flavioalsoares/hsm-a7/doc/manual/08-apendices.md

# Apêndices

## A. Glossário

**APT** — *Adaptive Proportion Test*. Teste de saúde de fonte de entropia
(SP 800-90B) que dispara quando um valor domina uma janela de amostras.

**BBRAM** — memória volátil do FPGA onde pode ficar a chave de decifra do
bitstream. Perde conteúdo sem alimentação, e por isso é recuperável — ao
contrário do eFUSE.

**BDK** — *Base Derivation Key*. Chave de pagamentos da qual se derivam
chaves de terminal, tipicamente por DUKPT.

**CFS** — *Custom Functions Subsystem*. Slot do NEORV32 projetado para
receber coprocessadores do usuário. É onde AES e SHA entram na Fase 2.

**CMAC** — código de autenticação de mensagem baseado em cifra de bloco.
Usado no TR-31 para autenticar cabeçalho e corpo, e para derivar KBEK/KBAK.

**CMVP** — programa NIST/CCCS que valida módulos contra a FIPS 140-3.

**CSP** — *Critical Security Parameter*. Termo da FIPS para qualquer segredo
cuja divulgação compromete a segurança: chave em claro, dado de autenticação,
estado do gerador.

**Dual control** — nenhuma operação sensível pode ser realizada por uma
pessoa sozinha. Ver seção 7.

**DRBG** — *Deterministic Random Bit Generator*. Gerador determinístico
semeado por entropia física, especificado na SP 800-90A.

**CVV / CVC** — três dígitos derivados de PAN, validade e código de serviço
sob um par de chaves. Inerentemente 3DES, e por isso fora do alcance deste
projeto (seção 37).

**Decimalização** — mapear os dígitos hexadecimais que uma cifra produz
para dígitos decimais, para formar um PIN. A tabela que faz esse mapeamento
foi a origem do ataque de Bond e Zieliński (seções 15.2 e 35.3).

**DUKPT** — *Derived Unique Key Per Transaction*. Esquema em que cada
transação usa uma chave distinta derivada de uma BDK, identificada por um
KSN. Duas normas: X9.24-1 (TDES, legado) e X9.24-3 (AES). Seção 36.

**eFUSE** — memória de programação única do FPGA. **Proibida neste
projeto**: erro vira brick permanente.

**EAL** — *Evaluation Assurance Level*, do Common Criteria. Mede o rigor da
avaliação, **não** a força da segurança.

**Fronteira criptográfica** — o limite físico e lógico dentro do qual
material de chave em claro existe. Ver seção 5.

**KAT** — *Known Answer Test*. Vetor de teste com entrada e saída conhecidas,
usado nos autotestes.

**KBEK / KBAK** — chaves de cifra e de autenticação de key block, derivadas
da LMK por propósito.

**KCV** — *Key Check Value*. Três bytes do resultado de cifrar um bloco de
zeros com a chave. Permite verificar sem revelar.

**KSN** — *Key Serial Number*. Identificador do dispositivo mais o contador
de transação, enviado junto com cada transação DUKPT. Com ele e a BDK, o HSM
rederiva a chave usada. Seção 36.

**KEK** — *Key Encryption Key*. Chave cuja função é proteger outras chaves.

**LMK** — *Local Master Key*. A chave mestra do módulo, no topo da
hierarquia. Nunca sai, nem embrulhada.

**MMCM** — *Mixed-Mode Clock Manager*. Bloco do FPGA Xilinx que sintetiza
clocks. Aqui, 50 → 100 MHz.

**PAN** — *Primary Account Number*. O número do cartão. Entra na formação
do PIN block para amarrar o PIN à conta. **Nunca usar um PAN real neste
projeto** (seção 37.4).

**PIN block** — formato que combina PIN e número da conta para transporte.
Os formatos da ISO 9564 e suas fraquezas estão na seção 33; os ataques
clássicos, na 15.3.

**PVV** — *PIN Verification Value*. Quatro dígitos derivados de PAN e PIN
sob uma chave PVK, guardados pelo emissor no lugar do PIN. Seção 35.1.

**PMP** — *Physical Memory Protection*. Mecanismo RISC-V de restrição de
acesso à memória por região.

**POST** — *Power-On Self-Test*. Bateria de KAT executada no boot, antes de
aceitar comandos.

**PUF** — *Physically Unclonable Function*. Raiz de confiança derivada de
variações de fabricação, em vez de armazenada.

**RCT** — *Repetition Count Test*. Teste de saúde que dispara na repetição
excessiva de uma amostra.

**Split knowledge** — nenhuma pessoa conhece uma chave inteira; ela é
montada de componentes.

**Tamper-evident / resistant / responsive** — a escada de proteção física.
Ver seção 18.1.

**Tradução de PIN** — decifrar um PIN block sob uma chave e recifrá-lo sob
outra, sem que o PIN saia da fronteira. É o comando mais perigoso de um HSM
de pagamento, porque é um oráculo por construção. Seção 34.

**TR-31** — formato de key block da indústria de pagamentos, hoje ANSI
X9.143. É o formato adotado por este projeto (seção 8).

**TRNG** — gerador de números aleatórios verdadeiro, baseado em fenômeno
físico.

**Zeroização** — destruição de material de chave de forma verificável. Ver
seção 12.

## B. Especificação do protocolo

Implementado em `fw/src/cmd.c` (firmware) e `host/hsmtool.py` (host).

### Enquadramento

```
pedido    LEN(2) | CMD(1)    | PAYLOAD | CRC32(4)
resposta  LEN(2) | STATUS(1) | PAYLOAD | CRC32(4)
```

- Todos os campos multi-byte em **big-endian**.
- `LEN` cobre `CMD`/`STATUS` + `PAYLOAD`. Não se inclui nem inclui o CRC.
- `LEN` válido: 1 a 513 (payload máximo de 512 bytes).
- **CRC32** cobre `LEN` + `CMD`/`STATUS` + `PAYLOAD` — todos os bytes menos
  os quatro dele próprio. Polinômio IEEE 802.3 refletido (`0xEDB88320`),
  inicialização `0xFFFFFFFF`, xor final `0xFFFFFFFF`. Idêntico ao
  `zlib.crc32` do Python.
- Timeout entre bytes no dispositivo: 250 ms. Timeout de resposta no host:
  2 s.

### Comandos da Fase 1

| Opcode | Nome | Payload do pedido | Payload da resposta |
|---|---|---|---|
| `0x01` | `PING` | vazio | `"PONG"` |
| `0x02` | `GET_VERSION` | vazio | major, minor, patch, estado |
| `0x03` | `GET_DNA` | vazio | 8 bytes: identidade do die, 57 bits big-endian |

O `GET_DNA` ficou respondendo `NOT_IMPLEMENTED` durante toda a Fase 1 e só
fechou com o CFS da Fase 2 (seção 25) — o `DNA_PORT` é primitiva Xilinx e
precisava de um caminho até a CPU. O valor **não é segredo**: qualquer um com
um cabo JTAG lê o mesmo número, e ele nunca muda. Serve para identificar a
placa em log e inventário. Derivar chave dele é um erro clássico, porque
público e constante são exatamente as duas propriedades que uma chave não
pode ter.

### Comandos da Fase 2 — primitivas

| Opcode | Nome | Payload do pedido | Payload da resposta |
|---|---|---|---|
| `0x10` | `AES_ENC` | chave(32) ‖ bloco(16) | bloco(16) |
| `0x11` | `AES_DEC` | chave(32) ‖ bloco(16) | bloco(16) |
| `0x12` | `SHA256` | mensagem | digest(32) |
| `0x13` | `HMAC` | klen(1) ‖ chave ‖ mensagem | mac(32) |
| `0x14` | `RANDOM` | n(2), máximo 256 | n bytes do CTR_DRBG |
| `0x15` | `SELFTEST` | vazio | máscara de falhas(2) |

⚠ **`AES_ENC`, `AES_DEC` e `HMAC` recebem a chave em claro no payload**, e
por isso só respondem em `UNINITIALIZED`. Não é convenção: é a máscara de
estados na tabela de comandos. Um comando que aceita chave em claro não pode
coexistir com chave de verdade no mesmo dispositivo — e no instante em que a
LMK é carregada, os três param de responder sozinhos. A Fase 3 os
**substitui** por versões que falam por handle de slot.

O `SELFTEST` é o único comando que responde em `TAMPERED`, e a exceção é
deliberada: sem ele, um dispositivo que reprovou no boot ficaria mudo sobre
*o que* reprovou, e o operador teria apenas um LED vermelho.

### Comandos da Fase 3 — hierarquia de chaves

| Opcode | Nome | Payload do pedido | Payload da resposta |
|---|---|---|---|
| `0x20` | `LMK_LOAD_COMPONENT` | n(1) ‖ componente(32) | kcv(3) ‖ carregados(1) ‖ estado(1) |
| `0x21` | `LMK_STATUS` | vazio | carregados(1) ‖ completa(1) ‖ kcv(3) |
| `0x22` | `GEN_KEY` | uso(2) ‖ alg(1) ‖ modo(1) ‖ exp(1) | handle(1) ‖ kcv(3) |
| `0x23` | `EXPORT_KEY` | handle(1) | key block X9.143 em ASCII |
| `0x24` | `IMPORT_KEY` | key block X9.143 em ASCII | handle(1) ‖ kcv(3) |
| `0x25` | `KEY_INFO` | handle(1) | uso(2) ‖ alg(1) ‖ modo(1) ‖ exp(1) ‖ len(1) ‖ kcv(3) ‖ usos(4) |
| `0x26` | `SET_STATE` | estado alvo(1) | estado atual(1) |
| `0x27` | `ENCRYPT` | handle(1) ‖ iv(16) ‖ dados | dados cifrados |
| `0x28` | `DECRYPT` | handle(1) ‖ iv(16) ‖ dados | dados em claro |
| `0x29` | `MAC_GENERATE` | handle(1) ‖ mensagem | tag(16) |
| `0x2A` | `MAC_VERIFY` | handle(1) ‖ tag(16) ‖ mensagem | vazio — o veredito é o status |
| `0x2B` | `DELETE_KEY` | handle(1) | slots livres(1) |
| `0x2C` | `KEY_FROM_COMPONENTS` | n(1) ‖ total(1) ‖ uso(2) ‖ alg(1) ‖ modo(1) ‖ exp(1) ‖ componente(32) | kcv(3) ‖ carregados(1) ‖ total(1) ‖ handle(1) |
| `0x2F` | `ZEROIZE` | vazio | estado atual(1) |

**Estados em que cada um responde.** Não é convenção — é uma máscara na
tabela de comandos, e é ela que faz a cerimônia ser uma escada de uma via.

| Comando | Estados |
|---|---|
| `LMK_LOAD_COMPONENT` | só `UNINITIALIZED` |
| `SET_STATE` | só `AUTHORIZED` |
| `GEN_KEY`, `EXPORT_KEY`, `IMPORT_KEY`, `KEY_INFO`, `ENCRYPT`, `DECRYPT`, `MAC_GENERATE`, `MAC_VERIFY`, `DELETE_KEY`, `KEY_FROM_COMPONENTS` | só `OPERATIONAL` |
| `LMK_STATUS` | os três normais |
| `ZEROIZE` | **todos**, `TAMPERED` inclusive |

Carregar os três componentes leva a `AUTHORIZED` e o `0x20` desaparece
sozinho; ativar leva a `OPERATIONAL` e o `0x26` desaparece do mesmo jeito.
Nenhum degrau se repete, e não há como descer sem apagar.

**Quais exigem dual control**, e a divisão diz mais que a lista:

| | |
|---|---|
| exigem | `LMK_LOAD_COMPONENT`, `SET_STATE`, `ZEROIZE`, `KEY_FROM_COMPONENTS` |
| não exigem | `GEN_KEY`, `EXPORT_KEY`, `IMPORT_KEY`, `KEY_INFO`, `ENCRYPT`, `DECRYPT`, `MAC_GENERATE`, `MAC_VERIFY`, `DELETE_KEY` |

Dual control é para **cerimônia**, não para operação. Carregar a chave
mestra, ativar o dispositivo e apagar tudo são eventos raros, com gente na
frente da placa. Gerar, exportar e importar chave é o que um HSM faz o dia
inteiro — exigir dois dedos ali não aumentaria segurança nenhuma, só
garantiria que ninguém usa o equipamento. E um controle que impede o uso
legítimo é desligado no primeiro dia ruim.

O que protege os quatro de baixo é outra coisa, e é estrutural: a chave
nunca sai em claro, o key block é autenticado sobre cabeçalho **mais**
corpo, e `exportabilidade` decide quem pode sair.

⚠ **O `ZEROIZE` tem uma assimetria deliberada.** O comando exige dois
operadores; o gatilho **automático** — autoteste reprovado — não exige
ninguém. Se ele exigisse, bastaria não haver operador na sala para a chave
sobreviver ao comprometimento.

**Notas por comando:**

- **`GEN_KEY`** — a chave vem do CTR_DRBG do dispositivo e **nunca existe
  fora da fronteira**. O host escolhe os metadados e recebe handle e KCV. É
  o contraste que a fase inteira ensina: o `AES_ENC` da Fase 2 recebia a
  chave *no payload*.
- **`EXPORT_KEY`** — o único comando que faz material de chave atravessar a
  fronteira, e ele atravessa embrulhado. Respeita `exportabilidade`: um
  slot marcado `'N'` devolve `NOT_EXPORTABLE`. Exportar o mesmo slot duas
  vezes dá blocos **diferentes**, porque o enchimento é aleatório — dois
  blocos idênticos denunciariam que a mesma chave saiu duas vezes.
- **`IMPORT_KEY`** — os metadados vêm **do bloco**, autenticados pelo MAC.
  Toda recusa devolve o mesmo `BAD_PARAM`: bloco malformado, hexadecimal
  inválido, MAC errado e comprimento impossível são indistinguíveis de
  fora. Distinguir em qual etapa a validação parou é o oráculo de padding
  clássico.
- **`KEY_INFO`** — metadados, nunca chave. Handle inválido e slot vazio
  devolvem o mesmo código: separar permitiria mapear o key store sem
  instalar nada.
- **`ENCRYPT` / `DECRYPT`** — usar a chave guardada, referida por
  **handle**. É o contraste que fecha a fase: os comandos da Fase 2
  recebiam a chave no pedido; aqui vai um número de gaveta.

  **AES-CBC com IV explícito**, e não ECB — ECB para dados é o erro que a
  seção 16 usa como exemplo. O IV vem de quem chama, porque uma função que
  puxa entropia sozinha não é testável de forma determinística.

  O `uso` e o `modo` do slot decidem: só uma chave de dados (`D0`) cifra, e
  uma marcada `'E'` (só cifrar) recusa `DECRYPT` com `BAD_KEY_USE`. E `exportabilidade='N'` **não** impede usar
  — não poder sair é diferente de não poder trabalhar.

  ⚠ **É um oráculo de cifragem, e vale dizer.** Quem tem o handle cifra e
  decifra o que quiser sob aquela chave, em laço. Não há como não ser — é o
  serviço que um HSM presta. O que ele não entrega é a chave, e é para isso
  que o handle existe. O controle real está no `modo` e no log de auditoria.
- **`MAC_GENERATE` / `MAC_VERIFY`** — CMAC-AES sob a chave de um slot. Os
  modos de uso se dividem em **dois grupos que não se cruzam**: `E`/`D`/`B`
  cifram, `G`/`V`/`C` autenticam. Uma chave de cifra não assina, e uma de
  MAC não cifra — é assim que a confusão de tipo de chave se fecha.

  ⚠ **`MAC_VERIFY` devolve um bit**, no status. O dispositivo compara em
  tempo constante, do lado de dentro. Devolver a tag calculada para quem
  perguntou comparar entregaria 128 bits em vez de 1, e reabriria o canal
  lateral de tempo que a comparação interna existe para fechar.
- **`DELETE_KEY`** — apaga **um** slot, e **não pede dual control**. A
  assimetria com o `ZEROIZE` é deliberada: apagar um é reversível, porque o
  key block daquela chave continua existindo fora do equipamento. Apagar
  tudo não é.
- **`KEY_FROM_COMPONENTS`** — a cerimônia da chave mestra aplicada a uma
  chave de trabalho: cada custodiante entra com a sua parte, ninguém vê a
  chave inteira, e o equipamento monta por XOR do lado de dentro.

  **É o único comando de operação que exige dual control**, e por isso: é
  cerimônia, não operação. Aperto novo a cada componente.

  O KCV que volta é o **do componente**, nunca o do acumulado — é o que
  permite ao custodiante conferir que digitou o dele. E a resposta tem
  comprimento fixo, com handle zero enquanto a montagem não termina.

O `0x20` e o `0x26` exigem **dual control**: os dois botões pressionados no
instante em que o frame chega, e um aperto *novo* a cada autorização (seção
26). São os únicos comandos do projeto cuja autorização não está no link do
host — o que é o ponto inteiro deles.

O KCV que o `0x20` devolve é o do **componente**, não o da LMK acumulada. O
`0x21` devolve o da LMK, e só quando ela está completa; enquanto incompleta,
os três bytes vêm zerados, e a resposta mantém o comprimento fixo para que o
tamanho do frame não anuncie nada.

Uma LMK **zerada** é recusada no terceiro componente com `BAD_PARAM`, e a
cerimônia recomeça do componente 0 — não há como saber qual dos três estava
errado. Acontece se o último componente for o XOR dos dois primeiros: cada
um parece aleatório, e a soma é zero. LMK *fraca* (de pouca entropia) não é
checada; a qualidade do componente é responsabilidade do custodiante.

### Comando da Fase 4 — log de auditoria

| Opcode | Nome | Pedido | Resposta | Estados |
|---|---|---|---|---|
| `0x2D` | `AUDIT_READ` | seq inicial (4) | próximo (4) ‖ continuar (4) ‖ até 16 registros de 16 bytes | todos |

Cada registro: `seq(4) | comando(1) | estado(1) | argumento(1) | resultado(1)
| reservado(4) | crc32(4)`. Comando `0x00` é o boot; resultado `0xFF` é
"pendente", um comando que começou e não terminou. Comando `0x0F` é uma
violação de ambiente, com a causa no argumento.

### Comando da Fase 6 — sensores

| Opcode | Nome | Pedido | Resposta | Estados |
|---|---|---|---|---|
| `0x2E` | `ENV_READ` | vazio | retido (1) ‖ agora (1) ‖ válido (1) ‖ temperatura, VCCINT, VCCAUX, VCCBRAM (2 cada) | todos |

Os quatro valores são códigos de 12 bits do XADC, e `hsmtool env` os converte.

### Porta host — command set ASCII (Fase 5)

Tudo acima é o **console**. A porta **host** usa a mesma UART com mensagens
ASCII, enquadradas pelo mesmo `LEN` de 2 bytes e **sem CRC**:

```
pedido     LEN(2) | cabeçalho(4) | comando(2) | campos
resposta   LEN(2) | cabeçalho(4) | resposta(2) | erro(2) | campos
```

O primeiro byte do corpo separa os protocolos: de `'0'` a `'~'` é ASCII, e
qualquer outro é opcode binário. O cabeçalho é do host e volta igual; a
resposta é o comando com o segundo caractere mais um.

A chave de trabalho vai **no comando**, como key block X9.143 sob a LMK. O
comprimento do bloco sai do próprio cabeçalho dele. Dados vão como
comprimento em 4 dígitos decimais seguido de hex.

| Pedido | Resposta | Campos do pedido | Campos da resposta | Estados |
|---|---|---|---|---|
| `D0` | `D1` | — | estado(1) ‖ KCV da LMK(6) ‖ versão(6) | todos menos `TAMPERED` |
| `K0` | `K1` | uso(2) ‖ modo(1) ‖ exportabilidade(1) | key block ‖ KCV(6) | `OPERATIONAL` |
| `K2` | `K3` | key block | uso(2) ‖ alg(1) ‖ modo(1) ‖ exp(1) ‖ KCV(6) | `OPERATIONAL` |
| `K4` | `K5` | bloco da KEK ‖ bloco da chave (os dois sob a LMK) | bloco da chave sob a KEK ‖ KCV(6) | `OPERATIONAL` |
| `K6` | `K7` | bloco da KEK (sob a LMK) ‖ bloco da chave (sob a KEK) | bloco da chave sob a LMK ‖ KCV(6) | `OPERATIONAL` |
| `C0` | `C1` | key block ‖ IV(32) ‖ dados | dados | `OPERATIONAL` |
| `C2` | `C3` | key block ‖ IV(32) ‖ dados | dados | `OPERATIONAL` |
| `M0` | `M1` | key block ‖ dados | MAC(32) | `OPERATIONAL` |
| `M2` | `M3` | key block ‖ MAC(32) ‖ dados | — (o veredito é o erro) | `OPERATIONAL` |
| `R0` | `R1` | exportabilidade(1) | key block ‖ n(512) ‖ e(8) | `OPERATIONAL` |
| `R2` | `R3` | key block ‖ digest(64) | assinatura(512) | `OPERATIONAL` |
| `R4` | `R5` | n(512) ‖ e(8) ‖ digest(64) ‖ assinatura(512) | — (o veredito é o erro) | `OPERATIONAL` |
| `E0` | `E1` | exportabilidade(1) | key block ‖ Qx(64) ‖ Qy(64) | `OPERATIONAL` |
| `E2` | `E3` | key block ‖ digest(64) | r(64) ‖ s(64) | `OPERATIONAL` |
| `E4` | `E5` | Qx(64) ‖ Qy(64) ‖ digest(64) ‖ r(64) ‖ s(64) | — (o veredito é o erro) | `OPERATIONAL` |

Erros: `00` sem erro · `01` verificação falhou · `10` key block inválido ·
`11` o uso ou o modo do bloco não permite · `12` chave não exportável · `13` o
bloco de proteção não é KEK · `15` dados inválidos · `16` parâmetro
inválido · `20` estado não permite · `21` comando desconhecido · `22`
mensagem malformada · `27` falha no log · `90` erro interno · `91` erro grave. Os códigos de
comando e de erro são deste projeto.

Os comandos `R` são de RSA-2048 e os `E`, de ECDSA sobre a curva P-256. O
digest é SHA-256, calculado pelo host. A seção 30 explica os dois.

`K4` e `K6` trocam chave com outra instituição sob uma **KEK** — chave de
uso `K0` que as duas têm, formada por componentes no console
(`comp-load --uso K0`). `K4` é exportar e recusa `'N'`; `K6` guarda o que
chegou sob a LMK. O `modo` da KEK diz se ela embrulha (`E`), desembrulha
(`D`) ou os dois (`B`).

No log de auditoria, um comando da porta host aparece com os dois
caracteres dele nos campos `comando` e `argumento` (`K0` = `0x4B`, `0x30`) e
o código de erro em decimal no `resultado`.

### Códigos de status

| Código | Nome | Significado |
|---|---|---|
| `0x00` | `OK` | |
| `0x01` | `BAD_CRC` | CRC não confere |
| `0x02` | `BAD_LEN` | `LEN` fora da faixa |
| `0x03` | `TIMEOUT` | frame incompleto, resincronizado |
| `0x10` | `UNKNOWN_CMD` | opcode não está na tabela |
| `0x11` | `BAD_PARAM` | tamanho ou conteúdo do payload |
| `0x12` | `NOT_IMPLEMENTED` | na tabela, sem implementação ainda |
| `0x20` | `WRONG_STATE` | comando não permitido neste estado |
| `0x21` | `NOT_AUTHORIZED` | falta dual control |
| `0x22` | `NOT_EXPORTABLE` | exportabilidade do slot proíbe |
| `0x23` | `NO_SLOT` | key store cheio |
| `0x24` | `BAD_KEY_USE` | o `uso` ou o `modo` do slot proíbe a operação |
| `0x25` | `MAC_INVALID` | o MAC não confere |
| `0x26` | `STORE_FAIL` | fase 4: a flash não gravou; a operação foi desfeita |
| `0x27` | `LOG_FAIL` | fase 4: sem registro no log, o comando não executa |
| `0x30` | `SELFTEST_FAIL` | |
| `0x32` | `CRYPTO_FAIL` | A dupla execução discordou: nada sai, as chaves ficam e o dispositivo marca erro grave |
| `0x31` | `TAMPERED` | |
| `0xFF` | `INTERNAL_ERROR` | |

### Exemplo verificado em hardware

```
    pedido   : 00 01 01 91 5D D8 C5
    resposta : 00 05 00 50 4F 4E 47 FB 28 3D 2A
                     ^^  P  O  N  G
```

`91 5D D8 C5` é `zlib.crc32(b'\x00\x01\x01')`.

## C. Pinagem

Fonte: esquemáticos QMTECH e verificação em hardware. Detalhes e procedência
em `doc/pinout.md`.

| Função | Pino | Estado |
|---|---|---|
| Clock 50 MHz | N11 | verificado em hardware |
| Reset (SW1) | B7 | esquemático; ativo baixo |
| UART RX / TX | T15 / T14 | verificado em hardware |
| Dual control A (SW2) | M6 | verificado em hardware; ativo baixo |
| Dual control B (SW5) | P6 | verificado em hardware; ativo baixo |
| LEDs D1–D5 | R6, T5, R7, T7, R8 | verificados; **ativos baixos**; todos vermelhos |
| 7 segmentos | T10, K13, P11, R11, R10, N9, K12, P9 | `a`…`g`, `dp`; **acende com 0** |
| Dígitos (varredura) | T9, P10, T8 | 3 dígitos; **habilita com 1** |

**Armadilha registrada:** com o gravador ligado existem **duas** portas
seriais. O adaptador JTAG usado é um FT232H que também cria `/dev/ttyUSB*`, e
costuma enumerar **antes** da placa. Escolher a porta por ordem alfabética
acerta o cabo de gravação, e o sintoma é um timeout sem explicação. A
ferramenta de host escolhe por identificador USB por causa disso.

**Nenhuma pendência de pinagem.** As três que existiam — cores dos LEDs,
polaridade do display e ordem física dos botões — foram fechadas por medida
em hardware, e duas delas mudaram o projeto:

- **Os cinco LEDs são vermelhos.** O requisito "LED vermelho para
  `TAMPERED`" está atendido e ao mesmo tempo vazio: **cor não distingue nada
  nesta placa**. Um indicador de estado tem de se separar por *posição* e
  *padrão* — e é o display que carrega a informação de verdade.
- **A polaridade do display estava invertida no código**, por palpite. O
  segmento acende com `0` e o dígito habilita com `1`; o toplevel supunha o
  contrário. Não aparecia porque, com os segmentos desligados, habilitar ou
  não os dígitos dá no mesmo — apareceria no primeiro estado exibido.

O detalhe que fecha o assunto: **um testbench conferia o valor errado e
passou meses verde**, porque afirmava a suposição em vez de uma medida.

## D. Reproduzir o trabalho

### Dependências

```bash
git clone --recurse-submodules <url>

sudo apt install -y gcc-riscv64-unknown-elf picolibc-riscv64-unknown-elf
sudo apt install -y python3-serial openfpgaloader
```

Vivado 2026.1 (o `xsim` também é usado na simulação, por causa das primitivas
Xilinx e do VHDL do NEORV32).

O compilador sozinho não basta: ele fornece apenas os headers freestanding, e
o header do NEORV32 precisa de uma biblioteca C. Não há `libnewlib` para
RISC-V nos repositórios Debian; picolibc é o equivalente.

### Construir e testar

```bash
source /opt/AMD/2026.1/Vivado/settings64.sh

./scripts/sim.sh                 # todos os testbenches; recompila o
                                 # firmware sozinho se o C estiver mais novo
make -C fw image                 # o build da FPGA depende desta imagem
vivado -mode batch -source scripts/build.tcl

./scripts/program.sh flash       # grava na SPI flash

python3 host/hsmtool.py selftest # sem placa: o codec do protocolo
python3 host/test_hsmtool.py     # sem placa: o transporte
python3 host/test_tr31.py        # sem placa: o key block (precisa de
                                 # `cryptography`)
python3 host/hsmtool.py ping
python3 host/hsmtool.py bench -n 10000
```

⚠ **`flash`, e não a RAM de configuração.** O firmware mora na Block RAM de
instruções, cujo conteúdo inicial vem do bitstream. Configurar por JTAG
pode deixar a placa com `Done = 1`, o clock travado e a CPU **sem executar
uma instrução** — porque a inicialização das Block RAMs não foi aplicada.
O sintoma é cruel: tudo indica sucesso e o dispositivo está mudo. Detalhes
e discriminadores de falha em `doc/bancada.md`.

⚠ **`sim.sh` recompila o firmware quando o C está mais novo que a imagem.**
Até isso existir, editar C e simular validava o **binário anterior** — e o
modo como isso foi descoberto está em `doc/fase3-notas.md`: uma sabotagem
deliberada do código passou na simulação, porque o código sabotado nunca
chegou a ser compilado.

### Política de código de terceiros

Nunca editar `third_party/` diretamente: a mudança não fica guardada no
repositório, é descartada por `git submodule update`, e quebra a procedência
— o pin continua dizendo `v1.13.3` enquanto o bitstream contém outra coisa.

Ordem para mudar código externo:

1. **Configuração** (generic no wrapper) — resolve quase sempre
2. **Ponto de extensão projetado** — é o caso do CFS na Fase 2
3. **Patch** em `patches/`, aplicado pelo build
4. **Fork** e repontar o submódulo — só com patch que precise persistir

Detalhes em `doc/submodulos.md`. O espelho offline reproduzível dos cores
externos sai de `./scripts/mirror-deps.sh`.

## E. Operar o dispositivo

O apêndice D ensina a **construir**. Este ensina a **usar** — uma sessão
inteira, do power-on até o dispositivo operacional, com o que cada resposta
significa.

Tudo daqui é feito com `host/hsmtool.py`, que fala o protocolo do apêndice B
pela UART do CP2102 (115200 8N1, a mesma porta USB que alimenta o core
board).

### E.1 Ligar e conferir

O bitstream mora na **flash SPI**, então a placa sobe sozinha na
energização. Não há nada a carregar.

**Antes de digitar qualquer coisa, olhe o display.** Ele soletra o estado:

```
    U n i      UNINITIALIZED   sem chave mestra
    A u t      AUTHORIZED      LMK carregada, ainda não em serviço
    O P E      OPERATIONAL     em serviço
    t P r      TAMPERED        reprovou, e não sai daí por software
```

Isso é o dispositivo dizendo em que estado está **sem que ninguém pergunte**
— e é a única informação que ele oferece de graça. Confirme depois pela
serial, que é o canal com autoridade:

```bash
python3 host/hsmtool.py version
```

```
firmware : v0.1.0
estado   : UNINITIALIZED (0)
```

`UNINITIALIZED` é o estado de fábrica: o dispositivo funciona, mas não
guarda chave nenhuma.

**Antes de qualquer outra coisa, o autoteste.** Ele já rodou no boot — o
`SELFTEST` apenas o repete, e é assim que se confere que o módulo continua
calculando certo *agora*, não só quando ligou:

```bash
python3 host/hsmtool.py post
```

```
AES-256                ok
SHA-256                ok
HMAC-SHA-256           ok
CTR_DRBG               ok
TRNG / health tests    ok
CMAC-AES-256           ok
key store              ok
key block X9.143       ok
```

Oito linhas, oito verdades diferentes.

As cinco primeiras são respostas conhecidas contra vetores oficiais
(seção 11) — exceto a quinta, que são os **testes de partida** da fonte de
entropia sobre um retrato de 1024 amostras brutas (seção 10).

As três últimas são de natureza diferente e vale distinguir, porque a norma
distingue: **testes de função crítica**, não de algoritmo. Não existe
"resposta conhecida" para instalar uma chave — existem propriedades que, se
falharem, tornam o dispositivo perigoso *sem parecer quebrado*:

- **key store** — uma chave marcada como não exportável não sai; um slot
  apagado não responde; uma chave de cifrar não é aceita para decifrar; e a
  zeroização, depois de rodar, não deixou um byte diferente de zero na
  região de chaves;
- **key block X9.143** — um key block de procedência externa é
  desembrulhado e devolve a chave certa; um cabeçalho adulterado é recusado;
  e uma ida-e-volta fecha.

⚠ Sobre esse último vale uma ressalva de procedência que não aparece em
nenhum outro: **o vetor dele não é do CAVP, e não há como ser.** O programa
de validação do NIST valida *algoritmo*, e X9.143 é *formato*; a norma que
traz o exemplo é paga. O que se usa é um valor conhecido de terceiros,
fixado por commit e por hash. Está registrado em `vectors/MANIFEST.txt` em
vez de dissimulado entre os demais.

⚠ **O autoteste zera a memória de trabalho.** O teste do key store instala e
apaga chaves de verdade e termina com o store vazio, chave mestra inclusive.
Um autoteste que poupasse a chave exercitaria um caminho que não é o do boot.
Até a Fase 3, rodá-lo num dispositivo carregado apagava a LMK; desde a Fase 4
o dispositivo restaura tudo da flash em seguida e volta ao estado em que
estava.

**Se alguma reprovar**, o dispositivo vai para `TAMPERED` e passa a atender
**só** ao `SELFTEST`. Isso é o comportamento correto, e a exceção é
deliberada: sem ela o operador teria apenas um LED vermelho e nenhuma
informação sobre *o que* falhou.

### E.2 O que dá para fazer antes de haver chave

Em `UNINITIALIZED` o dispositivo é uma caixa de primitivas. Estes comandos
recebem a chave **no payload**, o que um HSM de verdade jamais aceitaria:

```bash
python3 host/hsmtool.py sha256 616263          # SHA-256 de "abc"
python3 host/hsmtool.py aes <chave-hex> <bloco-hex>
python3 host/hsmtool.py random -n 32           # bytes do CTR_DRBG
```

Eles existem para exercitar o hardware antes de existir key store, e **param
de responder no instante em que houver LMK** — não por uma linha de código
que os desligue, mas porque a máscara de estados deles diz `UNINITIALIZED` e
o dispositivo não estará mais lá. Guarde isso: é a demonstração mais limpa
de por que estado importa num HSM.

O `random` é o único dos quatro que continua funcionando depois. Ele não
recebe chave nenhuma.

### E.3 A cerimônia de LMK

A **Local Master Key** é a raiz da hierarquia (seção 7): é ela que embrulha
todas as demais. Ela não é digitada por uma pessoa. Ela nasce de **três
componentes**, cada um sob a guarda de um custodiante diferente, que se
combinam por XOR dentro do dispositivo.

Por que XOR e por que três: nenhum componente isolado revela **nada** sobre
a chave — nem um bit — e conhecer dois de três não ajuda. Três é prática
operacional, não criptografia: dois custodiantes não dão margem se um faltar
no dia, e mais de três transforma a cerimônia em logística.

**O gesto físico.** Cada componente exige dois botões da placa pressionados
no instante em que o comando chega. São o **2º e o 5º** de uma fileira de
cinco, cujo primeiro é o reset:

```
    [reset]  [ * ]   [   ]   [   ]   [ * ]
      SW1     SW2     SW3     SW4     SW5
```

O par mais afastado disponível, para dificultar apertar os dois com uma mão
só. O `hsmtool.py` desenha esse mapa a cada pedido, porque ler silkscreen
minúsculo no meio de uma cerimônia é como se aperta o botão errado.

**E o dispositivo confirma.** Aperte os dois: o **ponto decimal** do dígito
da direita acende. Solte: apaga.

```
    U n i.        os dois botões apertados, autorização disponível
    U n i         não
```

Esse ponto é a resposta de bancada para "que botões?" — em vez de confiar
num rótulo, aperte e veja o dispositivo concordar. Se acendeu, o comando
seguinte vai ser autorizado; se não acendeu, seria recusado, e você descobre
isso **antes** de gastar o comando em vez de depois.

Ele não vaza nada: quem está apertando os botões já está na frente da placa,
e não há observador remoto para quem a informação seja novidade.

E exige um aperto
**novo**: entre um componente e o seguinte, os dois têm de ser vistos
**soltos**. Segurar os dois durante a cerimônia inteira carrega **um**
componente, não três (seção 26).

```bash
python3 host/hsmtool.py lmk-status
```

```
componentes : 0 de 3
KCV da LMK  : -- (incompleta)
```

Agora cada componente, um de cada vez:

```bash
python3 host/hsmtool.py lmk-load 0 --random
```

O `--random` gera o componente **no host** e o imprime na tela. Isso é uma
concessão de brinquedo, e o próprio comando avisa: material de chave na tela
é exatamente o que um HSM existe para evitar. Num equipamento real cada
componente nasce com o seu custodiante, num cartão ou num dispositivo de
entrada dedicado. Para fornecer um componente existente, passe-o em hex no
lugar de `--random`.

A ferramenta então pede o gesto e espera:

```
Carregar o componente 0 da LMK.
  SOLTE os dois botoes, depois SEGURE SW2 e SW5 juntos
  e tecle Enter sem soltar.
```

Segure os dois, tecle Enter sem soltar, e a resposta volta:

```
KCV do componente : 539062
componentes       : 1 de 3
estado            : UNINITIALIZED (0)
```

**O KCV que volta é o do componente, não o da LMK.** É o que permite ao
custodiante conferir, ali, que digitou o dele e não o do vizinho. Sem esse
passo, um componente trocado só apareceria no KCV final — quando já não dá
para saber qual dos três estava errado. Confira contra o valor que o
custodiante trouxe anotado; se não bater, **pare a cerimônia**.

Repita para os componentes `1` e `2`. Ao terceiro:

```
componentes       : 3 de 3
estado            : AUTHORIZED (1)
```

O estado muda no mesmo comando que completa a chave, e não num comando
separado: *"tenho LMK"* e *"estou em AUTHORIZED"* precisam ser a mesma
afirmação, ou o estado vira opinião.

```bash
python3 host/hsmtool.py lmk-status
```

```
componentes : 3 de 3
KCV da LMK  : 46F2FB
```

Anote esse KCV. Ele é a única coisa derivada da LMK que atravessa a
fronteira, e é como se confere, em qualquer sessão futura, que o dispositivo
tem a chave certa — sem que ninguém veja a chave. Três bytes dão uma
colisão em 16 milhões: basta para pegar erro de digitação, e não basta para
atacar.

**Se `STATUS_NOT_AUTHORIZED` voltar**, os botões não estavam apertados — ou
estavam apertados desde a autorização anterior. Solte, aperte e repita. Essa
recusa é a única prova de que o dual control existe de verdade: é o único
comando do dispositivo cuja autorização não está no link do host.

### E.4 Ativar

`AUTHORIZED` significa "tenho a raiz". `OPERATIONAL` significa "estou em
serviço". A passagem é um ato de cerimônia, também com dual control:

```bash
python3 host/hsmtool.py activate
```

```
estado : OPERATIONAL (2)
```

**Repare no que desapareceu.** Tente agora:

```bash
python3 host/hsmtool.py aes <chave> <bloco>
```

```
dispositivo recusou: STATUS_WRONG_STATE (0x20)
```

O comando que aceitava chave em claro não existe mais neste estado. E a
própria cerimônia também não se repete — não há caminho para trocar a chave
mestra por cima da existente, o que seria substituir a raiz sem apagar o que
ela protege. A escada é de **uma via só**, e descer exige apagar.

### E.5 Os indicadores da placa

**O display de 7 segmentos é o indicador que importa**, e há um motivo
concreto: os cinco LEDs desta placa são **todos vermelhos**. A cor não
carrega informação nenhuma, só a posição — o requisito "LED vermelho para
`TAMPERED`" está atendido e vazio.

| O que mostra | Significado |
|---|---|
| `Uni` `Aut` `OPE` `tPr` | o estado da máquina (seção 8) |
| ponto decimal aceso | dual control satisfeito **neste instante** |

Um detalhe de projeto que vale registrar: se os dois bits de estado
chegarem corrompidos, o display mostra `tPr`. O `default` do decodificador é
`TAMPERED`, e não `Uni` nem apagado — falhar para o lado seguro vale também
para o painel. Um display que mostrasse "sem chave" quando não sabe seria
pior que um display apagado.

E o que ele **nunca** vai mostrar: KCV, handle, qualquer coisa derivada de
chave. Ótico é o único canal do dispositivo que não aparece numa captura de
UART, então é o canal em que um vazamento passaria despercebido por mais
tempo. O módulo recebe dois bits de estado e um de autorização, e não tem
caminho nenhum até material de chave.

Os LEDs, que sobraram como indicadores grosseiros:

| LED | Significado |
|---|---|
| **D1** | pisca a 1 Hz — o clock de 100 MHz está vivo. É **hardware**, independente da CPU |
| **D2** | aceso — o POST passou e o dispositivo está no laço de comandos |
| **D5** | aceso — `TAMPERED` |

D1 ser hardware é deliberado: se o firmware travar, D1 continua piscando, e
isso distingue "clock morto" de "firmware pendurado". Num dispositivo sem
console, essa distinção é a diferença entre depurar e adivinhar.

O display, ao contrário, é dirigido pelo firmware — ele mostra o que a CPU
diz. As duas coisas se complementam: **D1 prova que o hardware vive, o
display prova que o firmware sabe onde está.** Display congelado com D1
piscando é firmware pendurado; os dois parados é clock morto.

Fora isso, o dispositivo é **mudo até ser perguntado**. Um terminal aberto
na porta serial não mostra absolutamente nada, e esse é o comportamento
correto: um módulo criptográfico que conversa sozinho está contando alguma
coisa a alguém.

### E.6 Trabalhar com chaves

Depois de `OPERATIONAL`, **nenhum comando pede botão** — e isso é o ponto,
não uma economia. A cerimônia acabou; o que vem agora é operação.

```bash
hsmtool.py gen-key --uso D0 --modo B --exp E
#   handle : 1
#   KCV    : 7ED838
```

A chave veio do gerador do dispositivo e **nunca existiu fora da
fronteira**. O que voltou foi um handle e três bytes de KCV. Compare com o
`aes` da Fase 2, onde a chave ia no pedido: é a mesma diferença entre um
cofre e uma gaveta.

```bash
hsmtool.py export-key 1
#   D0144D0AB00E0000B82679114F470F54...
```

São 144 caracteres de texto: dezesseis de cabeçalho legível, o corpo
cifrado, e o MAC. Exporte de novo e o bloco será **diferente** — o
enchimento é aleatório, e dois blocos idênticos denunciariam que a mesma
chave saiu duas vezes.

```bash
hsmtool.py import-key D0144D0AB00E0000...
#   handle : 2
#   KCV    : 7ED838      <- o mesmo
```

Mesmo KCV, outro handle: a chave voltou inteira. E o experimento que vale a
pena fazer é o negativo — troque **um caractere** do bloco, em qualquer
posição, e tente importar. O dispositivo recusa. O caractere na posição 11
é a exportabilidade; reescrevê-lo à mão é literalmente o ataque que o MAC
sobre o cabeçalho existe para impedir.

```bash
hsmtool.py gen-key --exp N
hsmtool.py export-key 3
#   dispositivo recusou: STATUS_NOT_EXPORTABLE
```

Uma chave marcada `'N'` não sai. Não por convenção: existe **um único
caminho** para os bytes deixarem um slot, e é ele que consulta o campo.

```bash
hsmtool.py key-info 1
#   uso D0 · algoritmo A · modo B · exportabilidade E · 32 bytes
#   KCV 7ED838 · usos 0
```

Metadados, nunca chave. Não existe "me devolva o slot inteiro".

E finalmente **usar** a chave — que é o que separa um cofre de um depósito:

```bash
hsmtool.py encrypt 1 <iv 16 bytes> <dados múltiplos de 16>
hsmtool.py decrypt 1 <mesmo iv>    <o criptograma>
```

A chave é referida por **handle**. Compare com o que a Fase 2 fazia: lá a
chave ia dentro do pedido. Aqui vai um número de gaveta, e o material nunca
atravessa a linha.

O experimento que fecha o assunto: exporte uma chave, reimporte, e cifre o
**mesmo bloco com o mesmo IV** usando os dois handles. Os criptogramas têm de
ser idênticos — é a prova de que a chave voltou bit a bit, e é bem mais forte
que comparar os três bytes do KCV.

E o negativo, que ensina mais:

```bash
hsmtool.py gen-key --modo E        # 'E' = só cifrar
hsmtool.py decrypt <handle> ...    # -> BAD_KEY_USE
```

**Confusão de tipo de chave** é a origem de uma família inteira de ataques de
API (seção 15). A defesa é o campo `modo`, e a verificação vive num lugar só
— dentro do key store, não espalhada pelos comandos.

⚠ Uma distinção que confunde: `exportabilidade='N'` **não** impede usar.
Impede **sair**. Uma chave que nunca sai e trabalha o dia inteiro é o caso
mais comum de uma chave bem configurada.

E autenticar, que é o outro serviço:

```bash
hsmtool.py gen-key --uso M0 --modo C --exp E   # 'C' = gerar e verificar MAC
hsmtool.py mac 5 <mensagem hex>
hsmtool.py mac-verify 5 <tag> <mensagem>       # "MAC confere"
```

O veredito vem do **status**, não do payload: o equipamento compara e diz
sim ou não. Devolver a tag calculada para você comparar entregaria 128 bits
em vez de um, e é o tipo de conveniência que abre canal lateral.

E repare no `--modo C`. Os modos se dividem em **dois grupos que não se
cruzam**:

| grupo | valores | o que faz |
|---|---|---|
| cifra | `E` `D` `B` | `encrypt` / `decrypt` |
| MAC | `G` `V` `C` | `mac` / `mac-verify` |

Tente `mac` numa chave `--modo B` e veja `BAD_KEY_USE`. Tente `encrypt`
numa `--modo C` e veja o mesmo.

O `uso` manda junto: `encrypt` exige `D0`, e `mac` exige um uso da família
`M`. Por isso a chave acima é `--uso M0`, e não só `--modo C`. Gere uma
`--uso K0 --modo B` e tente `encrypt`: o modo deixaria, o uso não deixa.

Essa separação não é burocracia de campo — é a defesa contra **confusão de
tipo de chave**, que é a origem de uma família inteira de ataques de API
(seção 15). Uma KEK que decifrasse "dados" entregaria as chaves que ela
protege.

### E.7 Liberar um slot, e montar uma chave a várias mãos

O key store tem dezesseis slots. Para devolver um:

```bash
hsmtool.py delete-key 5
#   apagado. slots livres: 12
```

**Sem dual control**, ao contrário do `zeroize`. A razão é que apagar um
slot é **reversível**: se você guardou o key block daquela chave,
reimportar devolve tudo. Apagar o equipamento inteiro não é reversível, e
por isso pede duas pessoas.

E a operação que fecha o capítulo — montar uma chave que **ninguém conhece
inteira**:

```bash
hsmtool.py comp-load 0 2 --random --uso K0 --modo B --exp E
hsmtool.py comp-load 1 2 --random --uso K0 --modo B --exp E
#   handle : 6  <- chave montada e instalada
```

É a cerimônia da chave mestra aplicada a uma chave de trabalho. Cada
custodiante entra com a sua parte, sob dual control, e o equipamento
combina por XOR **do lado de dentro**. É assim que uma chave combinada
entre duas instituições entra num HSM sem que nenhuma das duas a conheça.

Três detalhes que valem reparar:

- **É o único comando de operação que pede os dois botões.** Os outros são
  trabalho; este é cerimônia.
- **O KCV que volta é o do componente**, não o da chave em construção.
  Serve para o custodiante conferir a parte dele. O do acumulado seria um
  oráculo sobre a chave que ainda está sendo montada.
- **Começar pelo componente 0 reinicia a montagem.** É como se abandona uma
  cerimônia que saiu errada, sem precisar de um comando para isso.

E o comando que desfaz tudo:

```bash
hsmtool.py zeroize      # com os dois botões
```

Apaga os 16 slots e a LMK, **e confere que apagou** antes de dizer que
apagou. Funciona em qualquer estado — inclusive em `TAMPERED`, e ali ele
apaga a chave sem tirar o dispositivo de `TAMPERED`: um HSM que se cura de
tamper não detectou tamper nenhum.

### E.8 Desligar, religar e ler o log *(fase 4)*

```bash
# depois da cerimônia e de gerar chaves: desligue e ligue a placa
python3 host/hsmtool.py version
#   estado   : OPERATIONAL (2)      <- sem cerimônia
python3 host/hsmtool.py lmk-status
#   KCV da LMK  : (o mesmo de antes)
python3 host/hsmtool.py key-info 1  # mesmo handle, mesmo KCV

python3 host/hsmtool.py audit
#      0  BOOT                 Uni  sem registro persistente   OK
#      1  LMK_LOAD_COMPONENT   Uni  arg=0x00                   OK
#    ...
#     14  BOOT                 OPE  restaurado                 OK
```

Cada linha do `audit` é um comando, gravado **antes** de executar. A coluna
de estado é o estado em que o dispositivo estava quando o comando chegou. Um
`GEN_KEY` tentado em `Uni` aparece com o resultado `WRONG_STATE`: tentativas
recusadas também entram.

O `post` continua zerando a memória de trabalho, mas agora restaura tudo da
flash em seguida, e o dispositivo volta ao estado em que estava. Só o
`zeroize` apaga de vez: ele limpa a LMK e as chaves da flash e mantém o log,
que é o registro de quem zeroizou.

### E.9 O que ainda não existe

Honestidade sobre o estado do projeto, para que ninguém procure um comando
que não foi escrito:

- **A LMK sobrevive ao desligamento, mas não está protegida.** Desde a
  Fase 4 ela fica na flash, que o projeto *trata* como memória segura. Quem
  tiver um gravador SPI a lê. É uma decisão didática diante do hardware
  disponível, explicada no §27.
- **Não há anti-rollback.** Regravar a flash com uma imagem antiga faz uma
  chave apagada voltar, e o dispositivo não percebe.
- **Não há exportação em formato legado.** Só em key block X9.143. Por
  isso `exportabilidade='S'` se comporta como `'E'` — e está certo: na
  norma, `'S'` é o valor *mais permissivo*, que libera também formatos
  legados (criptograma simétrico, embrulho RSA). Como eles não existem
  aqui, `'S'` e `'E'` liberam o mesmo caminho.
- **O log de auditoria detecta corrupção, não adulteração.** O CRC de cada
  registro pega um bit trocado por acidente; quem editar a flash de
  propósito recalcula o CRC.
- **`hsmtool keycycle` precisa da LMK em claro**, o que um HSM de verdade
  nunca permitiria. Serve para as duas implementações do formato de key
  block se conferirem; é bancada, não operação.

## F. Leitura

### Normas

- **FIPS 140-3** e ISO/IEC 19790 — requisitos de módulo criptográfico
- **NIST SP 800-90A/B/C** — DRBG, fontes de entropia, construções
- **ANSI X9.143** (sucessor do TR-31) — key blocks
- **RFC 8017** (PKCS #1 v2.2) — RSA, e o enchimento de assinatura v1.5
- **PCI PIN Security Requirements** e **PCI PTS HSM** — de onde vêm dual
  control e split knowledge como exigência

### Ataques

- Bond, M. — *Attacks on Cryptoprocessor Transaction Sets* (2001)
- Bond, M. e Zieliński, P. — *Decimalisation Table Attacks for PIN Cracking*
  (2003)
- Clulow, J. — *On the Security of Real-World PIN Processing* (2003)
- Boneh, DeMillo e Lipton — *On the Importance of Checking Cryptographic
  Protocols for Faults* (1997) — o ataque Bellcore
- Kocher, P. — *Timing Attacks* (1996) e, com Jaffe e Jun, *Differential
  Power Analysis* (1999)
- Piret e Quisquater — análise diferencial de falhas em AES (2003)
- Schindler, W. — *A Timing Attack against RSA with the Chinese Remainder
  Theorem* (2000), e Walter, C. e Thompson, S. — *Distinguishing Exponent
  Digits by Observing Modular Subtractions* (2001) — a subtração final do
  produto de Montgomery como canal lateral
- Bleichenbacher, D. — falsificação de assinaturas RSA com `e = 3` contra
  verificadores que interpretam o enchimento (2006)

### Aritmética

- Montgomery, P. — *Modular Multiplication Without Trial Division* (1985)
- Koç, Ç., Acar, T. e Kaliski, B. — *Analyzing and Comparing Montgomery
  Multiplication Algorithms* (1996) — de onde vem o FIOS

### Livros

- Anderson, R. — *Security Engineering*. Os capítulos sobre APIs de segurança
  e sobre segurança de hardware são a melhor introdução ao assunto da Parte
  III.
- Maes, R. — *Physically Unclonable Functions*. Para o experimento da Fase 6.

### Ferramentas e cores usados

- **NEORV32** — processador RISC-V em VHDL, `github.com/stnolting/neorv32`
- **secworks/aes** e **secworks/sha256** — cores criptográficos para a Fase 2
- **openFPGALoader** — gravação por JTAG

---

::: {.fecho}

*Este documento acompanha o repositório `hsm-a7`. A Parte V reflete o estado
ao fim da Fase 1, validada em hardware. As Partes I a IV são independentes do
projeto e valem por si.*

:::
