flavioalsoares/hsm-a7/fw/src/main.c

/* fw/src/main.c -- firmware do HSM educacional
 *
 * FRONTEIRA: este arquivo nao toca material de chave. Ele so inicializa o
 * hardware e roda o laco de comandos.
 *
 * Fase 1: infraestrutura. Sem cripto, sem key store, sem POST -- esses
 * chegam na fase 2 (PLANO.md secao 3), e a partir dali o dispositivo nao
 * pode aceitar comando algum antes dos KAT passarem.
 */
#include <neorv32.h>

#include "ambiente.h"
#include "audit_log.h"
#include "cmd.h"
#include "flash.h"
#include "persist.h"
#include "dualctl.h"
#include "hsm_cfs.h"
#include "kat.h"
#include "keystore.h"
#include "state.h"
#ifdef HSM_TESTE_MR
#include "kat_mr.h"
#include "rsa.h"
#endif

/* PLANO.md secao 2. Nao confundir com os 19200 do bootloader do NEORV32. */
#define BAUD_RATE  115200u

/* GPIO -- ver rtl/top/hsm_top.v
 *   saida 0..3 -> LEDs D2..D5 (o toplevel inverte para a placa)
 *   entrada 0  -> SW2, entrada 1 -> SW5 (dual control, fase 3) */
#define LED_ALIVE      0u
#define LED_CMD        1u
#define LED_STATE      2u
#define LED_TAMPER     3u

/* Painel de estado -- rtl/top/seg_display.v le estes bits.
 *
 *   4,5  estado da maquina (hsm_state_t, 2 bits)
 *   6    dual control satisfeito AGORA -> ponto decimal
 *
 * O display NAO le a maquina de estados; ele recebe dois bits e mais nada.
 * Um caminho de hardware ate a estrutura de estado seria caminho de
 * hardware ate o que esta ao lado dela na DMEM. */
#define GPIO_ESTADO_0  4u
#define GPIO_ESTADO_1  5u
#define GPIO_DUAL_OK   6u

/* Atualiza o painel, e SO se algo mudou.
 *
 * Escrever os tres bits a cada volta do laco custaria tres stores por
 * iteracao num laco que gira dezenas de milhoes de vezes por segundo. Nao
 * quebraria nada -- nao ha contencao de barramento aqui -- mas gastar ciclo
 * de CPU num display que muda tres vezes por cerimonia e desperdicio com
 * cara de zelo.
 *
 * FRONTEIRA: dentro, e de propósito muito estreita. Esta funcao ve o
 * ESTADO e a AUTORIZACAO, nunca chave. O que sai daqui vai para um display
 * -- e display e o unico canal do dispositivo que nao aparece numa captura
 * de UART. Se um dia ele mostrar KCV, vira canal lateral otico. */
static void painel_atualiza(void)
{
    static uint8_t ultimo = 0xFFu;    /* valor impossivel: forca a 1a escrita */

    uint8_t st  = (uint8_t)state_get();
    uint8_t val = (uint8_t)((st & 0x3u) | (dualctl_pronto() ? 0x4u : 0x0u));

    if (val == ultimo) {
        return;
    }
    ultimo = val;

    neorv32_gpio_pin_set(GPIO_ESTADO_0, (val >> 0) & 1u);
    neorv32_gpio_pin_set(GPIO_ESTADO_1, (val >> 1) & 1u);
    neorv32_gpio_pin_set(GPIO_DUAL_OK,  (val >> 2) & 1u);
}

/* Marco de boot -- so no build de diagnostico (make HSM_DIAG=1 image).
 *
 * Acende um LED E manda uma linha pela UART. Os dois, porque cada um
 * reprova uma coisa diferente: LED aceso com UART muda isola o caminho
 * serial; UART falando com LED apagado isola o GPIO. Um so nao separa.
 *
 * FRONTEIRA: nao toca material de chave. Nao pode passar a tocar -- se um
 * dia este marco imprimir estado interno, vira canal lateral ligado por
 * flag de compilacao, que e a pior forma de vazamento porque nao aparece
 * em nenhuma revisao de codigo de runtime. */
#ifdef HSM_DIAG
#  define MARCO(led, texto)                        \
      do {                                         \
          neorv32_gpio_pin_set((led), 1);          \
          neorv32_uart0_puts("[diag] " texto "\r\n"); \
      } while (0)
#else
#  define MARCO(led, texto) do { (void)(led); } while (0)
#endif

int main(void)
{
    neorv32_uart0_setup(BAUD_RATE, 0);

    /* Primeiro sinal de vida possivel: se este nao sair, o problema esta
     * antes de main() -- crt0, IMEM ou a propria CPU. */
    MARCO(LED_CMD, "main");

    state_init();
    cmd_init();

    /* Dual control comeca DESARMADO -- ver dualctl.h. Um dispositivo que
     * ligou com um botao colado nao autoriza nada ate alguem solta-lo. */
    dualctl_init();

    /* Key store zerado ANTES do POST. O POST o exercita e o deixa limpo de
     * novo; inicializar aqui garante estado definido mesmo se o POST
     * reprovar antes de chegar nele. */
    keystore_init();

    MARCO(LED_STATE, "state+cmd");

    /* O CLINT e a base do timeout de resincronizacao do parser. Sem ele o
     * dispositivo aceitaria um frame truncado e ficaria mudo -- negacao de
     * servico com um unico byte. Melhor nao subir do que subir quebrado. */
    if (neorv32_clint_available() == 0) {
#ifdef HSM_DIAG
        neorv32_uart0_puts("[diag] SEM CLINT -- travando\r\n");
#endif
        neorv32_gpio_pin_set(LED_TAMPER, 1);
        while (1) { /* trava de proposito */ }
    }

    MARCO(LED_CMD, "clint ok");

    /* O coprocessador criptografico tem de estar presente e se identificar.
     *
     * Nao e o POST -- esse chega com os KAT no boot, ainda nesta fase, e
     * verifica que o hardware calcula CERTO. Este teste e mais fraco de
     * proposito: verifica que o hardware EXISTE. Sem ele, um bitstream
     * gerado com IO_CFS_EN desligado subiria normalmente e so falharia na
     * hora de usar cripto, que e tarde demais para descobrir.
     *
     * Recusar subir e a resposta certa: um modulo criptografico que nao
     * consegue fazer criptografia nao deve aceitar comando nenhum. */
    if (hsm_cfs_present() == 0) {
#ifdef HSM_DIAG
        neorv32_uart0_puts("[diag] SEM CFS -- travando\r\n");
#endif
        neorv32_gpio_pin_set(LED_TAMPER, 1);
        while (1) { /* trava de proposito */ }
    }

    MARCO(LED_STATE, "cfs ok");

    /* ------------------------------------------------------------------
     * POST -- power-on self-test
     *
     * Roda ANTES de aceitar qualquer comando. Nao e capricho: e o
     * requisito de self-test do FIPS 140-3, e a logica dele e simples --
     * um modulo criptografico que nao consegue provar que calcula certo
     * AGORA nao deve aceitar comando nenhum. Cripto errada e pior que
     * cripto ausente, porque parece que funcionou.
     *
     * Cobre AES, SHA, HMAC e CTR_DRBG contra vetores oficiais, e os
     * testes de partida da fonte de entropia. Ver fw/src/kat.c.
     *
     * Falhou: o dispositivo vai para TAMPERED e FICA. Nao trava e nao
     * reinicia -- continua atendendo, porque o unico comando que responde
     * em TAMPERED e o SELFTEST, e sem ele o operador teria apenas um LED
     * vermelho e nenhuma informacao sobre o que reprovou.
     * ------------------------------------------------------------------ */
    /* Painel antes do POST: o dispositivo mostra Uni desde o inicio, e nao
     * fica com o display apagado durante os ~6 ms de autoteste. Display
     * apagado e ambiguo -- e o mesmo sintoma de CPU parada. */
    painel_atualiza();

    /* Fase 4: a flash e o log antes do POST, para que o registro de boot
     * diga tambem quando o POST reprovou. Sem flash o dispositivo sobe,
     * mas todo comando que entra no log e recusado (STATUS_LOG_FAIL) --
     * e isso inclui a cerimonia. */
    (void)flash_init();
    log_init();

    unsigned post   = kat_post();
    uint8_t  achou  = 0u;

    if (post != KAT_OK) {
#ifdef HSM_DIAG
        neorv32_uart0_puts("[diag] POST REPROVOU\r\n");
#endif
        neorv32_gpio_pin_set(LED_TAMPER, 1);
        state_set(HSM_TAMPERED);
    } else {
        MARCO(LED_CMD, "post ok");
        neorv32_gpio_pin_set(LED_ALIVE, 1);

        /* Fase 6: ambiente ANTES de restaurar. Fora da faixa, ou com o
         * alarme retido de antes de um reset, a chave nao volta para a
         * BRAM: a copia da flash e apagada. */
        if (ambiente_boot() != 0) {
            neorv32_gpio_pin_set(LED_TAMPER, 1);
        } else {
            /* Fase 4: LMK, estado e slots voltam da flash. E o papel da
             * memoria com bateria de um HSM comercial: desligar nao apaga.
             * Sem registro valido, sobe em UNINITIALIZED como sempre. */
            state_set(persist_restaura(&achou));
        }
    }

    /* Registro de boot: comando 0x00. O argumento resume o que aconteceu
     *   bits 0..1  registro persistente: 0 nenhum, 1 restaurado,
     *              2 havia e nenhum era valido
     *   bit 6      flash ausente
     *   bit 7      POST reprovou
     * Desligar e religar passa a aparecer na trilha -- que e onde se
     * esconderia quem quisesse apagar a memoria de trabalho. */
    {
        uint32_t seq;
        uint8_t  arg = (uint8_t)(achou & 0x3u);
        if (!flash_presente()) { arg |= 0x40u; }
        if (post != KAT_OK)    { arg |= 0x80u; }
        if (log_registra(LOG_CMD_BOOT, (uint8_t)state_get(), arg, &seq) == 0) {
            (void)log_resultado(seq, (post == KAT_OK) ? 0x00u : 0x30u);
        }
    }

#ifdef HSM_DIAG
    neorv32_uart0_puts("[diag] laco de comandos\r\n");
#endif

#ifdef HSM_TESTE_MR
    /* Firmware de TESTE (make HSM_TESTE_MR=1): o Miller-Rabin da geracao de
     * chave contra o KAT de primalidade do CAVP. Ver fw/Makefile. */
    {
        static const uint8_t *const casos[KAT_MR_N] = { kat_mr0, kat_mr1, kat_mr2 };
        static const int esperado[KAT_MR_N] = {
            KAT_MR0_PRIMO, KAT_MR1_PRIMO, KAT_MR2_PRIMO };
        int i, r, falhas = 0;
        for (i = 0; i < (int)KAT_MR_N; i++) {
            r = rsa_primo_provavel(casos[i]);
            neorv32_uart0_puts((r == esperado[i]) ? "[mr] ok\r\n" : "[mr] ERRADO\r\n");
            if (r != esperado[i]) {
                falhas++;
            }
        }
        neorv32_uart0_puts(falhas ? "[mr] FAIL\r\n" : "[mr] PASS\r\n");
    }
#endif

    /* Laco principal. Nao ha interrupcao: o caminho de comando e sincrono e
     * de passo unico, que e mais facil de auditar do que um handler de IRQ
     * mexendo nos mesmos buffers. */
    while (1) {
        cmd_poll();

        /* Fase 6. Entre comandos: nao ha interrupcao, entao um comando em
         * curso termina antes. O mais longo apaga um setor da flash. */
        if ((ambiente_poll() != 0) || erro_grave_ativo()) {
            neorv32_gpio_pin_set(LED_TAMPER, 1);
        }

        /* Rearme do dual control: e aqui que o firmware VE os botoes serem
         * soltos. Fica no laco, e nao dentro do handler, porque a condicao
         * que interessa e um evento que acontece ENTRE comandos -- um
         * handler so ve o instante em que foi chamado, e nesse instante os
         * botoes ja estao pressionados de novo.
         *
         * Consequencia pratica na cerimonia: nao adianta segurar os dois
         * botoes durante os tres componentes. Cada um exige soltar e
         * apertar, que e exatamente o gesto que se quer contar. */
        dualctl_poll();

        /* Depois do dualctl_poll(), para que o ponto decimal reflita o
         * mesmo instante que a proxima autorizacao veria. */
        painel_atualiza();
    }

    return 0;
}
