flavioalsoares/hsm-a7/doc/qmtech_official_xdc/LED.xdc

set_property PACKAGE_PIN T15 [get_ports uart_rx]
set_property IOSTANDARD LVCMOS33 [get_ports uart_rx]
set_property PACKAGE_PIN T14 [get_ports uart_tx]
set_property IOSTANDARD LVCMOS33 [get_ports uart_tx]

set_property PACKAGE_PIN N11 [get_ports sys_clk]
set_property IOSTANDARD LVCMOS33 [get_ports sys_clk]
set_property PACKAGE_PIN E6 [get_ports sys_rst_n]
set_property IOSTANDARD LVCMOS33 [get_ports sys_rst_n]

set_property BITSTREAM.CONFIG.SPI_BUSWIDTH 4 [current_design]
