flavioalsoares/hsm-a7/host/hsmhost.py

#!/usr/bin/env python3
"""hsmhost.py -- cliente da porta HOST: command set ASCII (fase 5).

O hsmtool.py fala o protocolo binario, que desde a fase 5 e o CONSOLE:
cerimonia, estado, diagnostico, log. Este aqui fala a porta HOST, que e a
que um sistema de pagamento usaria: mensagens ASCII sem sessao, em que a
chave de trabalho viaja DENTRO do comando como key block sob a LMK.
Formato, comandos e erros: doc/fase5-notas.md.

O host guarda os key blocks. Este script nao tem banco de dados: os blocos
entram e saem pela linha de comando, e quem quiser guardar redireciona.

Uso:
    hsmhost.py diag                         # D0: estado, KCV da LMK, versao
    hsmhost.py gen [--uso D0 --modo B --exp E]
    hsmhost.py check BLOCO                  # K2: cabecalho e KCV
    hsmhost.py export KEK BLOCO             # K4: sob a LMK -> sob a KEK
    hsmhost.py import KEK BLOCO             # K6: sob a KEK -> sob a LMK
    hsmhost.py encrypt BLOCO IV DADOS       # C0, hex
    hsmhost.py decrypt BLOCO IV DADOS       # C2, hex
    hsmhost.py mac BLOCO DADOS              # M0
    hsmhost.py mac-verify BLOCO MAC DADOS   # M2: o veredito e o codigo
    hsmhost.py rsa-verify N E DIGEST S      # R4: RSA-2048, PKCS#1 v1.5, SHA-256
    hsmhost.py rsa-cavp [--lmk HEX]         # R4 com os vetores do CAVP; com a
                                            # LMK, tambem R2 com a chave do CAVP
    hsmhost.py rsa-sign BLOCO DIGEST        # R2: assina com a chave do bloco
    hsmhost.py rsa-gen [--exp E]            # R0: gera par RSA-2048
    hsmhost.py rsa-confere [-n N]           # R0 + R2 + R4, conferidos aqui
    hsmhost.py ecdsa-verify QX QY DIGEST R S  # E4: ECDSA P-256
    hsmhost.py ecdsa-cavp [--lmk HEX]       # E4 com os vetores do CAVP; com a
                                            # LMK, tambem E2 com a chave do CAVP
    hsmhost.py ecdsa-sign BLOCO DIGEST      # E2: assina com a chave do bloco
    hsmhost.py ecdsa-gen [--exp E]          # E0: gera par P-256
    hsmhost.py ecdsa-confere [-n N]         # E0 + E2 + E4, conferidos aqui
    hsmhost.py confere --lmk HEX [-n N]     # o Python conferindo o C
    hsmhost.py selftest                     # codec, sem placa

Transporte: pela ponte (--tcp HOST:PORTA, padrao 127.0.0.1:1500, ver
hsm_ponte.py) ou direto na serial (--serial [--porta PORTA]).
"""

import argparse
import hashlib
import os
import re
import socket
import struct
import sys

CAB_PADRAO = b"0000"
ASCII_DADOS_MAX = 160

ERROS = {
    0: "sem erro",
    1: "verificacao falhou",
    10: "key block invalido",
    11: "o modo do bloco nao permite",
    12: "a chave nao e exportavel",
    13: "o bloco de protecao nao e uma KEK (K0)",
    15: "dados invalidos",
    16: "parametro invalido",
    20: "estado nao permite",
    21: "comando desconhecido",
    22: "mensagem malformada",
    27: "falha no log de auditoria",
    90: "erro interno",
    91: "erro grave: dupla execucao discordou",
}


class HostErro(Exception):
    def __init__(self, codigo, comando):
        self.codigo = codigo
        super().__init__("%s: erro %02d (%s)"
                         % (comando, codigo, ERROS.get(codigo, "?")))


# --------------------------------------------------------------------
# Codec -- sem transporte, testavel sozinho
# --------------------------------------------------------------------
def monta(cabecalho: bytes, comando: str, campos: bytes = b"") -> bytes:
    if len(cabecalho) != 4:
        raise ValueError("cabecalho tem 4 caracteres")
    if not (0x30 <= cabecalho[0] <= 0x7E):
        # O primeiro byte separa os protocolos na UART: fora desta faixa o
        # dispositivo leria um frame binario. Ver doc/fase5-notas.md.
        raise ValueError("cabecalho comeca com caractere de '0' a '~'")
    return cabecalho + comando.encode("ascii") + campos


def resposta_esperada(comando: str) -> str:
    return comando[0] + chr(ord(comando[1]) + 1)


def analisa(resp: bytes, cabecalho: bytes, comando: str):
    """Devolve (erro, campos). Confere cabecalho e codigo de resposta."""
    if len(resp) < 8:
        raise ValueError("resposta curta: %r" % resp)
    if resp[:4] != cabecalho:
        raise ValueError("cabecalho trocado: %r" % resp[:4])
    if resp[4:6].decode("ascii", "replace") != resposta_esperada(comando):
        raise ValueError("resposta %r para o comando %s"
                         % (resp[4:6], comando))
    return int(resp[6:8]), resp[8:]


def dados(b: bytes) -> bytes:
    return b"%04d" % len(b) + b.hex().upper().encode()


def le_dados(campos: bytes):
    n = int(campos[:4])
    return bytes.fromhex(campos[4:4 + 2 * n].decode()), campos[4 + 2 * n:]


# --------------------------------------------------------------------
# Transporte: LEN(2) + mensagem, igual por TCP e pela UART
# --------------------------------------------------------------------
class Tcp:
    def __init__(self, destino, timeout=5.0):
        host, porta = destino.rsplit(":", 1)
        self.s = socket.create_connection((host, int(porta)), timeout=timeout)

    def _le(self, n):
        buf = b""
        while len(buf) < n:
            c = self.s.recv(n - len(buf))
            if not c:
                raise ConnectionError("a ponte fechou a conexao")
            buf += c
        return buf

    def espera(self, segundos):
        self.s.settimeout(segundos)

    def troca(self, msg: bytes) -> bytes:
        self.s.sendall(struct.pack(">H", len(msg)) + msg)
        n = struct.unpack(">H", self._le(2))[0]
        return self._le(n)

    def close(self):
        self.s.close()


class Serial:
    def __init__(self, porta=None, timeout=2.0):
        import serial
        from hsmtool import default_port
        porta = porta or default_port()
        if porta is None:
            raise RuntimeError("nenhuma porta serial encontrada")
        self.ser = serial.Serial(porta, 115200, timeout=timeout)
        self.ser.reset_input_buffer()

    def espera(self, segundos):
        self.ser.timeout = segundos

    def _le(self, n):
        buf = self.ser.read(n)
        if len(buf) != n:
            raise TimeoutError("resposta incompleta (%d de %d bytes)"
                               % (len(buf), n))
        return buf

    def troca(self, msg: bytes) -> bytes:
        self.ser.write(struct.pack(">H", len(msg)) + msg)
        n = struct.unpack(">H", self._le(2))[0]
        return self._le(n)

    def close(self):
        self.ser.close()


class Host:
    def __init__(self, transporte, cabecalho=CAB_PADRAO):
        self.t = transporte
        self.cab = cabecalho

    def pede(self, comando, campos=b"", aceita=(0,)):
        resp = self.t.troca(monta(self.cab, comando, campos))
        erro, resto = analisa(resp, self.cab, comando)
        if erro not in aceita:
            raise HostErro(erro, comando)
        return erro, resto

    # -- os comandos --------------------------------------------------
    def diag(self):
        _, c = self.pede("D0")
        return {"estado": int(c[0:1]), "kcv_lmk": c[1:7].decode(),
                "versao": "%d.%d.%d" % (int(c[7:9]), int(c[9:11]),
                                        int(c[11:13]))}

    def gen(self, uso="D0", modo="B", exp="E"):
        _, c = self.pede("K0", (uso + modo + exp).encode())
        n = int(c[1:5])
        return c[:n].decode(), c[n:n + 6].decode()

    def check(self, bloco):
        _, c = self.pede("K2", bloco.encode())
        return {"uso": c[0:2].decode(), "algoritmo": c[2:3].decode(),
                "modo": c[3:4].decode(), "exportabilidade": c[4:5].decode(),
                "kcv": c[5:11].decode()}

    def _rebloco(self, comando, kek, bloco):
        _, c = self.pede(comando, kek.encode() + bloco.encode())
        n = int(c[1:5])
        return c[:n].decode(), c[n:n + 6].decode()

    def exporta(self, kek, bloco):
        """K4: bloco sob a LMK -> o mesmo sob a KEK, para outra instituicao."""
        return self._rebloco("K4", kek, bloco)

    def importa(self, kek, bloco):
        """K6: bloco recebido sob a KEK -> sob a LMK, para guardar aqui."""
        return self._rebloco("K6", kek, bloco)

    def cripto(self, bloco, iv, d, cifrar):
        _, c = self.pede("C0" if cifrar else "C2",
                         bloco.encode() + iv.hex().upper().encode() + dados(d))
        return le_dados(c)[0]

    def mac(self, bloco, d):
        _, c = self.pede("M0", bloco.encode() + dados(d))
        return bytes.fromhex(c[:32].decode())

    def mac_verifica(self, bloco, tag, d):
        erro, _ = self.pede("M2", bloco.encode() + tag.hex().upper().encode()
                            + dados(d), aceita=(0, 1))
        return erro == 0

    def rsa_verifica(self, n, e, digest, s):
        """R4: so dados publicos entram, e sai um bit (o codigo de erro)."""
        campos = (n.to_bytes(256, "big") + e.to_bytes(4, "big") + digest
                  + s.to_bytes(256, "big"))
        erro, _ = self.pede("R4", campos.hex().upper().encode(), aceita=(0, 1))
        return erro == 0

    def rsa_gera(self, exp="E"):
        """R0: (key block da chave privada, n, e). Leva segundos: o
        dispositivo procura dois primos de 1024 bits."""
        self.t.espera(120.0)
        try:
            _, c = self.pede("R0", exp.encode())
        finally:
            self.t.espera(5.0)
        bloco = c[:-520].decode()
        return bloco, int(c[-520:-8].decode(), 16), int(c[-8:].decode(), 16)

    def rsa_assina(self, bloco, digest):
        """R2: a chave privada vai no key block sob a LMK; sai S."""
        _, c = self.pede("R2", bloco.encode() + digest.hex().upper().encode())
        return int(c[:512].decode(), 16)


    def ecdsa_verifica(self, qx, qy, digest, r, s):
        """E4: so dados publicos entram, e sai um bit (o codigo de erro).
        Chave publica fora da curva e erro 16, e sobe como HostErro."""
        campos = b"".join(v.to_bytes(32, "big") for v in (qx, qy)) + digest \
            + r.to_bytes(32, "big") + s.to_bytes(32, "big")
        self.t.espera(10.0)
        try:
            erro, _ = self.pede("E4", campos.hex().upper().encode(), aceita=(0, 1))
        finally:
            self.t.espera(5.0)
        return erro == 0

    def ecdsa_gera(self, exp="E"):
        """E0: (key block da chave privada, Qx, Qy)."""
        self.t.espera(10.0)
        try:
            _, c = self.pede("E0", exp.encode())
        finally:
            self.t.espera(5.0)
        bloco = c[:-128].decode()
        return bloco, int(c[-128:-64].decode(), 16), int(c[-64:].decode(), 16)

    def ecdsa_assina(self, bloco, digest):
        """E2: a chave privada vai no key block sob a LMK; saem r e s."""
        self.t.espera(10.0)
        try:
            _, c = self.pede("E2", bloco.encode() + digest.hex().upper().encode())
        finally:
            self.t.espera(5.0)
        return int(c[:64].decode(), 16), int(c[64:128].decode(), 16)


# --------------------------------------------------------------------
# ECDSA P-256: a conferencia em Python, com inteiros. E a segunda
# implementacao -- nao usa nada do firmware.
EC_P = 2**256 - 2**224 + 2**192 + 2**96 - 1
EC_N = 0xFFFFFFFF00000000FFFFFFFFFFFFFFFFBCE6FAADA7179E84F3B9CAC2FC632551
EC_B = 0x5AC635D8AA3A93E7B3EBBD55769886BC651D06B0CC53B0F63BCE3C3E27D2604B
EC_G = (0x6B17D1F2E12C4247F8BCE6E563A440F277037D812DEB33A0F4A13945D898C296,
        0x4FE342E2FE1A7F9B8EE7EB4A7C0F9E162BCE33576B315ECECBB6406837BF51F5)


def ec_soma(p1, p2):
    """Soma de pontos afins; None e o ponto no infinito."""
    if p1 is None:
        return p2
    if p2 is None:
        return p1
    (x1, y1), (x2, y2) = p1, p2
    if x1 == x2:
        if (y1 + y2) % EC_P == 0:
            return None
        lam = (3 * x1 * x1 - 3) * pow(2 * y1, -1, EC_P) % EC_P
    else:
        lam = (y2 - y1) * pow(x2 - x1, -1, EC_P) % EC_P
    x3 = (lam * lam - x1 - x2) % EC_P
    return x3, (lam * (x1 - x3) - y1) % EC_P


def ec_mult(k, p):
    r = None
    while k:
        if k & 1:
            r = ec_soma(r, p)
        p = ec_soma(p, p)
        k >>= 1
    return r


def ecdsa_confere_py(q, digest, r, s):
    """Verificacao ECDSA em Python (FIPS 186-5, 6.4.2)."""
    x, y = q
    if not (0 <= x < EC_P and 0 <= y < EC_P) or \
            (y * y - (x**3 - 3 * x + EC_B)) % EC_P != 0:
        return False
    if not (0 < r < EC_N and 0 < s < EC_N):
        return False
    e = int.from_bytes(digest, "big")
    w = pow(s, -1, EC_N)
    ponto = ec_soma(ec_mult(e * w % EC_N, EC_G), ec_mult(r * w % EC_N, q))
    return ponto is not None and ponto[0] % EC_N == r


def ecdsa_vetores(nome):
    """Os casos da secao [P-256,SHA-256] de um arquivo do CAVP."""
    raiz = os.path.dirname(os.path.dirname(os.path.abspath(__file__)))
    casos, atual = [], {}
    with open(os.path.join(raiz, "vectors", "ecdsa", nome)) as f:
        for linha in f:
            m = re.match(r"^(\w+) = (.*)$", linha.strip())
            if m:
                atual[m[1]] = m[2].strip()
            elif atual:
                casos.append(atual)
                atual = {}
    if atual:
        casos.append(atual)
    return [c for c in casos if "Qx" in c]


def ecdsa_confere(h, voltas):
    """Gera pares no dispositivo e confere cada um daqui, so com Q: a
    assinatura do E2 tem de verificar em Python, e o E4 tem de aceita-la e
    recusar a adulterada."""
    import time
    for v in range(voltas):
        t0 = time.monotonic()
        bloco, qx, qy = h.ecdsa_gera()
        dt = time.monotonic() - t0
        anteriores = set()
        for i in range(3):
            digest = hashlib.sha256(b"ecdsa-confere %d %d" % (v, i)).digest()
            r, s = h.ecdsa_assina(bloco, digest)
            if not ecdsa_confere_py((qx, qy), digest, r, s):
                print("par %d: assinatura %d NAO verifica" % (v, i))
                return 1
            if r in anteriores:
                print("par %d: r repetido -- o k se repetiu" % v)
                return 1
            anteriores.add(r)
            if not h.ecdsa_verifica(qx, qy, digest, r, s):
                print("par %d: o E4 recusou a propria assinatura" % v)
                return 1
            if h.ecdsa_verifica(qx, qy, digest, r, s ^ 1):
                print("par %d: o E4 aceitou assinatura adulterada" % v)
                return 1
        print("par %d: gerado em %.2f s, 3 assinaturas conferidas" % (v, dt))
    return 0


def ecdsa_cavp(h, lmk=None):
    """SigVer: cada vetor tem de dar o veredito do CAVP. PKV: chave publica
    invalida tem de ser recusada com 16. Com a LMK, tambem assina com as
    chaves do SigGen do CAVP e confere aqui."""
    if lmk is not None:
        import tr31
        for i, c in enumerate(ecdsa_vetores("SigGen_P256.txt")[:3]):
            chave = b"".join(bytes.fromhex(c[k].zfill(64)) for k in ("d", "Qx", "Qy"))
            bloco = tr31.embrulha(lmk, chave, uso="S0", algoritmo="E", modo="S",
                                  exportabilidade="E")
            digest = hashlib.sha256(bytes.fromhex(c["Msg"])).digest()
            r, s = h.ecdsa_assina(bloco, digest)
            if not ecdsa_confere_py((int(c["Qx"], 16), int(c["Qy"], 16)), digest, r, s):
                print("E2 %d: assinatura ERRADA" % i)
                return 1
            print("E2 %d: assinatura com a chave do CAVP confere" % i)
    vs = ecdsa_vetores("SigVer_P256.rsp")
    for i, c in enumerate(vs):
        digest = hashlib.sha256(bytes.fromhex(c["Msg"])).digest()
        espera = c["Result"].startswith("P")
        try:
            ok = h.ecdsa_verifica(int(c["Qx"], 16), int(c["Qy"], 16), digest,
                                  int(c["R"], 16), int(c["S"], 16))
        except HostErro as e:
            ok = None if e.codigo == 16 else "erro %d" % e.codigo
        # "Q changed" pode tirar o ponto da curva: ai a recusa e o 16.
        if ok is not espera and not (ok is None and not espera):
            print("vetor %d: esperado %s, veio %r" % (i, c["Result"], ok))
            return 1
        print("vetor %d: %s" % (i, c["Result"]))
    pk = ecdsa_vetores("PKV_P256.rsp")
    for i, c in enumerate(pk):
        if len(c["Qx"]) > 64 or len(c["Qy"]) > 64:
            continue                    # nem cabe no campo do comando
        espera = c["Result"].startswith("P")
        try:
            h.ecdsa_verifica(int(c["Qx"], 16), int(c["Qy"], 16), b"\0" * 31 + b"\1", 1, 1)
            aceita = True
        except HostErro as e:
            if e.codigo != 16:
                raise
            aceita = False
        if aceita != espera:
            print("PKV %d: esperado %s" % (i, c["Result"]))
            return 1
    print("%d vetores de SigVer e %d de PKV do CAVP conferidos" % (len(vs), len(pk)))
    return 0


def chave_cavp():
    """A primeira chave de 2048 bits do KeyGen do CAVP, no layout do key block
    (tr31.RSA_CHAVE): e p q dp dq qinv. Devolve (chave, n, e, d)."""
    raiz = os.path.dirname(os.path.dirname(os.path.abspath(__file__)))
    caminho = os.path.join(raiz, "vectors", "rsa", "KeyGen_RandomProbablyPrime3_3.rsp")
    with open(caminho) as f:
        texto = f.read().split("[mod = 2048]")[1].split("[mod =")[0]
    m = re.search(r"e = (\w+)\s+p = (\w+)\s+q = (\w+)\s+n = (\w+)\s+d = (\w+)", texto)
    e, p, q, n, d = (int(x, 16) for x in m.groups())
    chave = (e.to_bytes(4, "big") + p.to_bytes(128, "big") + q.to_bytes(128, "big")
             + (d % (p - 1)).to_bytes(128, "big") + (d % (q - 1)).to_bytes(128, "big")
             + pow(q, -1, p).to_bytes(128, "big"))
    return chave, n, e, d


def em_pkcs1(digest):
    """O EM de PKCS#1 v1.5 com SHA-256, como inteiro."""
    t = bytes.fromhex("3031300d060960864801650304020105000420") + digest
    return int.from_bytes(b"\0\1" + b"\xff" * (253 - len(t)) + b"\0" + t, "big")


def vetores_cavp():
    """Os vetores SHA-256 de 2048 bits do SigGen15 do CAVP: (n, e, digest, S)."""
    raiz = os.path.dirname(os.path.dirname(os.path.abspath(__file__)))
    with open(os.path.join(raiz, "vectors", "rsa", "SigGen15_186-3.rsp")) as f:
        texto = f.read().split("[mod = 3072]")[0]
    n = int(re.search(r"^n = (\w+)", texto, re.M)[1], 16)
    e = int(re.search(r"^e = (\w+)", texto, re.M)[1], 16)
    bloco = texto.split("SHAAlg = SHA256")[1:]
    vs = []
    for b in bloco:
        msg = bytes.fromhex(re.search(r"^Msg = (\w+)", b, re.M)[1])
        sig = int(re.search(r"^S = (\w+)", b, re.M)[1], 16)
        vs.append((n, e, hashlib.sha256(msg).digest(), sig))
    return vs


def rsa_confere(h, voltas):
    """Gera pares no dispositivo e confere cada um daqui, so com n e e: a
    assinatura do R2 tem de verificar em Python, e o R4 tem de aceita-la.
    Se p ou q nao fossem primos, a assinatura por CRT nao verificaria."""
    import time
    for v in range(voltas):
        t0 = time.monotonic()
        bloco, n, e = h.rsa_gera()
        dt = time.monotonic() - t0
        if e != 65537 or n.bit_length() != 2048 or n % 2 == 0:
            print("par %d: n ou e fora do esperado" % v)
            return 1
        for i in range(3):
            digest = hashlib.sha256(b"rsa-confere %d %d" % (v, i)).digest()
            s = h.rsa_assina(bloco, digest)
            if pow(s, e, n) != em_pkcs1(digest):
                print("par %d: assinatura %d NAO verifica" % (v, i))
                return 1
            if not h.rsa_verifica(n, e, digest, s):
                print("par %d: o R4 recusou a propria assinatura" % v)
                return 1
        print("par %d: gerado em %.1f s, 3 assinaturas conferidas" % (v, dt))
    return 0


def rsa_cavp(h, lmk=None):
    """Cada vetor tem de conferir, e com um bit trocado em S, nao. Com a LMK,
    tambem assina com a chave do CAVP e confere a assinatura aqui."""
    if lmk is not None:
        import tr31
        chave, n, e, d = chave_cavp()
        bloco = tr31.embrulha(lmk, chave, uso="S0", algoritmo="R", modo="S",
                              exportabilidade="E")
        for i in range(3):
            digest = hashlib.sha256(b"hsm-a7 R2 %d" % i).digest()
            s = h.rsa_assina(bloco, digest)
            if s != pow(em_pkcs1(digest), d, n) or pow(s, e, n) != em_pkcs1(digest):
                print("R2 %d: assinatura ERRADA" % i)
                return 1
            print("R2 %d: assinatura com a chave do CAVP confere" % i)
    vs = vetores_cavp()
    for i, (n, e, d, sig) in enumerate(vs):
        if not h.rsa_verifica(n, e, d, sig):
            print("vetor %d: assinatura valida RECUSADA" % i)
            return 1
        if h.rsa_verifica(n, e, d, sig ^ (1 << (i * 97 % 2040))):
            print("vetor %d: assinatura adulterada ACEITA" % i)
            return 1
        print("vetor %d: valida aceita, adulterada recusada" % i)
    print("%d vetores do CAVP conferidos" % len(vs))
    return 0


# --------------------------------------------------------------------
# Selftest do codec (sem placa)
# --------------------------------------------------------------------
def selftest():
    m = monta(b"AB12", "C0", b"xyz")
    assert m == b"AB12C0xyz"
    assert resposta_esperada("K0") == "K1"
    assert resposta_esperada("M2") == "M3"
    assert resposta_esperada("R4") == "R5"
    assert resposta_esperada("R2") == "R3"
    _, n, e, d = chave_cavp()
    assert pow(pow(em_pkcs1(bytes(32)), d, n), e, n) == em_pkcs1(bytes(32))
    assert len(vetores_cavp()) == 10
    assert analisa(b"AB12K100resto", b"AB12", "K0") == (0, b"resto")
    assert analisa(b"AB12M301", b"AB12", "M2") == (1, b"")
    for ruim, motivo in ((b"AB12K1", "curta"), (b"XX12K100", "cabecalho"),
                         (b"AB12K300", "codigo")):
        try:
            analisa(ruim, b"AB12", "K0")
        except ValueError:
            pass
        else:
            raise AssertionError("resposta %s aceita" % motivo)
    try:
        monta(b"\x01AAA", "D0")
    except ValueError:
        pass
    else:
        raise AssertionError("cabecalho que seria lido como binario aceito")
    assert dados(b"\x01\xab") == b"0002" + b"01AB"
    assert le_dados(b"000201ABresto") == (b"\x01\xab", b"resto")
    print("selftest: OK")
    return 0


# --------------------------------------------------------------------
# confere: o Python conferindo o C pela porta host
# --------------------------------------------------------------------
def confere(h, lmk, n):
    """Gera chaves pela porta host e confere tudo com implementacao
    independente: o tr31.py abre o bloco com a LMK, e o AES e o CMAC da
    biblioteca `cryptography` refazem o que o dispositivo fez.

    ⚠ PRECISA DA LMK -- o brinquedo aparecendo, como no keycycle do
    console. Um host de verdade nunca tem a chave mestra."""
    import tr31
    from hsmtool import _kcv_local

    d = h.diag()
    if d["kcv_lmk"] != _kcv_local(lmk).hex().upper():
        print("KCV da LMK nao confere: dispositivo %s, informada %s"
              % (d["kcv_lmk"], _kcv_local(lmk).hex().upper()))
        return 1

    for volta in range(n):
        bloco, kcv = h.gen("D0", "B", "E")
        chave, cab = tr31.desembrulha(lmk, bloco)
        assert _kcv_local(chave).hex().upper() == kcv, "KCV do K0"
        iv, texto = os.urandom(16), os.urandom(16 * (1 + volta % 10))
        cif = h.cripto(bloco, iv, texto, True)
        assert cif == tr31._cbc(chave, iv, texto, True), "C0"
        assert h.cripto(bloco, iv, cif, False) == texto, "C2"

        bloco_m, _ = h.gen("M0", "C", "N")
        chave_m, _ = tr31.desembrulha(lmk, bloco_m)
        msg = os.urandom(volta % (ASCII_DADOS_MAX + 1))
        tag = h.mac(bloco_m, msg)
        assert tag == tr31.cmac_aes(chave_m, msg), "M0"
        assert h.mac_verifica(bloco_m, tag, msg), "M2"
        ruim = bytes([tag[0] ^ 1]) + tag[1:]
        assert not h.mac_verifica(bloco_m, ruim, msg), "M2 com bit trocado"

        # O sentido inverso: um bloco que o PYTHON fez, sob a mesma LMK.
        minha = os.urandom(32)
        meu = tr31.embrulha(lmk, minha, modo="B")
        assert h.check(meu)["kcv"] == _kcv_local(minha).hex().upper(), "K2"
        assert h.cripto(meu, iv, texto, True) == \
            tr31._cbc(minha, iv, texto, True), "C0 com bloco do Python"

        # KEK: o Python faz o papel da OUTRA instituicao, que tem a KEK
        # em claro (la ela veio de componentes; aqui, do bloco aberto).
        kek_lmk, kcv_kek = h.gen("K0", "B", "E")
        kek, _ = tr31.desembrulha(lmk, kek_lmk)
        assert _kcv_local(kek).hex().upper() == kcv_kek, "KCV da KEK"
        sai, kcv_sai = h.exporta(kek_lmk, bloco)
        aberta, cab_sai = tr31.desembrulha(kek, sai)
        assert aberta == chave and kcv_sai == kcv, "K4"
        assert cab_sai == cab, "K4: cabecalho mudou na exportacao"

        dela = os.urandom(32)
        recebido = tr31.embrulha(kek, dela, modo="E", exportabilidade="N")
        aqui, kcv_aqui = h.importa(kek_lmk, recebido)
        guardada, cab_aqui = tr31.desembrulha(lmk, aqui)
        assert guardada == dela, "K6"
        assert kcv_aqui == _kcv_local(dela).hex().upper(), "K6: KCV"
        assert cab_aqui["modo"] == "E" and \
            cab_aqui["exportabilidade"] == "N", "K6: cabecalho"
        assert h.cripto(aqui, iv, texto, True) == \
            tr31._cbc(dela, iv, texto, True), "C0 com a chave importada"

        def recusa(codigo, comando, *args):
            try:
                getattr(h, comando)(*args)
            except HostErro as e:
                assert e.codigo == codigo, "%s: %d, esperado %d" % (
                    comando, e.codigo, codigo)
            else:
                raise AssertionError("%s aceito, esperado %d"
                                     % (comando, codigo))
        recusa(12, "exporta", kek_lmk, aqui)        # 'N' nao segue adiante
        recusa(12, "exporta", kek_lmk, bloco_m)
        recusa(13, "exporta", bloco, bloco)         # chave de dados nao e KEK
        recusa(13, "importa", bloco, recebido)
        so_e, _ = h.gen("K0", "E", "E")             # KEK que so embrulha
        recusa(11, "importa", so_e, recebido)
        outra = tr31.embrulha(os.urandom(32), dela)  # sob outra KEK
        recusa(10, "importa", kek_lmk, outra)
        adulterado = recebido[:-1] + ("0" if recebido[-1] != "0" else "1")
        recusa(10, "importa", kek_lmk, adulterado)

        # O uso manda junto com o modo.
        recusa(11, "cripto", kek_lmk, iv, texto, True)   # KEK nao cifra
        recusa(11, "cripto", kek_lmk, iv, texto, False)  # nem decifra
        recusa(11, "mac", kek_lmk, msg)                  # nem autentica
        d_c, _ = h.gen("D0", "C", "E")                   # modo de MAC, uso D0
        recusa(11, "mac", d_c, msg)
        m_b, _ = h.gen("M0", "B", "E")                   # modo de cifra, uso M0
        recusa(11, "cripto", m_b, iv, texto, True)
        print("volta %d: K0/K2/C0/C2/M0/M2/K4/K6 conferidos" % (volta + 1))
    print("%d de %d voltas conferidas" % (n, n))
    return 0


# --------------------------------------------------------------------
def main(argv=None):
    ap = argparse.ArgumentParser(description="porta HOST do HSM (ASCII)")
    tr = ap.add_mutually_exclusive_group()
    tr.add_argument("--tcp", default="127.0.0.1:1500",
                    help="ponte TCP (padrao 127.0.0.1:1500)")
    tr.add_argument("--serial", action="store_true",
                    help="direto na serial, sem a ponte")
    ap.add_argument("--porta", default=None,
                    help="porta serial (com --serial; padrao: CP2102)")
    ap.add_argument("--cab", default="0000", help="cabecalho, 4 caracteres")
    sub = ap.add_subparsers(dest="cmd", required=True)

    sub.add_parser("selftest")
    sub.add_parser("diag")
    p = sub.add_parser("gen")
    p.add_argument("--uso", default="D0")
    p.add_argument("--modo", default="B", choices=list("EDBGVCN"))
    p.add_argument("--exp", default="E", choices=list("ENS"))
    p = sub.add_parser("check"); p.add_argument("bloco")
    for nome in ("export", "import"):
        p = sub.add_parser(nome); p.add_argument("kek"); p.add_argument("bloco")
    for nome in ("encrypt", "decrypt"):
        p = sub.add_parser(nome)
        p.add_argument("bloco"); p.add_argument("iv"); p.add_argument("dados")
    p = sub.add_parser("mac"); p.add_argument("bloco"); p.add_argument("dados")
    p = sub.add_parser("mac-verify")
    p.add_argument("bloco"); p.add_argument("mac"); p.add_argument("dados")
    p = sub.add_parser("rsa-verify")
    for c in ("n", "e", "digest", "s"):
        p.add_argument(c)
    p = sub.add_parser("rsa-cavp")
    p.add_argument("--lmk", default=None, help="LMK em hex (brinquedo)")
    p = sub.add_parser("rsa-sign"); p.add_argument("bloco"); p.add_argument("digest")
    p = sub.add_parser("rsa-gen"); p.add_argument("--exp", default="E", choices=list("ENS"))
    p = sub.add_parser("rsa-confere"); p.add_argument("-n", type=int, default=3)
    p = sub.add_parser("ecdsa-verify")
    for c in ("qx", "qy", "digest", "r", "s"):
        p.add_argument(c)
    p = sub.add_parser("ecdsa-cavp")
    p.add_argument("--lmk", default=None, help="LMK em hex (brinquedo)")
    p = sub.add_parser("ecdsa-sign"); p.add_argument("bloco"); p.add_argument("digest")
    p = sub.add_parser("ecdsa-gen"); p.add_argument("--exp", default="E", choices=list("ENS"))
    p = sub.add_parser("ecdsa-confere"); p.add_argument("-n", type=int, default=3)
    p = sub.add_parser("confere")
    p.add_argument("--lmk", required=True, help="LMK em hex (brinquedo)")
    p.add_argument("-n", type=int, default=10)

    a = ap.parse_args(argv)
    if a.cmd == "selftest":
        return selftest()

    t = Serial(a.porta) if a.serial else Tcp(a.tcp)
    h = Host(t, a.cab.encode())
    try:
        if a.cmd == "diag":
            d = h.diag()
            nomes = {0: "UNINITIALIZED", 1: "AUTHORIZED", 2: "OPERATIONAL"}
            print("estado     : %s (%d)" % (nomes.get(d["estado"], "?"),
                                            d["estado"]))
            print("KCV da LMK : %s" % d["kcv_lmk"])
            print("firmware   : v%s" % d["versao"])
        elif a.cmd == "gen":
            bloco, kcv = h.gen(a.uso, a.modo, a.exp)
            print(bloco)
            print("KCV %s" % kcv, file=sys.stderr)
        elif a.cmd == "check":
            for k, v in h.check(a.bloco).items():
                print("%-16s: %s" % (k, v))
        elif a.cmd in ("export", "import"):
            f = h.exporta if a.cmd == "export" else h.importa
            bloco, kcv = f(a.kek, a.bloco)
            print(bloco)
            print("KCV %s" % kcv, file=sys.stderr)
        elif a.cmd in ("encrypt", "decrypt"):
            print(h.cripto(a.bloco, bytes.fromhex(a.iv),
                           bytes.fromhex(a.dados),
                           a.cmd == "encrypt").hex().upper())
        elif a.cmd == "mac":
            print(h.mac(a.bloco, bytes.fromhex(a.dados)).hex().upper())
        elif a.cmd == "mac-verify":
            ok = h.mac_verifica(a.bloco, bytes.fromhex(a.mac),
                                bytes.fromhex(a.dados))
            print("MAC confere" if ok else "MAC NAO confere")
            return 0 if ok else 1
        elif a.cmd == "rsa-verify":
            ok = h.rsa_verifica(int(a.n, 16), int(a.e, 16),
                                bytes.fromhex(a.digest), int(a.s, 16))
            print("assinatura confere" if ok else "assinatura NAO confere")
            return 0 if ok else 1
        elif a.cmd == "rsa-cavp":
            return rsa_cavp(h, bytes.fromhex(a.lmk) if a.lmk else None)
        elif a.cmd == "rsa-gen":
            bloco, n, e = h.rsa_gera(a.exp)
            print(bloco)
            print("n %0512X" % n, file=sys.stderr)
            print("e %08X" % e, file=sys.stderr)
        elif a.cmd == "rsa-confere":
            return rsa_confere(h, a.n)
        elif a.cmd == "rsa-sign":
            print("%0512X" % h.rsa_assina(a.bloco, bytes.fromhex(a.digest)))
        elif a.cmd == "ecdsa-verify":
            ok = h.ecdsa_verifica(int(a.qx, 16), int(a.qy, 16),
                                  bytes.fromhex(a.digest), int(a.r, 16), int(a.s, 16))
            print("assinatura confere" if ok else "assinatura NAO confere")
            return 0 if ok else 1
        elif a.cmd == "ecdsa-cavp":
            return ecdsa_cavp(h, bytes.fromhex(a.lmk) if a.lmk else None)
        elif a.cmd == "ecdsa-gen":
            bloco, qx, qy = h.ecdsa_gera(a.exp)
            print(bloco)
            print("Qx %064X" % qx, file=sys.stderr)
            print("Qy %064X" % qy, file=sys.stderr)
        elif a.cmd == "ecdsa-confere":
            return ecdsa_confere(h, a.n)
        elif a.cmd == "ecdsa-sign":
            print("%064X %064X" % h.ecdsa_assina(a.bloco, bytes.fromhex(a.digest)))
        elif a.cmd == "confere":
            return confere(h, bytes.fromhex(a.lmk), a.n)
    except HostErro as e:
        print("dispositivo recusou: %s" % e, file=sys.stderr)
        return 1
    finally:
        t.close()
    return 0


if __name__ == "__main__":
    sys.path.insert(0, os.path.dirname(os.path.abspath(__file__)))
    sys.exit(main())
