flavioalsoares/hsm-a7/host/hsmtool.py

#!/usr/bin/env python3
"""CLI do host para o HSM educacional (Artix-7 / NEORV32).

FRONTEIRA: tudo aqui esta FORA. Este programa nunca ve chave em claro --
so key blocks wrapped, KCVs, criptogramas, handles e log. Se algum comando
futuro fizer material de chave aparecer neste arquivo, o comando esta errado,
nao o script.

Protocolo (PLANO.md secao 2, espelhando fw/include/cmd.h):

    pedido    LEN(2) | CMD(1)    | PAYLOAD | CRC32(4)
    resposta  LEN(2) | STATUS(1) | PAYLOAD | CRC32(4)

Tudo big-endian. LEN cobre CMD/STATUS + PAYLOAD, e nao se inclui nem inclui
o CRC. O CRC32 cobre LEN + CMD/STATUS + PAYLOAD -- todos os bytes menos os
quatro dele proprio -- com o polinomio IEEE 802.3 refletido, que e
exatamente o zlib.crc32.

Uso:
    hsmtool.py selftest              # sem placa: confere o codec
    hsmtool.py ping
    hsmtool.py version
    hsmtool.py bench -n 10000        # criterio de aceitacao da fase 1
    hsmtool.py raw --op 0x01

Cerimonia de LMK (fase 3) -- exige os dois botoes da placa:
    hsmtool.py lmk-status
    hsmtool.py lmk-load 0 --random
    hsmtool.py activate
    hsmtool.py gen-key --uso D0 --modo B --exp E
    hsmtool.py export-key 1
    hsmtool.py import-key D0144...
    hsmtool.py key-info 1
    hsmtool.py delete-key 1          # apaga UM slot, sem botao
    hsmtool.py audit                 # log de auditoria (fase 4)
    hsmtool.py comp-load 0 2 --random   # chave por componentes (dual control)
    hsmtool.py encrypt 1 <iv hex> <dados hex>
    hsmtool.py decrypt 1 <iv hex> <dados hex>
    hsmtool.py mac 2 <mensagem hex>          # chave de modo G ou C
    hsmtool.py mac-verify 2 <tag> <mensagem>
    hsmtool.py keycycle --lmk <hex>  # o Python confere o firmware
    hsmtool.py zeroize               # APAGA tudo, irreversivel

Desde a fase 4 a LMK, o estado e as chaves PERSISTEM na flash: desligar e
religar devolve o dispositivo como estava, sem cerimonia. O `post` zera a
BRAM (o autoteste exercita o key store de verdade) e restaura da flash em
seguida. So o `zeroize` apaga de vez.
"""

import argparse
import glob
import os
import struct
import sys
import time
import zlib

try:
    import serial
except ImportError:
    serial = None


# --------------------------------------------------------------------
# Constantes -- espelham fw/include/cmd.h e fw/include/hsm_status.h.
# Divergir daqui e a forma mais rapida de gastar uma tarde.
# --------------------------------------------------------------------

BAUD_RATE = 115200
TIMEOUT_S = 2.0                 # PLANO.md secao 2

MAX_PAYLOAD = 2048
MIN_LEN = 1
MAX_LEN = MAX_PAYLOAD + 1

CMD_PING = 0x01
CMD_GET_VERSION = 0x02
CMD_GET_DNA = 0x03

# Fase 2 -- primitivas.
#
# AES e HMAC mandam a CHAVE no payload e por isso so respondem em
# UNINITIALIZED. Nao e limitacao de implementacao: e a mascara de estados
# do firmware. Um HSM de verdade nao aceita chave em claro do host -- estes
# comandos existem para exercitar as primitivas antes de existir key store,
# e a fase 3 os substitui por versoes que falam por handle de slot.
# 0x10 (AES_ENC) e 0x11 (AES_DEC) foram REMOVIDOS do firmware em
# 2026-09-01: recebiam a chave no payload, e material de chave nao pode
# atravessar a fronteira em direcao nenhuma. Substitutos: `encrypt` e
# `decrypt`, por handle.
# 0x13 (HMAC) saiu em 2026-09-25, quando o substituto ficou pronto:
# `mac` e `mac-verify`, com a chave por handle. NENHUM COMANDO DESTE
# DISPOSITIVO ACEITA MAIS CHAVE EM CLARO.
CMD_SHA256 = 0x12
CMD_RANDOM = 0x14
CMD_SELFTEST = 0x15

# Fase 3 -- hierarquia de chaves.
#
# LMK_LOAD_COMPONENT e SET_STATE exigem DUAL CONTROL: os dois botoes da
# placa (SW2 e SW5) pressionados no instante em que o frame chega. Nao ha
# como o host suprir isso, e e esse o ponto -- o unico comando do projeto
# cuja autorizacao nao esta neste link.
CMD_LMK_LOAD_COMPONENT = 0x20
CMD_LMK_STATUS = 0x21
CMD_SET_STATE = 0x26
CMD_GEN_KEY = 0x22
CMD_EXPORT_KEY = 0x23
CMD_IMPORT_KEY = 0x24
CMD_KEY_INFO = 0x25
CMD_ENCRYPT = 0x27
CMD_DECRYPT = 0x28
CMD_MAC_GENERATE = 0x29
CMD_MAC_VERIFY = 0x2A
CMD_DELETE_KEY = 0x2B
CMD_KEY_FROM_COMPONENTS = 0x2C
CMD_ZEROIZE = 0x2F
CMD_AUDIT_READ = 0x2D
CMD_ENV_READ = 0x2E

LMK_N_COMPONENTES = 3
LMK_KEY_LEN = 32
KCV_LEN = 3

# Bits devolvidos pelo SELFTEST -- espelham fw/include/kat.h
KAT_BITS = [
    (0x01, "AES-256"),
    (0x02, "SHA-256"),
    (0x04, "HMAC-SHA-256"),
    (0x08, "CTR_DRBG"),
    (0x10, "TRNG / health tests"),
    (0x20, "CMAC-AES-256"),
    (0x40, "key store"),
    (0x80, "key block X9.143"),
    (0x100, "RSA-2048"),
]

# Autotestes de PRIMEIRO USO (fase 7): o SELFTEST nao os roda. O bit so
# aparece se o teste ja reprovou neste boot.
KAT_BITS_USO = [
    (0x200, "assinatura RSA"),
    (0x400, "ECDSA P-256"),
]

STATUS_NAMES = {
    0x00: "OK",
    0x01: "BAD_CRC",
    0x02: "BAD_LEN",
    0x03: "TIMEOUT",
    0x10: "UNKNOWN_CMD",
    0x11: "BAD_PARAM",
    0x12: "NOT_IMPLEMENTED",
    0x20: "WRONG_STATE",
    0x21: "NOT_AUTHORIZED",
    0x22: "NOT_EXPORTABLE",
    0x23: "NO_SLOT",
    0x24: "BAD_KEY_USE",
    0x25: "MAC_INVALID",
    0x26: "STORE_FAIL",
    0x27: "LOG_FAIL",
    0x30: "SELFTEST_FAIL",
    0x31: "TAMPERED",
    0x32: "CRYPTO_FAIL",
    0xFF: "INTERNAL_ERROR",
}

STATE_NAMES = {0: "UNINITIALIZED", 1: "AUTHORIZED", 2: "OPERATIONAL", 3: "TAMPERED"}

# O firmware resincroniza depois de CMD_INTERBYTE_TIMEOUT_MS sem bytes.
# Esperar um pouco mais que isso e a forma de voltar ao inicio de frame
# depois de um erro, sem adivinhar onde o frame anterior terminou.
FW_INTERBYTE_TIMEOUT_S = 0.250


class ProtocolError(Exception):
    pass


class CrcError(ProtocolError):
    pass


class FrameTimeout(ProtocolError):
    pass


class HsmError(Exception):
    """O dispositivo respondeu um frame valido com STATUS != OK."""

    def __init__(self, status, payload=b""):
        self.status = status
        self.payload = payload
        name = STATUS_NAMES.get(status, "?")
        super().__init__("STATUS_%s (0x%02X)" % (name, status))


# --------------------------------------------------------------------
# Codec -- sem dependencia de porta serial, para poder ser testado sozinho
# --------------------------------------------------------------------


def crc32(data: bytes) -> int:
    return zlib.crc32(data) & 0xFFFFFFFF


def build_request(opcode: int, payload: bytes = b"") -> bytes:
    """Monta um frame de pedido completo."""
    if not 0 <= opcode <= 0xFF:
        raise ValueError("opcode fora de faixa: %r" % opcode)
    if len(payload) > MAX_PAYLOAD:
        raise ValueError("payload de %d bytes excede o maximo de %d"
                         % (len(payload), MAX_PAYLOAD))

    body = bytes([opcode]) + payload
    head = len(body).to_bytes(2, "big") + body
    return head + crc32(head).to_bytes(4, "big")


def parse_response(frame: bytes):
    """Valida um frame de resposta completo. Devolve (status, payload)."""
    if len(frame) < 2 + MIN_LEN + 4:
        raise ProtocolError("frame curto demais: %d bytes" % len(frame))

    length = int.from_bytes(frame[0:2], "big")
    if not MIN_LEN <= length <= MAX_LEN:
        raise ProtocolError("LEN invalido: %d" % length)
    if len(frame) != 2 + length + 4:
        raise ProtocolError("frame tem %d bytes, LEN=%d pedia %d"
                            % (len(frame), length, 2 + length + 4))

    calc = crc32(frame[:2 + length])
    got = int.from_bytes(frame[2 + length:], "big")
    if calc != got:
        raise CrcError("CRC32 calculado %08X, recebido %08X" % (calc, got))

    return frame[2], frame[3:2 + length]


# --------------------------------------------------------------------
# Transporte
# --------------------------------------------------------------------


# O canal do HSM sai pelo CP2102 do core board (pinos T15/T14).
CP210X_VID = 0x10C4
CP210X_PID = 0xEA60

# O adaptador JTAG "DLC9LP" e um FT232H que tambem cria uma /dev/ttyUSB*.
# Ela NAO e a UART do HSM -- e o cabo de gravacao.
FTDI_JTAG_VID = 0x0403
FTDI_JTAG_PID = 0x6014


def default_port():
    """Escolhe a porta do HSM por VID:PID, nao por ordem alfabetica.

    Com o cabo de gravacao ligado existem duas /dev/ttyUSB*, e a primeira
    costuma ser o adaptador JTAG -- escolher pelo nome acerta o cabo errado
    e o sintoma e um timeout sem explicacao. Descoberto na bancada.
    """
    try:
        from serial.tools import list_ports
    except ImportError:
        candidates = sorted(glob.glob("/dev/ttyUSB*")) + sorted(glob.glob("/dev/ttyACM*"))
        return candidates[0] if candidates else None

    ports = list(list_ports.comports())

    for p in ports:
        if (p.vid, p.pid) == (CP210X_VID, CP210X_PID):
            return p.device

    # Sobrou alguma que nao seja o gravador?
    others = [p for p in ports
              if (p.vid, p.pid) != (FTDI_JTAG_VID, FTDI_JTAG_PID)]
    if others:
        return sorted(others, key=lambda p: p.device)[0].device

    return None


class HsmClient:
    def __init__(self, port, baud=BAUD_RATE, timeout=TIMEOUT_S):
        if serial is None:
            raise RuntimeError(
                "pyserial nao instalado: sudo apt install python3-serial")
        self.ser = serial.Serial(port, baud, timeout=timeout)
        self.timeout = timeout

        # O dispositivo e mudo ate ser perguntado -- nao ha banner para
        # descartar. Ainda assim, limpar uma vez na abertura remove lixo de
        # uma sessao anterior interrompida no meio de um frame.
        time.sleep(FW_INTERBYTE_TIMEOUT_S)
        self.ser.reset_input_buffer()

    def close(self):
        self.ser.close()

    def __enter__(self):
        return self

    def __exit__(self, *exc):
        self.close()

    def _read_exact(self, n):
        buf = b""
        while len(buf) < n:
            chunk = self.ser.read(n - len(buf))
            if not chunk:
                raise FrameTimeout(
                    "sem resposta apos %.1f s (%d de %d bytes)"
                    % (self.timeout, len(buf), n))
            buf += chunk
        return buf

    def resync(self):
        """Volta ao inicio de frame depois de um erro.

        Espera mais que o timeout de inter-byte do firmware, para que ele
        tambem abandone qualquer frame parcial, e so entao descarta o que
        estiver na entrada.
        """
        time.sleep(FW_INTERBYTE_TIMEOUT_S * 1.5)
        self.ser.reset_input_buffer()

    def transact(self, opcode, payload=b""):
        """Envia um comando e devolve (status, payload) do frame de resposta.

        Nao limpa a entrada antes de enviar, de proposito: byte inesperado
        na linha e sintoma de dessincronizacao, e engolir isso em silencio
        transformaria o teste de 10.000 pings numa medida sem valor.
        """
        self.ser.write(build_request(opcode, payload))

        head = self._read_exact(2)
        length = int.from_bytes(head, "big")
        if not MIN_LEN <= length <= MAX_LEN:
            self.resync()
            raise ProtocolError("LEN invalido na resposta: %d" % length)

        rest = self._read_exact(length + 4)
        return parse_response(head + rest)

    def command(self, opcode, payload=b""):
        """Como transact, mas levanta HsmError se o status nao for OK."""
        status, data = self.transact(opcode, payload)
        if status != 0x00:
            raise HsmError(status, data)
        return data


# --------------------------------------------------------------------
# Selftest do codec -- roda sem placa
# --------------------------------------------------------------------

# Bytes conferidos contra TRES implementacoes independentes: o firmware em C,
# o testbench em Verilog (tb_uart_frame) e o zlib. Sao vetores fixos de
# proposito -- se fossem gerados por este mesmo modulo, o teste so provaria
# que o codigo concorda consigo mesmo.
VECTORS = [
    ("pedido PING",        build_request, (CMD_PING,),        "000101915dd8c5"),
    ("pedido GET_VERSION", build_request, (CMD_GET_VERSION,), "0001020854897f"),
]

RESP_PONG = bytes.fromhex("00050050" + "4f4e47" + "fb283d2a")


def selftest():
    fails = 0

    for name, fn, args, expect in VECTORS:
        got = fn(*args).hex()
        if got != expect:
            print("FAIL  %-20s esperado %s, obtido %s" % (name, expect, got))
            fails += 1
        else:
            print("ok    %-20s %s" % (name, got))

    # resposta valida
    try:
        status, payload = parse_response(RESP_PONG)
        if status != 0x00 or payload != b"PONG":
            print("FAIL  resposta PONG      status=0x%02X payload=%r" % (status, payload))
            fails += 1
        else:
            print("ok    resposta PONG      status=OK payload=b'PONG'")
    except ProtocolError as e:
        print("FAIL  resposta PONG      %s" % e)
        fails += 1

    # CRC corrompido tem de ser recusado
    bad = bytearray(RESP_PONG)
    bad[-1] ^= 0x01
    try:
        parse_response(bytes(bad))
        print("FAIL  CRC corrompido     aceito, deveria ser recusado")
        fails += 1
    except CrcError:
        print("ok    CRC corrompido     recusado")

    # um bit trocado no payload tambem
    bad = bytearray(RESP_PONG)
    bad[3] ^= 0x01
    try:
        parse_response(bytes(bad))
        print("FAIL  payload alterado   aceito, deveria ser recusado")
        fails += 1
    except CrcError:
        print("ok    payload alterado   recusado")

    # limites de LEN
    for length in (0, MAX_LEN + 1):
        head = length.to_bytes(2, "big") + b"\x00"
        frame = head + crc32(head).to_bytes(4, "big")
        try:
            parse_response(frame)
            print("FAIL  LEN=%d            aceito, deveria ser recusado" % length)
            fails += 1
        except ProtocolError:
            print("ok    LEN=%-14d recusado" % length)

    # payload grande demais no pedido
    try:
        build_request(CMD_PING, b"\x00" * (MAX_PAYLOAD + 1))
        print("FAIL  payload > maximo   aceito, deveria ser recusado")
        fails += 1
    except ValueError:
        print("ok    payload > maximo   recusado")

    print()
    if fails:
        print("selftest: %d falha(s)" % fails)
    else:
        print("selftest: OK")
    return 1 if fails else 0


# --------------------------------------------------------------------
# Comandos da CLI
# --------------------------------------------------------------------


def cmd_ping(client, args):
    t0 = time.perf_counter()
    payload = client.command(CMD_PING)
    dt = (time.perf_counter() - t0) * 1000.0

    if payload != b"PONG":
        print("resposta inesperada: %r" % payload)
        return 1
    print("PONG  (%.2f ms)" % dt)
    return 0


def cmd_version(client, args):
    p = client.command(CMD_GET_VERSION)
    if len(p) != 4:
        print("payload inesperado: %r" % p)
        return 1
    major, minor, patch, state = p
    print("firmware : v%d.%d.%d" % (major, minor, patch))
    print("estado   : %s (%d)" % (STATE_NAMES.get(state, "?"), state))
    return 0


def cmd_dna(client, args):
    """Identidade de fabrica do die: 57 bits, big-endian em 8 bytes.

    NAO E SEGREDO. Qualquer um com um cabo JTAG le o mesmo valor, e ele nao
    muda nunca. Serve para identificar a placa em log de auditoria e em
    inventario. Derivar chave dele e um erro classico -- o valor e publico e
    constante, que sao exatamente as duas propriedades que uma chave nao
    pode ter.
    """
    p = client.command(CMD_GET_DNA)
    if len(p) != 8:
        print("payload inesperado: %r" % p)
        return 1

    v = int.from_bytes(p, "big")
    if v >> 57:
        print("DNA fora de 57 bits: %s" % p.hex())
        return 1

    print("DNA: %015X  (57 bits)" % v)
    return 0


def cmd_sha256(client, args):
    msg = bytes.fromhex(args.data) if args.data else b""
    p = client.command(CMD_SHA256, msg)
    print(p.hex())
    return 0


def cmd_random(client, args):
    """Bytes do CTR_DRBG.

    NAO e a fonte bruta: a saida da fonte de ruido nunca atravessa a
    fronteira. O que sai aqui e saida de DRBG semeado por ela.
    """
    total = args.n
    if total < 1:
        print("n precisa ser >= 1")
        return 1

    saida = bytearray()
    while len(saida) < total:
        pedaco = min(256, total - len(saida))
        saida += client.command(CMD_RANDOM, pedaco.to_bytes(2, "big"))

    if args.out:
        with open(args.out, "wb") as f:
            f.write(bytes(saida))
        print("%d bytes -> %s" % (len(saida), args.out))
    else:
        print(bytes(saida).hex())
    return 0


def cmd_selftest_dev(client, args):
    """Reroda o POST no dispositivo e mostra o que passou.

    Reprovar aqui leva o dispositivo a TAMPERED, igual ao boot. Por isso o
    comando responde ate em TAMPERED: sem ele, um dispositivo que reprovou
    fica mudo sobre O QUE reprovou.

    O teste de funcao critica do key store instala e apaga chaves de
    verdade e termina com a BRAM vazia, LMK inclusive -- um autoteste que
    poupasse a LMK testaria outro caminho. Desde a fase 4 o dispositivo
    restaura LMK, estado e chaves da flash logo em seguida, pelo mesmo
    caminho do boot.
    """
    status, data = client.transact(CMD_SELFTEST)

    if not data:
        print("status 0x%02X %s, sem payload"
              % (status, STATUS_NAMES.get(status, "?")))
        return 1

    r = int.from_bytes(data[:2], "little")
    for bit, nome in KAT_BITS:
        print("  %-22s %s" % (nome, "FALHOU" if (r & bit) else "ok"))
    for bit, nome in KAT_BITS_USO:
        print("  %-22s %s" % (nome, "FALHOU" if (r & bit)
                              else "roda no primeiro uso"))

    if r == 0:
        print("\nPOST: OK")
        print("  (zerou a BRAM; fora de TAMPERED, restaurou LMK e chaves da flash)")
        return 0

    print("\nPOST REPROVOU (mascara 0x%03X). O dispositivo esta em TAMPERED"
          " e nao aceita mais comando de operacao." % r)
    return 1


# --------------------------------------------------------------------
# Cerimonia de LMK -- fase 3
#
# FRONTEIRA: o componente atravessa este arquivo em claro, e e a maior
# distancia entre este projeto e um HSM de verdade. Num equipamento real o
# componente entra por teclado local ou smart card do custodiante, nunca
# pela mesma porta por onde o host fala. Aqui a porta e uma so.
#
# Esta escrito, e nao escondido: o valor didatico esta em ver exatamente
# onde o brinquedo deixa de imitar o original.
# --------------------------------------------------------------------


def _pede_dual_control(o_que):
    """Pede o gesto fisico e espera.

    O host NAO consegue verificar nem simular isso -- e o ponto. Se os
    botoes nao estiverem apertados quando o frame chegar, o dispositivo
    devolve STATUS_NOT_AUTHORIZED, e essa recusa e a unica prova de que o
    dual control existe de verdade.

    Cada autorizacao exige um aperto NOVO: entre um componente e o
    seguinte, os dois botoes precisam ser vistos SOLTOS. Segurar os dois
    durante a cerimonia inteira nao carrega tres componentes -- carrega um.
    """
    print()
    print(o_que)
    print()
    print("  Os botoes sao os DOIS MAIS AFASTADOS da fileira de cinco, sem")
    print("  contar o reset. Contando a partir do reset:")
    print()
    print("      [reset]  [ * ]   [   ]   [   ]   [ * ]")
    print("        SW1     SW2     SW3     SW4     SW5")
    print("                 ^                       ^")
    print("                 2o                     5o (ultimo)")
    print()
    print("  SOLTE os dois, depois SEGURE os dois juntos e tecle Enter")
    print("  SEM SOLTAR.")
    try:
        input()
    except EOFError:
        print("  (sem terminal interativo -- enviando assim mesmo)",
              file=sys.stderr)


def cmd_lmk_status(client, args):
    p = client.command(CMD_LMK_STATUS)
    if len(p) != 2 + KCV_LEN:
        print("payload inesperado: %r" % p)
        return 1

    carregados, completa = p[0], p[1]
    kcv = p[2:]

    print("componentes : %d de %d" % (carregados, LMK_N_COMPONENTES))
    if completa:
        print("KCV da LMK  : %s" % kcv.hex().upper())
    else:
        # O firmware devolve o KCV zerado quando incompleta, de proposito:
        # resposta de comprimento fixo nao anuncia nada pelo tamanho.
        print("KCV da LMK  : -- (incompleta)")
    return 0


def cmd_lmk_load(client, args):
    """Carrega um componente da LMK. Exige dual control."""
    n = args.n
    if not 0 <= n < LMK_N_COMPONENTES:
        print("componente %d fora de 0..%d" % (n, LMK_N_COMPONENTES - 1),
              file=sys.stderr)
        return 2

    if args.random:
        # os.urandom, e nao o RANDOM do dispositivo: um componente gerado
        # pelo proprio modulo que vai guarda-lo nao e split knowledge
        # nenhuma -- o modulo saberia os tres. Num HSM de verdade cada
        # componente nasce com o seu custodiante.
        comp = os.urandom(LMK_KEY_LEN)
        print("componente %d gerado aqui no host:" % n)
        print("  %s" % comp.hex().upper())
        print("  Anote. Isto e um brinquedo: material de chave na tela e")
        print("  exatamente o que um HSM existe para evitar.")
    else:
        if not args.key:
            print("informe o componente em hex, ou use --random",
                  file=sys.stderr)
            return 2
        try:
            comp = bytes.fromhex(args.key)
        except ValueError:
            print("componente nao e hex valido", file=sys.stderr)
            return 2
        if len(comp) != LMK_KEY_LEN:
            print("componente tem %d bytes, esperado %d"
                  % (len(comp), LMK_KEY_LEN), file=sys.stderr)
            return 2

    _pede_dual_control("Carregar o componente %d da LMK." % n)

    try:
        p = client.command(CMD_LMK_LOAD_COMPONENT, bytes([n]) + comp)
    except HsmError as e:
        # No ultimo componente, BAD_PARAM e a LMK que daria 32 bytes de
        # zeros. O firmware recomeca a cerimonia: nao ha como saber qual
        # componente estava errado.
        if e.status == 0x11 and n == LMK_N_COMPONENTES - 1:
            print("  Se o indice estava certo, a LMK resultante seria ZERADA e")
            print("  foi recusada. A cerimonia recomeca do componente 0")
            print("  (confira com lmk-status).")
        raise
    if len(p) != KCV_LEN + 2:
        print("payload inesperado: %r" % p)
        return 1

    kcv, carregados, estado = p[:KCV_LEN], p[KCV_LEN], p[KCV_LEN + 1]

    # O KCV que volta e do COMPONENTE, nao da LMK acumulada. E o que permite
    # ao custodiante conferir que digitou o dele: sem isso, um componente
    # trocado so apareceria no KCV final, quando ja nao da para saber qual
    # dos tres estava errado.
    print("KCV do componente : %s" % kcv.hex().upper())
    print("componentes       : %d de %d" % (carregados, LMK_N_COMPONENTES))
    print("estado            : %s (%d)"
          % (STATE_NAMES.get(estado, "?"), estado))
    return 0


# --------------------------------------------------------------------
# Comandos de chave -- fase 3
#
# FRONTEIRA: nenhum deles faz chave em claro chegar aqui. GEN_KEY devolve
# handle e KCV; EXPORT_KEY devolve um key block EMBRULHADO; IMPORT_KEY
# recebe um. Se algum dia um destes imprimir material de chave, o comando
# esta errado, nao o script.
#
# A excecao consciente e `keycycle --lmk`, que precisa da chave mestra
# para conferir o trabalho do dispositivo com uma implementacao
# independente. Esta marcado la, e so existe porque isto e um brinquedo
# de bancada.
# --------------------------------------------------------------------

USOS = ("B0", "K0", "D0", "M0", "P0")


def _cab_args(p):
    p.add_argument("--uso", default="D0", choices=USOS,
                   help="uso X9.143 (padrao D0; cifrar exige D0, MAC "
                        "exige M0)")
    # Dois grupos que nao se cruzam: cifra (E/D/B) e MAC (G/V/C).
    p.add_argument("--modo", default="B",
                   choices=("E", "D", "B", "G", "V", "C", "N"),
                   help="modo de uso: E/D/B cifram, G/V/C fazem MAC "
                        "(padrao B)")
    p.add_argument("--exp", default="E", choices=("E", "N", "S"),
                   help="exportabilidade (padrao E)")


def cmd_gen_key(client, args):
    """Gera uma chave DENTRO do dispositivo. O host nunca ve o material."""
    pl = args.uso.encode("ascii") + b"A" + args.modo.encode("ascii") \
         + args.exp.encode("ascii")
    p = client.command(CMD_GEN_KEY, pl)
    if len(p) != 4:
        print("payload inesperado: %r" % p)
        return 1
    print("handle : %d" % p[0])
    print("KCV    : %s" % p[1:].hex().upper())
    return 0


def cmd_export_key(client, args):
    """Exporta um slot como key block X9.143. Sai embrulhado, sempre."""
    p = client.command(CMD_EXPORT_KEY, bytes([args.handle]))
    bloco = p.decode("ascii", errors="replace")
    print(bloco)
    if args.out:
        with open(args.out, "w") as f:
            f.write(bloco + "\n")
        print("(gravado em %s)" % args.out, file=sys.stderr)
    return 0


def cmd_import_key(client, args):
    """Importa um key block. Os metadados vem DO BLOCO, autenticados."""
    if args.file:
        bloco = open(args.file).read().strip()
    else:
        bloco = args.block.strip()
    p = client.command(CMD_IMPORT_KEY, bloco.encode("ascii"))
    if len(p) != 4:
        print("payload inesperado: %r" % p)
        return 1
    print("handle : %d" % p[0])
    print("KCV    : %s" % p[1:].hex().upper())
    return 0


def cmd_key_info(client, args):
    """Metadados de um slot. Nunca chave."""
    p = client.command(CMD_KEY_INFO, bytes([args.handle]))
    if len(p) != 13:
        print("payload inesperado: %r" % p)
        return 1
    print("uso             : %s" % p[0:2].decode("ascii", "replace"))
    print("algoritmo       : %s" % chr(p[2]))
    print("modo de uso     : %s" % chr(p[3]))
    print("exportabilidade : %s" % chr(p[4]))
    print("comprimento     : %d bytes" % p[5])
    print("KCV             : %s" % p[6:9].hex().upper())
    print("usos            : %d" % int.from_bytes(p[9:13], "big"))
    return 0


def _cripto(client, args, op):
    """ENCRYPT/DECRYPT por handle. A chave nunca aparece aqui."""
    try:
        iv = bytes.fromhex(args.iv)
        dados = bytes.fromhex(args.data)
    except ValueError:
        print("iv ou dados nao sao hex validos", file=sys.stderr)
        return 2
    if len(iv) != 16:
        print("iv tem %d bytes, esperado 16" % len(iv), file=sys.stderr)
        return 2
    if len(dados) == 0 or len(dados) % 16 != 0:
        print("dados: %d bytes -- tem de ser multiplo de 16 e nao vazio"
              % len(dados), file=sys.stderr)
        return 2

    p = client.command(op, bytes([args.handle]) + iv + dados)
    print(p.hex().upper())
    return 0


def cmd_encrypt(client, args):
    return _cripto(client, args, CMD_ENCRYPT)


def cmd_decrypt(client, args):
    return _cripto(client, args, CMD_DECRYPT)


def cmd_mac(client, args):
    """CMAC-AES-256 sob a chave de um slot. A chave nunca aparece aqui."""
    try:
        msg = bytes.fromhex(args.data)
    except ValueError:
        print("mensagem nao e hex valido", file=sys.stderr)
        return 2
    p = client.command(CMD_MAC_GENERATE, bytes([args.handle]) + msg)
    print(p.hex().upper())
    return 0


def cmd_mac_verify(client, args):
    """Verifica um MAC DENTRO do dispositivo.

    O veredito vem no status, nao no payload -- o dispositivo compara em
    tempo constante e devolve um bit. Devolver o MAC calculado para o host
    comparar entregaria 128 bits e reintroduziria o canal lateral.
    """
    try:
        tag = bytes.fromhex(args.tag)
        msg = bytes.fromhex(args.data)
    except ValueError:
        print("tag ou mensagem nao sao hex validos", file=sys.stderr)
        return 2
    if len(tag) != 16:
        print("tag tem %d bytes, esperado 16" % len(tag), file=sys.stderr)
        return 2
    try:
        client.command(CMD_MAC_VERIFY, bytes([args.handle]) + tag + msg)
    except HsmError as e:
        if e.status == 0x25:
            print("MAC INVALIDO")
            return 1
        raise
    print("MAC confere")
    return 0


def cmd_comp_load(client, args):
    """Monta uma chave de TRABALHO a partir de componentes.

    E a cerimonia de LMK um nivel abaixo: cada custodiante entra com a sua
    parte, ninguem ve a chave inteira, e o dispositivo monta por XOR
    dentro da fronteira. Exige dual control a cada componente.

    ⚠ O componente atravessa o link em claro, como na cerimonia de LMK.
    Mesma ressalva, mesma razao: ha uma interface so.
    """
    if not 0 <= args.n < args.total:
        print("componente %d fora de 0..%d" % (args.n, args.total - 1),
              file=sys.stderr)
        return 2

    if args.random:
        comp = os.urandom(LMK_KEY_LEN)
        print("componente %d gerado aqui no host:" % args.n)
        print("  %s" % comp.hex().upper())
        print("  Anote. Isto e um brinquedo: material de chave na tela e")
        print("  exatamente o que um HSM existe para evitar.")
    else:
        if not args.key:
            print("informe o componente em hex, ou use --random",
                  file=sys.stderr)
            return 2
        try:
            comp = bytes.fromhex(args.key)
        except ValueError:
            print("componente nao e hex valido", file=sys.stderr)
            return 2
        if len(comp) != LMK_KEY_LEN:
            print("componente tem %d bytes, esperado %d"
                  % (len(comp), LMK_KEY_LEN), file=sys.stderr)
            return 2

    _pede_dual_control("Componente %d de %d de uma chave de trabalho."
                       % (args.n, args.total))

    pl = (bytes([args.n, args.total])
          + args.uso.encode("ascii") + b"A"
          + args.modo.encode("ascii") + args.exp.encode("ascii")
          + comp)
    p = client.command(CMD_KEY_FROM_COMPONENTS, pl)
    if len(p) != KCV_LEN + 3:
        print("payload inesperado: %r" % p)
        return 1

    kcv, carregados, total, handle = p[:KCV_LEN], p[KCV_LEN], p[KCV_LEN+1], p[KCV_LEN+2]
    # O KCV e do COMPONENTE, nao do acumulado: e o que permite ao
    # custodiante conferir que digitou o dele.
    print("KCV do componente : %s" % kcv.hex().upper())
    print("componentes       : %d de %d" % (carregados, total))
    if handle:
        print("handle            : %d  <- chave montada e instalada" % handle)
    else:
        print("handle            : -- (montagem incompleta)")
    return 0


def cmd_delete_key(client, args):
    """Apaga um slot. Destrutivo, mas reversivel se voce tiver o key block."""
    p = client.command(CMD_DELETE_KEY, bytes([args.handle]))
    if len(p) != 1:
        print("payload inesperado: %r" % p)
        return 1
    print("apagado. slots livres: %d" % p[0])
    return 0


# Nomes dos opcodes, para o log. 0x00 nao e opcode: e o registro de boot.
OPCODE_NAMES = {
    0x00: "BOOT", 0x15: "SELFTEST", 0x20: "LMK_LOAD_COMPONENT",
    0x22: "GEN_KEY", 0x23: "EXPORT_KEY", 0x24: "IMPORT_KEY",
    0x26: "SET_STATE", 0x27: "ENCRYPT", 0x28: "DECRYPT",
    0x29: "MAC_GENERATE", 0x2A: "MAC_VERIFY", 0x2B: "DELETE_KEY",
    0x2C: "KEY_FROM_COMPONENTS", 0x2F: "ZEROIZE", 0x2E: "ENV_READ",
    0x0F: "TAMPER",
}
ESTADO_NOMES = {0: "Uni", 1: "Aut", 2: "OPE", 3: "tPr"}


# Bits do alarme de ambiente -- espelham fw/include/hsm_cfs.h
ENV_BITS = ["temperatura alta", "VCCINT", "VCCAUX", "VCCBRAM",
            "temperatura baixa", "sensor parado", "perda de lock",
            "ERRO GRAVE: dupla execucao discordou"]


def env_causas(bits):
    return [n for i, n in enumerate(ENV_BITS) if bits & (1 << i)]


def env_decodifica(p):
    """Resposta do ENV_READ em unidades. Funcoes de transferencia da UG480,
    Figuras 2-9 e 2-10."""
    retido, agora, valido, temp, vint, vaux, vbram = struct.unpack(">BBBHHHH", p)
    return {
        "retido": retido, "agora": agora, "valido": valido,
        "temp": temp * 503.975 / 4096 - 273.15,
        "vccint": vint * 3 / 4096, "vccaux": vaux * 3 / 4096,
        "vccbram": vbram * 3 / 4096,
    }


def cmd_env(client, args):
    """Temperatura e tensoes do die, e os alarmes de ambiente."""
    e = env_decodifica(client.command(CMD_ENV_READ))
    if not e["valido"]:
        print("sensores ainda sem leitura")
    print("temperatura : %.1f C" % e["temp"])
    print("VCCINT      : %.3f V" % e["vccint"])
    print("VCCAUX      : %.3f V" % e["vccaux"])
    print("VCCBRAM     : %.3f V" % e["vccbram"])
    print("agora       : %s" % (", ".join(env_causas(e["agora"])) or "nada"))
    print("retido      : %s" % (", ".join(env_causas(e["retido"])) or "nada"))


def cmd_audit(client, args):
    """Le o log de auditoria inteiro (ou a partir de --desde).

    Cada linha e um comando, gravado ANTES de executar. Resultado
    'PENDENTE' e um comando que comecou e nao terminou -- a energia caiu
    no meio, por exemplo. Ver fw/include/audit_log.h."""
    seq = args.desde
    proximo = None
    linhas = 0
    while proximo is None or seq < proximo:
        p = client.command(CMD_AUDIT_READ, struct.pack(">I", seq))
        proximo, continuar = struct.unpack(">II", p[:8])
        for i in range(8, len(p), 16):
            r = p[i:i + 16]
            s_, op, est, arg, res = struct.unpack(">IBBBB", r[:8])
            if op == 0x00:
                extra = []
                if arg & 0x80: extra.append("POST REPROVOU")
                if arg & 0x40: extra.append("SEM FLASH")
                extra.append({0: "sem registro persistente", 1: "restaurado",
                              2: "registro INVALIDO"}.get(arg & 3, "?"))
                detalhe = ", ".join(extra)
            elif op == 0x0F:
                detalhe = ", ".join(env_causas(arg))
            elif 0x30 <= op <= 0x7E:
                # Porta host (fase 5): os dois caracteres do comando ASCII
                # e o codigo de erro dele, em decimal.
                nome = "HOST %c%c" % (op, arg)
                detalhe = ""
                resultado = ("PENDENTE" if res == 0xFF
                             else ("OK" if res == 0 else "erro %02d" % res))
            else:
                detalhe = "arg=0x%02X" % arg
            if not (0x30 <= op <= 0x7E):
                nome = OPCODE_NAMES.get(op, "0x%02X" % op)
                resultado = ("PENDENTE" if res == 0xFF
                             else STATUS_NAMES.get(res, "0x%02X" % res))
            print("%6d  %-20s %-3s  %-28s %s"
                  % (s_, nome, ESTADO_NOMES.get(est, "?"), detalhe,
                     resultado))
            linhas += 1
        if continuar <= seq:
            break
        seq = continuar
    print("(%d registros mostrados; proximo seq = %d)" % (linhas, proximo))
    return 0


def cmd_keycycle(client, args):
    """Gerar -> exportar -> reimportar, com o Python conferindo o C.

    ⚠ PRECISA DA LMK, e isso e o brinquedo aparecendo. Um HSM de verdade
    nunca entrega a chave mestra a ferramenta de host; aqui os
    componentes foram digitados aqui mesmo, entao o host pode
    reconstrui-la por XOR. E a mesma distancia ja registrada na cerimonia.

    O que o teste prova:

      1. o dispositivo gera uma chave que nunca sai em claro
      2. exporta um key block que o PYTHON desembrulha -- duas
         implementacoes independentes concordando sobre blocos DE
         VERDADE, nao sobre um vetor. Cada exportacao do MESMO slot da um
         bloco diferente (enchimento aleatorio), entao esta direcao roda
         quantas vezes se quiser sem gastar slot.
      3. o Python embrulha uma chave que ele escolheu, o dispositivo
         importa, e o KCV que volta e o que o Python calculou. Sem esta
         etapa o acordo seria de mao unica -- o C poderia estar errado do
         mesmo jeito nas duas direcoes.
      4. um bit trocado no bloco tem de ser recusado

    A etapa 3 gastava um slot por iteracao e parava em ~12 quando o key
    store enchia. Desde o DELETE_KEY ela devolve o slot a cada volta e
    chega aos 100.
    """
    try:
        import tr31
    except ImportError:
        print("host/tr31.py nao encontrado", file=sys.stderr)
        return 2

    try:
        lmk = bytes.fromhex(args.lmk)
    except ValueError:
        print("LMK nao e hex valido", file=sys.stderr)
        return 2
    if len(lmk) != LMK_KEY_LEN:
        print("LMK tem %d bytes, esperado %d" % (len(lmk), LMK_KEY_LEN),
              file=sys.stderr)
        return 2

    falhas = 0

    # ---- direcao C -> Python: N blocos de um slot so -------------------
    p = client.command(CMD_GEN_KEY, b"D0ABE")
    h_dev, kcv_dev = p[0], p[1:4]
    print("chave gerada no dispositivo: handle %d, KCV %s"
          % (h_dev, kcv_dev.hex().upper()))

    vistos = set()
    for i in range(args.count):
        bloco = client.command(CMD_EXPORT_KEY, bytes([h_dev])).decode("ascii")
        vistos.add(bloco)
        try:
            chave, cab = tr31.desembrulha(lmk, bloco)
        except tr31.Tr31Erro as e:
            print("%3d  FALHA: o Python nao abriu o bloco do dispositivo: %s"
                  % (i, e))
            falhas += 1
            continue
        if _kcv_local(chave) != kcv_dev:
            print("%3d  FALHA: a chave dentro do bloco nao e a do slot" % i)
            falhas += 1
        if cab["exportabilidade"] != "E" or cab["modo"] != "B":
            print("%3d  FALHA: cabecalho do bloco: %r" % (i, cab))
            falhas += 1

    print("C -> Python : %d blocos abertos, %d distintos"
          % (args.count, len(vistos)))
    if len(vistos) != args.count:
        # Enchimento repetido nao seria erro de correcao -- e seria um
        # vazamento: dois blocos identicos denunciam que a mesma chave foi
        # exportada duas vezes.
        print("  FALHA: houve bloco repetido -- o enchimento nao e aleatorio")
        falhas += 1

    # ---- direcao Python -> C: limitada pelos slots ---------------------
    n_import = 0
    while n_import < args.count:
        nova = os.urandom(LMK_KEY_LEN)
        bloco_py = tr31.embrulha(lmk, nova, uso="D0", modo="B",
                                 exportabilidade="E")
        try:
            q = client.command(CMD_IMPORT_KEY, bloco_py.encode("ascii"))
        except HsmError as e:
            if e.status == 0x23:            # NO_SLOT
                break
            raise
        if q[1:4] != _kcv_local(nova):
            print("%3d  FALHA: importou com KCV %s, esperado %s"
                  % (n_import, q[1:4].hex().upper(),
                     _kcv_local(nova).hex().upper()))
            falhas += 1

        # Um bit trocado tem de ser recusado.
        pos = 5 + (n_import % (len(bloco_py) - 5))
        ruim = (bloco_py[:pos] + chr(ord(bloco_py[pos]) ^ 0x01)
                + bloco_py[pos + 1:])
        try:
            client.command(CMD_IMPORT_KEY, ruim.encode("ascii"))
            print("%3d  FALHA: aceitou bloco com 1 bit trocado (pos %d)"
                  % (n_import, pos))
            falhas += 1
        except HsmError:
            pass

        # Devolve o slot. E o que permite esta direcao chegar aos 100:
        # sem DELETE_KEY ela parava em ~12, porque cada importacao gastava
        # um slot e nao havia como devolve-lo.
        client.command(CMD_DELETE_KEY, bytes([q[0]]))

        n_import += 1

    print("Python -> C : %d blocos importados" % n_import)

    # Devolve tambem o slot da chave que o dispositivo gerou.
    try:
        client.command(CMD_DELETE_KEY, bytes([h_dev]))
    except HsmError:
        pass

    print()
    if falhas:
        print("keycycle: %d falha(s)" % falhas)
        return 1
    print("keycycle: Python e firmware concordam nas duas direcoes")
    if n_import < args.count:
        print("  (a direcao Python -> C parou em %d de %d -- nao deveria,"
              % (n_import, args.count))
        print("   com DELETE_KEY. Investigar.)")
        return 1
    return 0


def _kcv_local(chave):
    """KCV calculado AQUI: AES-ECB da chave sobre um bloco de zeros.

    Independente do dispositivo de proposito -- comparar o KCV do
    dispositivo com o do dispositivo nao prova nada.
    """
    from cryptography.hazmat.primitives.ciphers import Cipher, algorithms, modes
    c = Cipher(algorithms.AES(chave), modes.ECB()).encryptor()
    return (c.update(b"\x00" * 16) + c.finalize())[:3]


def cmd_zeroize(client, args):
    """Apaga TODA chave do dispositivo. Exige dual control.

    Destrutivo e irreversivel: apaga a LMK e os slots da BRAM E da flash
    (fase 4). O log de auditoria fica -- e o registro de quem zeroizou.
    Depois disto, a cerimonia inteira tem de ser refeita.
    """
    print("ZEROIZE apaga a LMK e os 16 slots, na BRAM e na flash. Nao ha volta.")
    if not args.sim:
        resp = input('Digite "apagar" para confirmar: ').strip()
        if resp != "apagar":
            print("cancelado.")
            return 1

    _pede_dual_control("Apagar TODA chave do dispositivo.")

    p = client.command(CMD_ZEROIZE)
    if len(p) != 1:
        print("payload inesperado: %r" % p)
        return 1

    estado = p[0]
    print("apagado. estado: %s (%d)"
          % (STATE_NAMES.get(estado, "?"), estado))
    if estado == 3:
        # TAMPERED e absorvente: apagar a chave nao recupera o dispositivo,
        # e nao deveria. Um HSM que se cura de tamper nao detectou tamper.
        print("  o dispositivo continua em TAMPERED -- de la nao se sai por")
        print("  software. A chave foi embora, que era o pedido.")
    return 0


def cmd_activate(client, args):
    """AUTHORIZED -> OPERATIONAL. Exige dual control.

    Nao ha comando para o caminho inverso. Voltar a UNINITIALIZED e
    trabalho do ZEROIZE, que apaga: um "desativar" que preservasse a LMK
    deixaria o estado mentindo sobre o dispositivo.
    """
    _pede_dual_control("Ativar o dispositivo (AUTHORIZED -> OPERATIONAL).")

    p = client.command(CMD_SET_STATE, bytes([2]))   # HSM_OPERATIONAL
    if len(p) != 1:
        print("payload inesperado: %r" % p)
        return 1
    print("estado : %s (%d)" % (STATE_NAMES.get(p[0], "?"), p[0]))
    return 0


def cmd_raw(client, args):
    payload = bytes.fromhex(args.payload) if args.payload else b""
    status, data = client.transact(args.op, payload)
    print("status : 0x%02X %s" % (status, STATUS_NAMES.get(status, "?")))
    print("payload: %s" % (data.hex() if data else "(vazio)"))
    return 0


def cmd_bench(client, args):
    """Criterio de aceitacao da fase 1 (PLANO.md secao 2):
    10.000 iteracoes sem erro de CRC, cada uma em menos de 50 ms."""
    n = args.count
    limit_ms = args.limit
    times = []
    errors = {}

    print("%d pings, limite de %.0f ms cada..." % (n, limit_ms))
    t_start = time.perf_counter()

    for i in range(n):
        t0 = time.perf_counter()
        try:
            payload = client.command(CMD_PING)
            dt = (time.perf_counter() - t0) * 1000.0
            if payload != b"PONG":
                errors["payload errado"] = errors.get("payload errado", 0) + 1
                continue
            times.append(dt)
        except (ProtocolError, HsmError) as e:
            kind = type(e).__name__
            errors[kind] = errors.get(kind, 0) + 1
            try:
                client.resync()
            except Exception:
                pass

        if (i + 1) % 1000 == 0:
            print("  %d/%d" % (i + 1, n), flush=True)

    total = time.perf_counter() - t_start

    print()
    print("iteracoes  : %d em %.1f s (%.0f/s)" % (n, total, n / total if total else 0))
    print("erros      : %d %s" % (sum(errors.values()), errors if errors else ""))

    if times:
        times.sort()
        print("latencia   : min %.2f  mediana %.2f  p99 %.2f  max %.2f ms"
              % (times[0], times[len(times) // 2],
                 times[int(len(times) * 0.99)], times[-1]))

    over = [t for t in times if t > limit_ms]
    ok = (not errors) and (not over) and len(times) == n

    if over:
        print("ACIMA DO LIMITE: %d iteracoes passaram de %.0f ms" % (len(over), limit_ms))
    if errors:
        print("FALHOU: houve erro de protocolo")
    print()
    print("criterio de aceitacao: %s" % ("OK" if ok else "FALHOU"))
    return 0 if ok else 1


# --------------------------------------------------------------------


def cmd_kcv(args):
    """KCV de componentes e do XOR deles, calculado AQUI, sem placa.

    E a conta que o custodiante faz para conferir o que o dispositivo
    mostra: o KCV de cada componente (o que o lmk-load/comp-load devolve)
    e o da chave montada (o que o lmk-status devolve). Imprime a chave
    montada so com --mostra: e material de chave na tela, e aqui ele so
    existe porque o projeto e um brinquedo.
    """
    comps = []
    for i, h in enumerate(args.componentes):
        try:
            c = bytes.fromhex(h)
        except ValueError:
            print(f"componente {i}: hex invalido", file=sys.stderr)
            return 2
        if len(c) not in (16, 24, 32):
            print(f"componente {i}: {len(c)} bytes; AES pede 16, 24 ou 32",
                  file=sys.stderr)
            return 2
        comps.append(c)
    if len({len(c) for c in comps}) != 1:
        print("componentes de tamanhos diferentes", file=sys.stderr)
        return 2

    chave = bytes(len(comps[0]))
    for i, c in enumerate(comps):
        print(f"KCV do componente {i} : {_kcv_local(c).hex().upper()}")
        chave = bytes(a ^ b for a, b in zip(chave, c))
    if len(comps) > 1:
        print(f"KCV da chave (XOR)  : {_kcv_local(chave).hex().upper()}")
        if args.mostra:
            print(f"chave (XOR)         : {chave.hex().upper()}")
    return 0


def main(argv=None):
    ap = argparse.ArgumentParser(description="CLI do HSM educacional")
    ap.add_argument("-p", "--port", default=None,
                    help="porta serial (padrao: primeira /dev/ttyUSB*)")
    ap.add_argument("-b", "--baud", type=int, default=BAUD_RATE)
    ap.add_argument("-t", "--timeout", type=float, default=TIMEOUT_S)

    sub = ap.add_subparsers(dest="cmd", required=True)
    sub.add_parser("selftest", help="confere o codec sem precisar da placa")
    sub.add_parser("ping")
    p_kcv = sub.add_parser("kcv", help="KCV de componentes e do XOR deles "
                           "(sem placa)")
    p_kcv.add_argument("componentes", nargs="+", help="componentes em hex")
    p_kcv.add_argument("--mostra", action="store_true",
                       help="imprime tambem a chave montada (brinquedo)")
    sub.add_parser("version")
    sub.add_parser("dna")

    p_sha = sub.add_parser("sha256", help="SHA-256 de uma mensagem")
    p_sha.add_argument("data", nargs="?", default="", help="mensagem em hex")

    p_rand = sub.add_parser("random", help="bytes do CTR_DRBG")
    p_rand.add_argument("-n", type=int, default=32, help="quantos bytes")
    p_rand.add_argument("-o", "--out", help="grava num arquivo em vez de imprimir")

    sub.add_parser("post", help="reroda o POST no dispositivo")

    # Cerimonia de LMK -- fase 3. Os dois primeiros exigem dual control.
    sub.add_parser("lmk-status", help="quantos componentes e o KCV da LMK")

    p_lmk = sub.add_parser("lmk-load",
                           help="carrega um componente da LMK (dual control)")
    p_lmk.add_argument("n", type=int, help="indice do componente (0..2)")
    p_lmk.add_argument("key", nargs="?", default=None,
                       help="componente: 32 bytes em hex")
    p_lmk.add_argument("--random", action="store_true",
                       help="gera o componente aqui e imprime (brinquedo)")

    sub.add_parser("activate",
                   help="AUTHORIZED -> OPERATIONAL (dual control)")

    p_gen = sub.add_parser("gen-key", help="gera chave DENTRO do dispositivo")
    _cab_args(p_gen)

    p_exp = sub.add_parser("export-key", help="exporta um slot como key block")
    p_exp.add_argument("handle", type=int)
    p_exp.add_argument("-o", "--out", help="grava o bloco num arquivo")

    p_imp = sub.add_parser("import-key", help="importa um key block")
    p_imp.add_argument("block", nargs="?", default=None, help="o bloco em ASCII")
    p_imp.add_argument("-f", "--file", help="le o bloco de um arquivo")

    p_kinfo = sub.add_parser("key-info", help="metadados de um slot (nunca chave)")
    p_kinfo.add_argument("handle", type=int)

    p_del = sub.add_parser("delete-key", help="apaga UM slot (sem dual control)")
    p_del.add_argument("handle", type=int)

    p_cl = sub.add_parser("comp-load",
                          help="monta chave de trabalho por componentes "
                               "(dual control a cada um)")
    p_cl.add_argument("n", type=int, help="indice do componente (0..total-1)")
    p_cl.add_argument("total", type=int, help="quantos componentes ao todo")
    p_cl.add_argument("key", nargs="?", default=None,
                      help="componente: 32 bytes em hex")
    p_cl.add_argument("--random", action="store_true",
                      help="gera o componente aqui e imprime (brinquedo)")
    _cab_args(p_cl)

    p_mac = sub.add_parser("mac", help="CMAC-AES-256 com a chave de um slot")
    p_mac.add_argument("handle", type=int)
    p_mac.add_argument("data", nargs="?", default="", help="mensagem em hex")

    p_macv = sub.add_parser("mac-verify",
                            help="verifica um MAC DENTRO do dispositivo")
    p_macv.add_argument("handle", type=int)
    p_macv.add_argument("tag", help="16 bytes em hex")
    p_macv.add_argument("data", nargs="?", default="", help="mensagem em hex")

    for nome, ajuda in (("encrypt", "cifra dados com a chave de um slot"),
                        ("decrypt", "decifra dados com a chave de um slot")):
        q = sub.add_parser(nome, help=ajuda + " (AES-CBC, IV explicito)")
        q.add_argument("handle", type=int)
        q.add_argument("iv", help="16 bytes em hex")
        q.add_argument("data", help="multiplo de 16 bytes, em hex")

    p_kc = sub.add_parser("keycycle",
                          help="gerar/exportar/importar, com o Python conferindo")
    p_kc.add_argument("--lmk", required=True,
                      help="a LMK em hex -- so num brinquedo de bancada")
    p_kc.add_argument("-n", "--count", type=int, default=100)
    p_kc.add_argument("-v", "--verbose", action="store_true")

    sub.add_parser("env", help="temperatura, tensoes e alarmes de ambiente")

    p_aud = sub.add_parser("audit", help="le o log de auditoria (fase 4)")
    p_aud.add_argument("--desde", type=int, default=0,
                       help="seq inicial (padrao: o mais antigo guardado)")

    p_zer = sub.add_parser("zeroize",
                           help="APAGA toda chave (dual control, irreversivel)")
    p_zer.add_argument("--sim", action="store_true",
                       help="nao pergunta a confirmacao em texto")

    p_raw = sub.add_parser("raw", help="envia um opcode arbitrario")
    p_raw.add_argument("--op", type=lambda s: int(s, 0), required=True)
    p_raw.add_argument("--payload", default="", help="payload em hex")

    p_bench = sub.add_parser("bench", help="teste de aceitacao: N pings")
    p_bench.add_argument("-n", "--count", type=int, default=10000)
    p_bench.add_argument("--limit", type=float, default=50.0,
                         help="limite por iteracao em ms (padrao 50)")

    args = ap.parse_args(argv)

    if args.cmd == "selftest":
        return selftest()
    if args.cmd == "kcv":
        return cmd_kcv(args)

    port = args.port or default_port()
    if port is None:
        print("nenhuma porta serial encontrada; use --port", file=sys.stderr)
        return 2

    handlers = {
        "ping": cmd_ping,
        "version": cmd_version,
        "dna": cmd_dna,
        "raw": cmd_raw,
        "bench": cmd_bench,
        "sha256": cmd_sha256,
        "random": cmd_random,
        "post": cmd_selftest_dev,
        "lmk-status": cmd_lmk_status,
        "lmk-load": cmd_lmk_load,
        "activate": cmd_activate,
        "gen-key": cmd_gen_key,
        "export-key": cmd_export_key,
        "import-key": cmd_import_key,
        "key-info": cmd_key_info,
        "delete-key": cmd_delete_key,
        "comp-load": cmd_comp_load,
        "mac": cmd_mac,
        "mac-verify": cmd_mac_verify,
        "encrypt": cmd_encrypt,
        "decrypt": cmd_decrypt,
        "keycycle": cmd_keycycle,
        "zeroize": cmd_zeroize,
        "audit": cmd_audit,
        "env": cmd_env,
    }

    try:
        with HsmClient(port, args.baud, args.timeout) as client:
            return handlers[args.cmd](client, args)
    except HsmError as e:
        print("dispositivo recusou: %s" % e, file=sys.stderr)
        if e.status == 0x21:
            print("  Dual control: o 2o e o 5o botao da fileira (o 1o e o",
                  file=sys.stderr)
            print("  reset) precisam estar pressionados no instante em que o",
                  file=sys.stderr)
            print("  comando chega, e cada autorizacao exige um aperto NOVO",
                  file=sys.stderr)
            print("  -- solte os dois antes de apertar de novo.",
                  file=sys.stderr)
        return 1
    except ProtocolError as e:
        print("erro de protocolo: %s" % e, file=sys.stderr)
        return 1
    except OSError as e:
        print("erro de porta serial: %s" % e, file=sys.stderr)
        return 2


if __name__ == "__main__":
    sys.exit(main())
