flavioalsoares/hsm-a7/fw/include/kat_vectors.h

/* fw/include/kat_vectors.h -- GERADO, nao editar
 *
 * Produzido por scripts/mkkat.py a partir de vectors/.
 * Procedencia dos arquivos: vectors/MANIFEST.txt.
 *
 * Editar este arquivo a mao quebra a unica garantia que ele tem:
 * a de que os numeros vieram do NIST e do IETF, e nao da memoria
 * de quem escreveu o codigo.
 */
#ifndef KAT_VECTORS_H
#define KAT_VECTORS_H

#include <stdint.h>

/* ---- AES-256 ECB (NIST CAVP / AESAVS) ---- */
/* ECBGFSbox256.rsp [ENCRYPT] COUNT=0 */
static const uint8_t kat_aes0_key[32] = {
    0x00, 0x00, 0x00, 0x00, 0x00, 0x00, 0x00, 0x00, 0x00, 0x00, 0x00, 0x00,
    0x00, 0x00, 0x00, 0x00, 0x00, 0x00, 0x00, 0x00, 0x00, 0x00, 0x00, 0x00,
    0x00, 0x00, 0x00, 0x00, 0x00, 0x00, 0x00, 0x00,
};
static const uint8_t kat_aes0_in[16] = {
    0x01, 0x47, 0x30, 0xF8, 0x0A, 0xC6, 0x25, 0xFE, 0x84, 0xF0, 0x26, 0xC6,
    0x0B, 0xFD, 0x54, 0x7D,
};
static const uint8_t kat_aes0_out[16] = {
    0x5C, 0x9D, 0x84, 0x4E, 0xD4, 0x6F, 0x98, 0x85, 0x08, 0x5E, 0x5D, 0x6A,
    0x4F, 0x94, 0xC7, 0xD7,
};
#define KAT_AES0_CIFRA 1

/* ECBKeySbox256.rsp [DECRYPT] COUNT=0 */
static const uint8_t kat_aes1_key[32] = {
    0xC4, 0x7B, 0x02, 0x94, 0xDB, 0xBB, 0xEE, 0x0F, 0xEC, 0x47, 0x57, 0xF2,
    0x2F, 0xFE, 0xEE, 0x35, 0x87, 0xCA, 0x47, 0x30, 0xC3, 0xD3, 0x3B, 0x69,
    0x1D, 0xF3, 0x8B, 0xAB, 0x07, 0x6B, 0xC5, 0x58,
};
static const uint8_t kat_aes1_in[16] = {
    0x46, 0xF2, 0xFB, 0x34, 0x2D, 0x6F, 0x0A, 0xB4, 0x77, 0x47, 0x6F, 0xC5,
    0x01, 0x24, 0x2C, 0x5F,
};
static const uint8_t kat_aes1_out[16] = {
    0x00, 0x00, 0x00, 0x00, 0x00, 0x00, 0x00, 0x00, 0x00, 0x00, 0x00, 0x00,
    0x00, 0x00, 0x00, 0x00,
};
#define KAT_AES1_CIFRA 0

#define KAT_AES_N 2

/* ---- SHA-256 (NIST CAVP / SHAVS ShortMsg) ---- */
/* Len = 0 bits */
static const uint8_t kat_sha0_msg[1] = { 0x00 };  /* vazio */
#define KAT_SHA0_LEN 0u
static const uint8_t kat_sha0_md[32] = {
    0xE3, 0xB0, 0xC4, 0x42, 0x98, 0xFC, 0x1C, 0x14, 0x9A, 0xFB, 0xF4, 0xC8,
    0x99, 0x6F, 0xB9, 0x24, 0x27, 0xAE, 0x41, 0xE4, 0x64, 0x9B, 0x93, 0x4C,
    0xA4, 0x95, 0x99, 0x1B, 0x78, 0x52, 0xB8, 0x55,
};

/* Len = 8 bits */
static const uint8_t kat_sha1_msg[1] = {
    0xD3,
};
#define KAT_SHA1_LEN 1u
static const uint8_t kat_sha1_md[32] = {
    0x28, 0x96, 0x9C, 0xDF, 0xA7, 0x4A, 0x12, 0xC8, 0x2F, 0x3B, 0xAD, 0x96,
    0x0B, 0x0B, 0x00, 0x0A, 0xCA, 0x2A, 0xC3, 0x29, 0xDE, 0xEA, 0x5C, 0x23,
    0x28, 0xEB, 0xC6, 0xF2, 0xBA, 0x98, 0x02, 0xC1,
};

#define KAT_SHA_N 2

/* ---- HMAC-SHA-256 (IETF RFC 4231) ---- */
/* Test Case 1: chave 20 bytes, dado 8 bytes */
static const uint8_t kat_hmac0_key[20] = {
    0x0B, 0x0B, 0x0B, 0x0B, 0x0B, 0x0B, 0x0B, 0x0B, 0x0B, 0x0B, 0x0B, 0x0B,
    0x0B, 0x0B, 0x0B, 0x0B, 0x0B, 0x0B, 0x0B, 0x0B,
};
#define KAT_HMAC0_KEYLEN 20u
static const uint8_t kat_hmac0_data[8] = {
    0x48, 0x69, 0x20, 0x54, 0x68, 0x65, 0x72, 0x65,
};
#define KAT_HMAC0_DATALEN 8u
static const uint8_t kat_hmac0_mac[32] = {
    0xB0, 0x34, 0x4C, 0x61, 0xD8, 0xDB, 0x38, 0x53, 0x5C, 0xA8, 0xAF, 0xCE,
    0xAF, 0x0B, 0xF1, 0x2B, 0x88, 0x1D, 0xC2, 0x00, 0xC9, 0x83, 0x3D, 0xA7,
    0x26, 0xE9, 0x37, 0x6C, 0x2E, 0x32, 0xCF, 0xF7,
};

/* Test Case 2: chave 4 bytes, dado 28 bytes */
static const uint8_t kat_hmac1_key[4] = {
    0x4A, 0x65, 0x66, 0x65,
};
#define KAT_HMAC1_KEYLEN 4u
static const uint8_t kat_hmac1_data[28] = {
    0x77, 0x68, 0x61, 0x74, 0x20, 0x64, 0x6F, 0x20, 0x79, 0x61, 0x20, 0x77,
    0x61, 0x6E, 0x74, 0x20, 0x66, 0x6F, 0x72, 0x20, 0x6E, 0x6F, 0x74, 0x68,
    0x69, 0x6E, 0x67, 0x3F,
};
#define KAT_HMAC1_DATALEN 28u
static const uint8_t kat_hmac1_mac[32] = {
    0x5B, 0xDC, 0xC1, 0x46, 0xBF, 0x60, 0x75, 0x4E, 0x6A, 0x04, 0x24, 0x26,
    0x08, 0x95, 0x75, 0xC7, 0x5A, 0x00, 0x3F, 0x08, 0x9D, 0x27, 0x39, 0x83,
    0x9D, 0xEC, 0x58, 0xB9, 0x64, 0xEC, 0x38, 0x43,
};

/* Test Case 6: chave 131 bytes, dado 54 bytes */
static const uint8_t kat_hmac2_key[131] = {
    0xAA, 0xAA, 0xAA, 0xAA, 0xAA, 0xAA, 0xAA, 0xAA, 0xAA, 0xAA, 0xAA, 0xAA,
    0xAA, 0xAA, 0xAA, 0xAA, 0xAA, 0xAA, 0xAA, 0xAA, 0xAA, 0xAA, 0xAA, 0xAA,
    0xAA, 0xAA, 0xAA, 0xAA, 0xAA, 0xAA, 0xAA, 0xAA, 0xAA, 0xAA, 0xAA, 0xAA,
    0xAA, 0xAA, 0xAA, 0xAA, 0xAA, 0xAA, 0xAA, 0xAA, 0xAA, 0xAA, 0xAA, 0xAA,
    0xAA, 0xAA, 0xAA, 0xAA, 0xAA, 0xAA, 0xAA, 0xAA, 0xAA, 0xAA, 0xAA, 0xAA,
    0xAA, 0xAA, 0xAA, 0xAA, 0xAA, 0xAA, 0xAA, 0xAA, 0xAA, 0xAA, 0xAA, 0xAA,
    0xAA, 0xAA, 0xAA, 0xAA, 0xAA, 0xAA, 0xAA, 0xAA, 0xAA, 0xAA, 0xAA, 0xAA,
    0xAA, 0xAA, 0xAA, 0xAA, 0xAA, 0xAA, 0xAA, 0xAA, 0xAA, 0xAA, 0xAA, 0xAA,
    0xAA, 0xAA, 0xAA, 0xAA, 0xAA, 0xAA, 0xAA, 0xAA, 0xAA, 0xAA, 0xAA, 0xAA,
    0xAA, 0xAA, 0xAA, 0xAA, 0xAA, 0xAA, 0xAA, 0xAA, 0xAA, 0xAA, 0xAA, 0xAA,
    0xAA, 0xAA, 0xAA, 0xAA, 0xAA, 0xAA, 0xAA, 0xAA, 0xAA, 0xAA, 0xAA,
};
#define KAT_HMAC2_KEYLEN 131u
static const uint8_t kat_hmac2_data[54] = {
    0x54, 0x65, 0x73, 0x74, 0x20, 0x55, 0x73, 0x69, 0x6E, 0x67, 0x20, 0x4C,
    0x61, 0x72, 0x67, 0x65, 0x72, 0x20, 0x54, 0x68, 0x61, 0x6E, 0x20, 0x42,
    0x6C, 0x6F, 0x63, 0x6B, 0x2D, 0x53, 0x69, 0x7A, 0x65, 0x20, 0x4B, 0x65,
    0x79, 0x20, 0x2D, 0x20, 0x48, 0x61, 0x73, 0x68, 0x20, 0x4B, 0x65, 0x79,
    0x20, 0x46, 0x69, 0x72, 0x73, 0x74,
};
#define KAT_HMAC2_DATALEN 54u
static const uint8_t kat_hmac2_mac[32] = {
    0x60, 0xE4, 0x31, 0x59, 0x1E, 0xE0, 0xB6, 0x7F, 0x0D, 0x8A, 0x26, 0xAA,
    0xCB, 0xF5, 0xB7, 0x7F, 0x8E, 0x0B, 0xC6, 0x21, 0x37, 0x28, 0xC5, 0x14,
    0x05, 0x46, 0x04, 0x0F, 0x0E, 0xE3, 0x7F, 0x54,
};

#define KAT_HMAC_N 3

/* ---- CMAC-AES-256 (NIST CAVP / CMACVS) ----
 *
 * Tres classes, porque o algoritmo tem tres caminhos e um
 * vetor so nao distingue K1 de K2.
 *
 * TAGS TRUNCADAS: o arquivo do CAVS 11.0 nao tem tag de 16
 * bytes. Comparar os primeiros TAGLEN bytes e o que a norma
 * define (SP 800-38B 6.2), mas nao confere o resto da tag. */
/* vazia: Mlen = 0, Tlen = 10 */
static const uint8_t kat_cmac0_key[32] = {
    0xF0, 0xA3, 0xE4, 0xC2, 0x37, 0xD8, 0x67, 0x18, 0xD8, 0x4C, 0x43, 0x18,
    0x5E, 0x70, 0xF9, 0xCE, 0xF0, 0xDC, 0x92, 0xB3, 0x78, 0xE3, 0xE0, 0xDB,
    0x04, 0x6B, 0x06, 0x71, 0x6C, 0xFB, 0x3B, 0x61,
};
static const uint8_t kat_cmac0_msg[1] = { 0x00 };  /* vazio */
#define KAT_CMAC0_MSGLEN 0u
static const uint8_t kat_cmac0_mac[10] = {
    0x38, 0xBA, 0x46, 0x60, 0x2F, 0x34, 0x11, 0xA5, 0x8B, 0x2E,
};
#define KAT_CMAC0_TAGLEN 10u

/* alinhada: Mlen = 16, Tlen = 10 */
static const uint8_t kat_cmac1_key[32] = {
    0x3A, 0x75, 0xA9, 0xD2, 0xBD, 0xB8, 0xC8, 0x04, 0xBA, 0x4A, 0xB4, 0x98,
    0x35, 0x73, 0xA6, 0xB2, 0x53, 0x16, 0x0D, 0xD9, 0x0F, 0x8E, 0xDD, 0xFB,
    0x2F, 0xDC, 0x2A, 0xB1, 0x76, 0x04, 0xF5, 0xC5,
};
static const uint8_t kat_cmac1_msg[16] = {
    0x42, 0xF3, 0x5D, 0x5A, 0xA5, 0x33, 0xA7, 0xA0, 0xA5, 0xF7, 0x4E, 0x14,
    0x4F, 0x2A, 0x5F, 0x20,
};
#define KAT_CMAC1_MSGLEN 16u
static const uint8_t kat_cmac1_mac[10] = {
    0xF1, 0x53, 0x2F, 0x87, 0x32, 0xD9, 0xF5, 0x90, 0x30, 0x07,
};
#define KAT_CMAC1_TAGLEN 10u

/* padding: Mlen = 10, Tlen = 10 */
static const uint8_t kat_cmac2_key[32] = {
    0x71, 0x2E, 0x6C, 0xC3, 0x3D, 0x3D, 0x1F, 0x44, 0x27, 0x76, 0xD5, 0x46,
    0xF4, 0xD5, 0xA2, 0x5B, 0x7D, 0x23, 0x40, 0x2A, 0x5F, 0xD6, 0x5E, 0x6E,
    0xF3, 0x33, 0x3A, 0x42, 0x81, 0xB5, 0x72, 0x9B,
};
static const uint8_t kat_cmac2_msg[10] = {
    0x56, 0xC0, 0x26, 0xB8, 0xA7, 0x19, 0x74, 0xFF, 0x7E, 0xCD,
};
#define KAT_CMAC2_MSGLEN 10u
static const uint8_t kat_cmac2_mac[10] = {
    0xDF, 0x8D, 0xC0, 0x96, 0xF5, 0xB3, 0x85, 0xFA, 0xAF, 0xFA,
};
#define KAT_CMAC2_TAGLEN 10u

#define KAT_CMAC_N 3

/* ---- CTR_DRBG AES-256 use df (NIST CAVP / SP 800-90A) ----
 *
 * Fluxo do teste, e ele NAO e obvio a partir do .rsp:
 *   instantiate(entropia, nonce, personalizacao)
 *   generate(addl1)  -> DESCARTA
 *   generate(addl2)  -> compara com esperado
 *
 * Gerar uma vez so produz outro resultado. */
/* personalizacao=nao, dado adicional=nao */
static const uint8_t kat_drbg0_entropia[32] = {
    0x36, 0x40, 0x19, 0x40, 0xFA, 0x8B, 0x1F, 0xBA, 0x91, 0xA1, 0x66, 0x1F,
    0x21, 0x1D, 0x78, 0xA0, 0xB9, 0x38, 0x9A, 0x74, 0xE5, 0xBC, 0xCF, 0xEC,
    0xE8, 0xD7, 0x66, 0xAF, 0x1A, 0x6D, 0x3B, 0x14,
};
#define KAT_DRBG0_ENTROPIA_N 32u
static const uint8_t kat_drbg0_nonce[16] = {
    0x49, 0x6F, 0x25, 0xB0, 0xF1, 0x30, 0x1B, 0x4F, 0x50, 0x1B, 0xE3, 0x03,
    0x80, 0xA1, 0x37, 0xEB,
};
#define KAT_DRBG0_NONCE_N 16u
static const uint8_t kat_drbg0_pers[1] = { 0x00 };  /* vazio */
#define KAT_DRBG0_PERS_N 0u
static const uint8_t kat_drbg0_addl1[1] = { 0x00 };  /* vazio */
#define KAT_DRBG0_ADDL1_N 0u
static const uint8_t kat_drbg0_addl2[1] = { 0x00 };  /* vazio */
#define KAT_DRBG0_ADDL2_N 0u
static const uint8_t kat_drbg0_esperado[64] = {
    0x58, 0x62, 0xEB, 0x38, 0xBD, 0x55, 0x8D, 0xD9, 0x78, 0xA6, 0x96, 0xE6,
    0xDF, 0x16, 0x47, 0x82, 0xDD, 0xD8, 0x87, 0xE7, 0xE9, 0xA6, 0xC9, 0xF3,
    0xF1, 0xFB, 0xAF, 0xB7, 0x89, 0x41, 0xB5, 0x35, 0xA6, 0x49, 0x12, 0xDF,
    0xD2, 0x24, 0xC6, 0xDC, 0x74, 0x54, 0xE5, 0x25, 0x0B, 0x3D, 0x97, 0x16,
    0x5E, 0x16, 0x26, 0x0C, 0x2F, 0xAF, 0x1C, 0xC7, 0x73, 0x5C, 0xB7, 0x5F,
    0xB4, 0xF0, 0x7E, 0x1D,
};
#define KAT_DRBG0_ESPERADO_N 64u

/* personalizacao=nao, dado adicional=sim */
static const uint8_t kat_drbg1_entropia[32] = {
    0x81, 0x48, 0xD6, 0x5D, 0x86, 0x51, 0x3C, 0xE7, 0xD3, 0x89, 0x23, 0xEC,
    0x2F, 0x26, 0xB9, 0xE7, 0xC6, 0x77, 0xDC, 0xC8, 0x99, 0x7E, 0x32, 0x5B,
    0x73, 0x72, 0x61, 0x9E, 0x75, 0x3E, 0xD9, 0x44,
};
#define KAT_DRBG1_ENTROPIA_N 32u
static const uint8_t kat_drbg1_nonce[16] = {
    0x41, 0xC7, 0x1A, 0x24, 0xD1, 0x7D, 0x97, 0x41, 0x90, 0x98, 0x2B, 0xB7,
    0x51, 0x5C, 0xE7, 0xF5,
};
#define KAT_DRBG1_NONCE_N 16u
static const uint8_t kat_drbg1_pers[1] = { 0x00 };  /* vazio */
#define KAT_DRBG1_PERS_N 0u
static const uint8_t kat_drbg1_addl1[32] = {
    0x55, 0xB4, 0x46, 0x04, 0x6C, 0x2D, 0x14, 0xBD, 0xD0, 0xCD, 0xBA, 0x4B,
    0x71, 0x87, 0x3F, 0xD4, 0x76, 0x26, 0x50, 0x69, 0x5A, 0x11, 0x50, 0x79,
    0x49, 0x46, 0x2D, 0xA8, 0xD9, 0x64, 0xAB, 0x6A,
};
#define KAT_DRBG1_ADDL1_N 32u
static const uint8_t kat_drbg1_addl2[32] = {
    0x91, 0x46, 0x8F, 0x1A, 0x09, 0x7D, 0x99, 0xEE, 0x33, 0x94, 0x62, 0xCA,
    0x91, 0x6C, 0xB4, 0xA1, 0x0F, 0x63, 0xD5, 0x38, 0x50, 0xA4, 0xF1, 0x7F,
    0x59, 0x8E, 0xAC, 0x49, 0x02, 0x99, 0xB0, 0x2E,
};
#define KAT_DRBG1_ADDL2_N 32u
static const uint8_t kat_drbg1_esperado[64] = {
    0x54, 0x60, 0x3D, 0x1A, 0x50, 0x61, 0x32, 0xBB, 0xFA, 0x05, 0xB1, 0x53,
    0xA0, 0x4F, 0x22, 0xA1, 0xD5, 0x16, 0xCC, 0x46, 0x32, 0x3C, 0xEF, 0x15,
    0x11, 0x1A, 0xF2, 0x21, 0xF0, 0x30, 0xF3, 0x8D, 0x68, 0x41, 0xD4, 0x67,
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
    0x33, 0x31, 0x44, 0x41, 0x30, 0x35, 0x46, 0x37, 0x34, 0x32, 0x35, 0x35,
    0x30, 0x39, 0x35, 0x39, 0x33, 0x44, 0x30, 0x33, 0x41, 0x34, 0x35, 0x37,
    0x44, 0x43, 0x33, 0x34,
};
#define KAT_TR31_KB_LEN 112u

#endif /* KAT_VECTORS_H */
