flavioalsoares/hsm-a7/fw/include/keystore.h

/* fw/include/keystore.h -- key store em BRAM
 *
 * FRONTEIRA: dentro, e é o bloco mais sensível do firmware. Aqui moram as
 * chaves em claro.
 *
 * ---------------------------------------------------------------------
 * ONDE AS CHAVES FICAM, E POR QUE ISSO SATISFAZ A REGRA 2
 *
 * Os slots são variáveis estáticas, então vivem na DMEM do NEORV32 — que é
 * inferida em **Block RAM** do FPGA (8 KB, `rtl/soc/neorv32_wrapper.vhd`).
 * A regra 2 do CLAUDE.md diz "chaves só em BRAM": está satisfeita por
 * construção, não por promessa.
 *
 * O que a regra proíbe também está ausente por construção: não há DDR3 no
 * design (XBUS desligado), e não há caminho do firmware para a SPI flash.
 *
 * ---------------------------------------------------------------------
 * O CAMPO QUE MAIS IMPORTA É O QUE NÃO É CHAVE
 *
 * Modelar os campos do header X9.143 **desde o início** não é preparação
 * para depois: é o que faz `exportability` significar alguma coisa. Uma
 * chave marcada `'N'` não pode sair, **por nenhum caminho** — e a única
 * forma de garantir isso é existir um único ponto de saída que consulte o
 * campo.
 *
 * Por isso a API abaixo é assimétrica de propósito:
 *
 *   keystore_usa_aes()      carrega a chave no coprocessador e NÃO a
 *                           devolve. É por onde toda operação passa.
 *
 *   keystore_exporta()      devolve os bytes. É a ÚNICA função que faz
 *                           isso, checa `exportability`, e existe só para
 *                           a camada de key block.
 *
 *   keystore_embrulha_kek() (fase 5) é a segunda saída, e só entrega a
 *                           chave JÁ embrulhada sob uma KEK. Passa pela
 *                           mesma checagem -- a regra mora numa função
 *                           estática, `exportavel()`, e as duas a chamam.
 *
 * Duas portas, uma trancada. Se houvesse um `keystore_get_key()` genérico,
 * a checagem viraria convenção — e convenção é o que se esquece no
 * caminho raro.
 *
 * ---------------------------------------------------------------------
 * ESTADO DO DISPOSITIVO
 *
 * Este módulo **não** consulta a máquina de estados. Quem decide se um
 * comando pode rodar é a tabela de comandos (`fw/src/cmd.c`), com a
 * máscara de estados. Misturar as duas coisas daria dois lugares para
 * verificar a mesma condição, e dois lugares divergem.
 */
#ifndef KEYSTORE_H
#define KEYSTORE_H

#include <stdint.h>

#define KS_N_SLOTS      16u
#define KS_KEY_MAX      32u   /* AES-256, e só */
#define KS_KCV_LEN       3u

/* Handle de slot. ZERO É INVÁLIDO, de propósito: um handle não
 * inicializado, ou um campo de payload esquecido em zero, não pode cair
 * por acidente no slot 0. Os válidos vão de 1 a KS_N_SLOTS. */
typedef uint8_t ks_handle_t;
#define KS_HANDLE_INVALIDO  0u

/* Fase 5: o slot efêmero da porta host. Ver keystore_efemera(). */
#define KS_HANDLE_EFEMERA   ((ks_handle_t)(KS_N_SLOTS + 1u))

/* Campos do header X9.143, em ASCII como na norma.
 *
 * Guardados como os bytes do padrão e não como enum: é o header que vai
 * para o key block, contado no MAC. Converter de enum para ASCII na hora
 * de exportar seria uma tradução a mais para errar. */
#define KS_USO_BDK      "B0"   /* Base Derivation Key   */
#define KS_USO_KEK      "K0"   /* Key Encryption Key    */
#define KS_USO_DADOS    "D0"   /* chave de dados        */
#define KS_USO_MAC      "M0"   /* chave de MAC          */
#define KS_USO_ASSINA   "S0"   /* par assimetrico de assinatura -- fase 7 */

#define KS_ALG_AES      'A'
#define KS_ALG_3DES     'T'    /* aceito no header, NÃO implementado aqui */
#define KS_ALG_RSA      'R'    /* fase 7: só no key block do host, nunca num slot */
#define KS_ALG_EC       'E'    /* fase 7: curva elíptica (P-256), idem */

/* Modo de uso -- X9.143. `uso` diz que tipo de chave é, `modo` diz o que
 * ela pode fazer, e os DOIS restringem: cifrar exige uso D0, MAC exige a
 * família M, e o modo tem de permitir a operação.
 *
 * A separação entre os dois grupos é o que fecha a confusão de tipo: uma
 * chave marcada `'B'` (cifra e decifra) NÃO autentica, e uma marcada
 * `'C'` (MAC) NÃO cifra. Não é convenção — `keystore_usa_aes()` e
 * `keystore_cmac()` consultam os dois campos, cada uma exigindo o seu
 * grupo. */
#define KS_MODO_CIFRA    'E'   /* cifrar                    */
#define KS_MODO_DECIFRA  'D'   /* decifrar                  */
#define KS_MODO_AMBOS    'B'   /* cifrar e decifrar         */
#define KS_MODO_GERA     'G'   /* gerar MAC                 */
#define KS_MODO_VERIFICA 'V'   /* verificar MAC             */
#define KS_MODO_MAC      'C'   /* gerar e verificar MAC     */
#define KS_MODO_NENHUM   'N'   /* nenhuma operação          */
#define KS_MODO_ASSINA   'S'   /* só assinar -- chave RSA   */

#define KS_EXP_SIM      'E'    /* exportável, só em key block (TR-31/TR-34) */
#define KS_EXP_NAO      'N'    /* nunca sai, em hipótese nenhuma */
/* `'S'` ("sensível") é o MAIS PERMISSIVO dos três, e não o mais estrito:
 * além de key block, autoriza formatos legados de exportação (criptograma
 * simétrico, embrulho RSA). Este dispositivo só exporta em key block
 * X9.143, então para ele `'S'` e `'E'` liberam o mesmo caminho, e
 * `keystore_exporta()` recusa apenas `'N'` -- correto. Se um dia existir
 * exportação em formato legado, ela tem de aceitar SÓ `'S'`. Ver
 * `doc/fase3-notas.md` §6a. */
#define KS_EXP_SENSIVEL 'S'    /* exportável também fora de key block */

/* Metadados de um slot -- tudo menos a chave.
 *
 * Existe separado para que consultar um slot NÃO devolva material de
 * chave. `keystore_info()` preenche isto; não há como pedir "o slot
 * inteiro". */
typedef struct {
    uint8_t  em_uso;
    uint8_t  uso[2];
    uint8_t  algoritmo;
    uint8_t  modo;
    uint8_t  exportabilidade;
    uint8_t  key_len;
    uint8_t  kcv[KS_KCV_LEN];
    uint32_t contador_uso;
} ks_info_t;

/* Zeroiza tudo -- slots e LMK. Chamado no boot e pelo comando ZEROIZE.
 *
 * Apaga também a chave expandida do coprocessador: ela é material de
 * chave e vive FORA da DMEM, no fabric. Zeroizar só a memória do
 * firmware deixaria a última chave usada viva no `aes_key_mem`. */
void keystore_init(void);

/* PROVA da zeroização: 1 se não sobrou um byte diferente de zero em
 * nenhuma região de chave -- slots, padding das structs, LMK e KCV.
 *
 * Existe porque "chamei a função de apagar" não é a mesma coisa que
 * "apagou". Um `wipe()` que o compilador tivesse eliminado, um campo novo
 * que ninguém acrescentou ao laço, um slot fora do intervalo: os três
 * falham em silêncio, e os três aparecem aqui.
 *
 * Consulta pura -- não apaga nada. Quem apaga é `keystore_zeroiza_tudo()`. */
int keystore_prova_zeroizacao(void);

/* Apaga e CONFERE. Devolve 0 se, depois de apagar, a prova passou.
 *
 * É por aqui que o comando ZEROIZE passa: um zeroize que reporta sucesso
 * sem ter apagado é pior que um que falha, porque o operador acredita
 * nele e devolve o dispositivo achando que está limpo. */
int keystore_zeroiza_tudo(void);

/* Instala uma chave num slot livre.
 *
 * `chave` é material em claro; o chamador zeroiza a origem. O KCV é
 * calculado aqui e guardado.
 *
 * Devolve o handle, ou KS_HANDLE_INVALIDO se não houver slot livre, se os
 * campos do header forem inválidos, ou se o hardware falhar. */
ks_handle_t keystore_instala(const uint8_t uso[2], uint8_t algoritmo,
                             uint8_t modo, uint8_t exportabilidade,
                             const uint8_t *chave, uint8_t key_len);

/* Apaga um slot. Sobrescreve a chave com barreira; não é só marcar livre.
 * Devolve 0 em sucesso. */
int keystore_apaga(ks_handle_t h);

/* Metadados. NÃO devolve chave. Devolve 0 em sucesso. */
int keystore_info(ks_handle_t h, ks_info_t *out);

/* Quantos slots estão livres.
 *
 * Não é segredo — `KEY_INFO` já permite contar a ocupação handle a
 * handle. Existe para que "não instalou" possa dizer **por quê**: header
 * inválido é erro de quem pediu, store cheio é estado do dispositivo, e
 * juntar os dois num código só deixa o operador sem saber o que fazer.
 *
 * ⚠ Não confundir com "o último slot está ocupado". Os slots são
 * alocados no primeiro livre, então apagar um do meio deixa buraco: o
 * último pode estar ocupado com o store longe de cheio. */
uint8_t keystore_livres(void);

/* Fase 5 -- o slot EFÊMERO da porta host.
 *
 * Na porta host a chave de trabalho não mora no dispositivo: o host a
 * guarda como key block sob a LMK e a manda em cada comando. O handler
 * abre o bloco e instala a chave aqui, num 17º slot que nada lista, conta
 * ou persiste; usa-a pelas funções de sempre com KS_HANDLE_EFEMERA (a
 * checagem de `modo` continua num lugar só); e o despachante chama
 * keystore_efemera_apaga() depois de TODO comando ASCII, em qualquer
 * desfecho. Entre dois comandos não sobra chave de trabalho na BRAM.
 *
 * keystore_exporta() recusa o slot efêmero. Devolve o handle, ou
 * KS_HANDLE_INVALIDO se o cabeçalho for inválido. */
ks_handle_t keystore_efemera(const uint8_t uso[2], uint8_t algoritmo,
                             uint8_t modo, uint8_t exportabilidade,
                             const uint8_t *chave, uint8_t key_len);
void keystore_efemera_apaga(void);

/* Carrega a chave do slot no coprocessador e incrementa o contador de uso.
 *
 * NÃO devolve os bytes -- é por aqui que toda operação criptográfica passa.
 * `precisa_modo` é KS_MODO_CIFRA ou KS_MODO_DECIFRA; a função recusa se o
 * `modo` do slot não permitir, ou se o `uso` não for D0 -- KEK, chave de
 * PIN e BDK não cifram dados, qualquer que seja o modo.
 *
 * Devolve 0 em sucesso. */
int keystore_usa_aes(ks_handle_t h, uint8_t precisa_modo);

/* AES-CBC com dupla execução (fase 6), para o que sai ao host. Carrega a chave
 * e cifra duas vezes, e compara. Devolve 0; -1 se o `modo` ou o `uso` proíbe;
 * -2 se discordou, com `saida` apagada e erro grave marcado; -3 em erro
 * interno. `saida` não pode ser `entrada`. A chave expandida sai apagada.
 *
 * O key block segue em aes_cbc(): o MAC do bloco já reprova um corpo errado. */
#define KS_CONFERE_MAX  256u
int keystore_cbc_confere(ks_handle_t h, uint8_t precisa_modo,
                         const uint8_t iv[16], const uint8_t *entrada,
                         uint8_t *saida, uint32_t n, int cifrar);

/* MAC sob a chave de um slot -- CMAC-AES-256, SP 800-38B.
 *
 * Vive AQUI, e não em `cmd.c`, pelo mesmo motivo de `lmk_deriva_kb()`:
 * `cmac_aes256()` precisa dos bytes da chave, e os bytes não saem deste
 * arquivo. Um handler que calculasse o MAC por conta própria precisaria
 * de `keystore_exporta()` — e aí uma chave marcada `'N'` deixaria de
 * poder ser usada para MAC, ou pior, `exportabilidade` viraria um
 * controle sobre USO, que não é o que ela é.
 *
 * Exige `uso` da família M e `modo` do grupo de MAC: gerar precisa de
 * `'G'` ou `'C'`, verificar de `'V'` ou `'C'`. Uma chave de cifra é recusada —
 * é a mesma separação que `keystore_usa_aes()` aplica do outro lado.
 *
 * Devolve 0 em sucesso. */
int keystore_cmac(ks_handle_t h, const uint8_t *msg, uint32_t msg_n,
                  uint8_t tag[16]);

/* Verificação em TEMPO CONSTANTE, e dentro da fronteira.
 *
 * Devolve 1 se confere, 0 se não, -1 se o slot, o uso ou o modo não
 * permitem.
 *
 * O dispositivo compara e devolve o veredito; ele NÃO devolve o MAC para
 * o host comparar. Comparar MAC com `memcmp` do lado de fora é um canal
 * lateral -- o tempo de retorno conta quantos bytes bateram, e com isso
 * se forja tag byte a byte em 16·256 tentativas em vez de 2^128. Manter
 * a comparação aqui é o que torna o comando de verificar melhor que o de
 * gerar, e não apenas uma conveniência. */
int keystore_cmac_verifica(ks_handle_t h, const uint8_t *msg, uint32_t msg_n,
                           const uint8_t tag[16]);

/* ÚNICO caminho que devolve material de chave.
 *
 * Recusa se `exportabilidade` for KS_EXP_NAO. Existe para a camada de key
 * block (fase 3) e para mais nada. Se aparecer um segundo chamador, a
 * pergunta certa não é "como faço isso funcionar" -- é "por que este código
 * precisa da chave em claro?".
 *
 * Devolve o comprimento em bytes, ou 0 se recusado. */
uint8_t keystore_exporta(ks_handle_t h, uint8_t out[KS_KEY_MAX]);

/* ---------------------------------------------------------------------
 * LMK -- região separada dos slots
 *
 * Separada porque ela não é uma chave como as outras: não tem handle, não
 * é exportável por caminho nenhum, e é ela que protege as demais. Um
 * `keystore_apaga()` que pudesse alcançá-la por índice seria um bug de uma
 * linha com consequência total.
 * ------------------------------------------------------------------- */

/* Quantos componentes formam a LMK.
 *
 * Três é a prática usual, e a razão é operacional, não criptográfica: dois
 * custodiantes não dão margem nenhuma se um faltar no dia, e mais de três
 * transforma a cerimônia em logística. O XOR não fica mais forte com mais
 * partes -- ele já é perfeito com duas. */
#define KS_LMK_N_COMPONENTES  3u

/* ---------------------------------------------------------------------
 * COMPONENTES DE CHAVE DE TRABALHO
 *
 * O mesmo split knowledge da cerimônia de LMK, um nível abaixo: cada
 * custodiante entra com a sua parte, ninguém vê a chave inteira, e o
 * dispositivo a monta por XOR dentro da fronteira.
 *
 * É assim que uma chave combinada entre duas instituições entra num HSM
 * sem que nenhuma das duas a conheça por completo.
 *
 * ⚠ A diferença de DESTINO em relação à LMK é toda:
 *
 *     componentes -> XOR -> chave mestra      fica DENTRO, sem handle
 *     componentes -> XOR -> chave de trabalho vai para um SLOT
 *
 * ⚠ E a diferença em relação ao modelo comercial, que vale registrar: lá
 * o comando devolve a chave **embrulhada sob a LMK**. Aqui ele instala
 * num slot e devolve **handle + KCV**, como o `GEN_KEY` e o
 * `IMPORT_KEY` — quem quiser o key block chama `EXPORT_KEY`. A
 * propriedade que importa é idêntica; o que muda é o formato de saída,
 * e ele segue o modelo deste dispositivo.
 * ------------------------------------------------------------------- */

/* Quantos componentes uma chave de trabalho pode ter. Dois é o mínimo que
 * dá split knowledge; acima de meia dúzia a cerimônia vira logística. */
#define KS_COMP_MIN   2u
#define KS_COMP_MAX   9u

/* Acumula um componente. `n` é o índice (0..total-1) e tem de casar com
 * quantos já entraram — o firmware não confia no host para saber onde
 * está. `n == 0` REINICIA a montagem, que é como se abandona uma
 * cerimônia começada errado.
 *
 * `kcv` recebe o KCV **do componente**, nunca o do acumulado: é o que
 * permite ao custodiante conferir que digitou o dele. Sem isso, uma parte
 * trocada só apareceria no fim, quando já não dá para saber qual.
 *
 * Devolve 0 em sucesso. */
int comp_componente(uint8_t n, uint8_t total, const uint8_t comp[KS_KEY_MAX],
                    uint8_t kcv[KS_KCV_LEN]);

/* Quantos entraram e quantos foram anunciados. */
uint8_t comp_carregados(void);
uint8_t comp_total(void);

/* Instala a chave montada num slot livre e LIMPA o acumulador.
 *
 * Só funciona com a montagem completa. Devolve o handle, ou
 * KS_HANDLE_INVALIDO. Em qualquer desfecho o acumulador é zerado — uma
 * chave montada que ficasse pendurada seria material de chave esperando
 * por um comando que talvez não venha. */
ks_handle_t comp_instala(const uint8_t uso[2], uint8_t algoritmo,
                         uint8_t modo, uint8_t exportabilidade);

/* Acumula um componente por XOR. Split knowledge: cada custodiante carrega
 * o seu e não vê os demais, e nenhum componente isolado revela nada.
 *
 * `n` é o índice do componente (0, 1, 2), só para o firmware saber quantos
 * já entraram. Devolve 0 em sucesso, -1 em erro, e -2 se o último
 * componente deixou a LMK inteira em zeros — nesse caso a cerimônia
 * recomeça do componente 0 (o acumulado é zerado). */
int lmk_componente(uint8_t n, const uint8_t comp[KS_KEY_MAX]);

/* Quantos componentes já entraram. */
uint8_t lmk_componentes_carregados(void);

/* 1 se a LMK está completa (três componentes). */
int lmk_completa(void);

/* KCV da LMK. É o ÚNICO dado derivado dela que sai da fronteira -- e sai
 * porque três bytes não permitem recuperar 256 bits, e porque sem ele o
 * operador não teria como conferir que carregou a chave certa.
 *
 * Devolve 0 em sucesso. */
int lmk_kcv(uint8_t out[KS_KCV_LEN]);

/* Carrega a LMK no coprocessador. Não devolve bytes, como os slots. */
int lmk_usa_aes(void);

/* Deriva as subchaves de key block (KBEK e KBAK) a partir da LMK, **sem
 * devolver a LMK**.
 *
 * É a terceira porta deste módulo, e ela existe justamente para que não
 * seja preciso abrir a primeira. A camada de key block precisa de duas
 * chaves derivadas da chave mestra; se a única forma de obtê-las fosse
 * pedir a LMK, `lmk_exporta()` teria de existir — e a partir daí a
 * promessa "a LMK não sai daqui" vira convenção.
 *
 * O que sai são chaves DERIVADAS por CMAC, e a derivação não é
 * inversível: quem tiver KBEK e KBAK não consegue voltar à LMK. É a
 * mesma assimetria de `keystore_usa_aes()`, num degrau acima.
 *
 * O chamador zeroiza as duas com `wipe()`. Devolve 0 em sucesso. */
int lmk_deriva_kb(uint8_t kbek[KS_KEY_MAX], uint8_t kbak[KS_KEY_MAX]);

/* Zeroiza a LMK e todos os slots -- as chaves derivadas não sobrevivem à
 * chave que as protege. */
void lmk_zeroiza(void);

/* ---------------------------------------------------------------------
 * KEK -- troca de chaves com outra instituição (fase 5)
 *
 * Uma KEK é uma chave de uso 'K0' cujo único serviço é proteger outras
 * chaves em trânsito entre duas instituições que a compartilham. Ela
 * chega como qualquer outra: num key block sob a LMK, no slot efêmero.
 * ------------------------------------------------------------------- */

/* KBEK e KBAK derivadas da KEK do slot `h`, para embrulhar
 * (`precisa_modo` = KS_MODO_CIFRA) ou desembrulhar (KS_MODO_DECIFRA).
 *
 * Mesma porta de lmk_deriva_kb(), um degrau abaixo: o que sai são as
 * subchaves derivadas por CMAC, nunca a KEK. Exige uso 'K0', AES-256, e
 * `modo` 'B' ou o pedido. O chamador zeroiza as duas.
 *
 * Devolve 0; -1 slot inválido; -2 não é KEK; -3 o modo não permite. */
int keystore_kek_deriva(ks_handle_t h, uint8_t precisa_modo,
                        uint8_t kbek[KS_KEY_MAX], uint8_t kbak[KS_KEY_MAX]);

/* Embrulha o slot `h` sob KBEK/KBAK de uma KEK: é EXPORTAR, e passa pela
 * mesma regra de keystore_exporta() -- 'N' é recusado. O bloco sai com o
 * cabeçalho do slot. `saida` recebe até TR31_ASCII_MAX caracteres.
 *
 * Devolve 0; -1 erro; -2 a chave não é exportável. */
int keystore_embrulha_kek(ks_handle_t h, const uint8_t kbek[KS_KEY_MAX],
                          const uint8_t kbak[KS_KEY_MAX],
                          char *saida, uint32_t *saida_n);

/* Embrulha o slot `h` sob a LMK, derivando as subchaves aqui dentro. NÃO
 * é exportar (o bloco só abre neste dispositivo), então não checa
 * `exportabilidade`. É o que o host guarda depois de importar.
 *
 * Devolve 0 em sucesso. */
int keystore_embrulha_lmk(ks_handle_t h, char *saida, uint32_t *saida_n);

/* ---------------------------------------------------------------------
 * KCV -- Key Check Value
 *
 * Três bytes mais significativos de AES-ECB da chave sobre um bloco de
 * zeros. Serve para o operador conferir que carregou a chave certa sem
 * nunca ver a chave.
 *
 * Por que TRÊS bytes, e não mais: é uma troca deliberada. Mais bytes
 * verificam melhor e vazam mais -- o KCV é um oráculo de verificação de
 * chave, e um KCV longo o bastante permitiria busca. Três bytes dão 1 em
 * 16 milhões de colisão, que basta para pegar erro de digitação e não
 * basta para atacar.
 * ------------------------------------------------------------------- */
int keystore_kcv(const uint8_t *chave, uint8_t key_len, uint8_t out[KS_KCV_LEN]);

/* ---------------------------------------------------------------------
 * REGISTRO PERSISTENTE -- fase 4
 *
 * O conteudo que fw/src/persist.c grava na flash: a LMK em claro (a
 * regiao e tratada como memoria segura, decisao de 2026-10-15) e os slots
 * embrulhados sob ela como key blocks X9.143. Ver keystore.c.
 * ------------------------------------------------------------------- */
#define KS_REGISTRO_MAX  (KS_KEY_MAX + KS_KCV_LEN + 1u + \
                          KS_N_SLOTS * (1u + 144u))

/* Monta o corpo do registro em `buf`. Exige LMK completa. Devolve 0 em
 * sucesso; o chamador grava e ZERA o buffer -- ele contem a LMK. */
int keystore_registro_monta(uint8_t *buf, uint32_t max, uint32_t *n);

/* Restaura LMK e slots de um corpo de registro. Tudo ou nada: em falha
 * o key store fica zerado. Devolve 0 em sucesso. */
int keystore_registro_carrega(const uint8_t *buf, uint32_t n);

/* Fase 7 -- a chave RSA privada do comando ASCII em curso.
 *
 * FRONTEIRA: dentro. Os bytes da chave ficam em keystore.c, como os das
 * chaves AES. `_abre` desembrulha um key block sob a LMK: 0 se abriu, -1
 * bloco invalido, -3 bloco valido de outro tipo de chave. `_assina` devolve
 * o mesmo que rsa_crt_assina(). `_apaga` e chamada pelo despachante ASCII
 * no fim de todo comando, via keystore_efemera_apaga(). */
int  keystore_rsa_abre(const char *bloco, uint32_t bloco_n);
int  keystore_rsa_assina(const uint8_t digest[32], uint8_t sig[256]);
void keystore_rsa_apaga(void);

/* Gera um par RSA-2048 e o devolve embrulhado sob a LMK (uso S0, 'R', modo
 * 'S'), com o modulo n. `rascunho` e um buffer de 256 bytes para o teste
 * de consistencia do par. `max` e o espaco em `saida`. Devolve 0, -1 em
 * falha, -2 se o par novo nao passou no teste (erro grave marcado). */
int  keystore_rsa_gera(uint8_t exportabilidade, char *saida, uint32_t max,
                       uint32_t *saida_n, uint8_t n[256], uint8_t rascunho[256]);

/* Fase 7 -- a chave privada de ECDSA P-256 do comando ASCII em curso.
 * Ocupa a mesma area da chave RSA: um comando abre uma ou outra, e
 * keystore_rsa_apaga() apaga as duas. Os retornos sao os das funcoes de
 * RSA: `_abre` 0, -1 ou -3; `_assina`, o de ecdsa_assina(). */
int  keystore_ec_abre(const char *bloco, uint32_t bloco_n);
int  keystore_ec_assina(const uint8_t digest[32], uint8_t sig[64]);

/* Gera um par P-256 e o devolve embrulhado sob a LMK (uso S0, 'E', modo
 * 'S'), com a chave publica Qx || Qy. Devolve 0, -1 em falha, -2 se o par
 * novo nao passou no teste de consistencia (erro grave marcado). */
int  keystore_ec_gera(uint8_t exportabilidade, char *saida, uint32_t max,
                      uint32_t *saida_n, uint8_t q[64]);

#endif /* KEYSTORE_H */
