flavioalsoares/hsm-a7/fw/src/keystore.c

/* fw/src/keystore.c -- key store em BRAM
 *
 * FRONTEIRA: dentro, e é o bloco mais sensível do firmware. Ver o
 * cabeçalho de keystore.h para as decisões de projeto.
 */
#include "keystore.h"
#include "cmac.h"
#include "drbg.h"
#include "aes_modos.h"
#include "hsm_cfs.h"
#include "state.h"
#include "rsa.h"
#include "ecc.h"
#include "tr31.h"
#include "wipe.h"

/* Slot completo -- com a chave. Este tipo NÃO aparece no header: nada fora
 * deste arquivo consegue declarar uma variável que contenha chave. */
typedef struct {
    uint8_t  em_uso;
    uint8_t  uso[2];
    uint8_t  algoritmo;
    uint8_t  modo;
    uint8_t  exportabilidade;
    uint8_t  key_len;
    uint8_t  chave[KS_KEY_MAX];
    uint8_t  kcv[KS_KCV_LEN];
    uint32_t contador_uso;
} slot_t;

/* Estáticos: vivem na DMEM, que é Block RAM. Regra 2 por construção.
 *
 * O ÚLTIMO elemento é o slot EFÊMERO da porta host (fase 5): a chave que
 * chega num key block ASCII mora ali só durante o comando. Fica DENTRO do
 * vetor de propósito -- o `keystore_init()` e a prova de zeroização varrem
 * `sizeof g_slots`, e o cobrem sem ninguém lembrar. Os laços que listam,
 * contam e persistem vão só até KS_N_SLOTS, e não o veem. */
#define EFEMERA  KS_N_SLOTS
static slot_t  g_slots[KS_N_SLOTS + 1u];

static uint8_t g_lmk[KS_KEY_MAX];
static uint8_t g_lmk_comps;      /* quantos componentes entraram */
static uint8_t g_lmk_kcv[KS_KCV_LEN];

/* Montagem de chave de TRABALHO por componentes. Separado da LMK de
 * propósito: são chaves com destinos diferentes, e misturar os dois
 * acumuladores seria um caminho para montar uma na região da outra. */
static uint8_t g_comp[KS_KEY_MAX];

/* Fase 7: a chave RSA privada do comando ASCII em curso. Como o slot
 * efemero, existe so durante um comando: entra do key block do host, assina
 * e e apagada pelo despachante no fim de TODO comando. Nunca vai para a
 * flash, e nunca para um slot -- header_valido() recusa o algoritmo 'R'. */
static uint8_t g_rsa[TR31_RSA_CHAVE];
static uint8_t g_rsa_ok;         /* 0 vazia, ou o algoritmo: 'R' ou 'E'. A
                                  * chave de ECDSA ocupa os 96 primeiros
                                  * bytes da mesma area. */
static uint8_t g_comp_n;         /* quantos entraram  */
static uint8_t g_comp_total;     /* quantos foram anunciados */

/* Uma so fonte de verdade: o host e a tabela de comandos precisam do mesmo
 * numero, e um `3` repetido em dois arquivos e um `4` pela metade esperando
 * acontecer. */
#define LMK_N_COMPONENTES  KS_LMK_N_COMPONENTES

/* ------------------------------------------------------------------ */

int keystore_kcv(const uint8_t *chave, uint8_t key_len, uint8_t out[KS_KCV_LEN])
{
    uint8_t zero[HSM_AES_BLOCK_LEN];
    uint8_t cifrado[HSM_AES_BLOCK_LEN];
    uint8_t i;
    int     r = 0;

    if (key_len != KS_KEY_MAX) {
        return -1;                      /* AES-256, e só */
    }
    for (i = 0u; i < HSM_AES_BLOCK_LEN; i++) {
        zero[i] = 0x00u;
    }

    if (hsm_cfs_aes_key(chave) != 0) {
        r = -1;
    } else if (hsm_cfs_aes_block(zero, cifrado, 1) != 0) {
        r = -1;
    } else {
        for (i = 0u; i < KS_KCV_LEN; i++) {
            out[i] = cifrado[i];
        }
    }

    /* A chave expandida fica no coprocessador depois da operação. Limpar
     * agora, e não "na próxima vez que alguém carregar chave". */
    (void)hsm_cfs_wipe();
    wipe(cifrado, sizeof cifrado);
    if (r != 0) {
        wipe(out, KS_KCV_LEN);
    }
    return r;
}

/* Handle 1..KS_N_SLOTS -> índice 0..KS_N_SLOTS-1, ou -1. O handle do slot
 * efêmero só resolve enquanto ele está ocupado -- isto é, durante um
 * comando da porta host. Fora dele é um slot vazio como outro qualquer. */
static int indice(ks_handle_t h)
{
    if ((h == KS_HANDLE_INVALIDO) || (h > KS_HANDLE_EFEMERA)) {
        return -1;
    }
    if (!g_slots[h - 1u].em_uso) {
        return -1;
    }
    return (int)(h - 1u);
}

static int header_valido(const uint8_t uso[2], uint8_t algoritmo,
                        uint8_t modo, uint8_t exportabilidade)
{
    /* Só AES: o coprocessador não faz 3DES e um slot marcado 'T' seria uma
     * chave que o dispositivo não sabe usar -- pior que recusar, porque
     * pareceria instalada. */
    if (algoritmo != KS_ALG_AES) {
        return 0;
    }
    /* Sete valores, em dois grupos: cifra (E/D/B) e MAC (G/V/C), mais o
     * 'N' que não faz nada. Os grupos não se cruzam, e é isso que fecha a
     * confusão de tipo -- uma chave de cifrar não autentica. */
    if ((modo != KS_MODO_CIFRA) && (modo != KS_MODO_DECIFRA) &&
        (modo != KS_MODO_AMBOS) && (modo != KS_MODO_NENHUM) &&
        (modo != KS_MODO_GERA) && (modo != KS_MODO_VERIFICA) &&
        (modo != KS_MODO_MAC)) {
        return 0;
    }
    if ((exportabilidade != KS_EXP_SIM) && (exportabilidade != KS_EXP_NAO) &&
        (exportabilidade != KS_EXP_SENSIVEL)) {
        return 0;
    }
    /* Uso: dois caracteres imprimíveis. A norma tem uma tabela fechada, mas
     * recusar código desconhecido aqui impediria importar key block válido
     * de outro sistema. Guardar o que veio e deixar a política decidir. */
    if ((uso[0] < 0x20u) || (uso[0] > 0x7Eu) ||
        (uso[1] < 0x20u) || (uso[1] > 0x7Eu)) {
        return 0;
    }
    return 1;
}

/* Apaga TUDO: os 16 slots e a LMK. Unica implementacao de zeroizacao
 * deste modulo -- `lmk_zeroiza()` e o comando ZEROIZE passam por aqui.
 *
 * Varre a area como BYTES CRUS, e nao campo a campo. Duas razoes, e a
 * segunda e a que decide:
 *
 *   1. um campo novo em slot_t entra ja zerado, sem ninguem lembrar;
 *   2. os bytes de PREENCHIMENTO da struct tambem sao apagados -- e e
 *      isso que torna possivel PROVAR a zeroizacao varrendo a regiao byte
 *      a byte. Com padding intocado, a varredura leria lixo indeterminado
 *      e a prova nao valeria nada.
 *
 * `em_uso == 0` e "slot livre", entao tudo zero e um key store vazio e
 * valido: a zeroizacao nao precisa de um passo de "remarcar como livre"
 * que pudesse falhar sozinho. */
void keystore_init(void)
{
    wipe_padrao(g_slots, sizeof g_slots);
    wipe_padrao(g_lmk, sizeof g_lmk);
    wipe_padrao(g_lmk_kcv, sizeof g_lmk_kcv);
    g_lmk_comps = 0u;

    /* O acumulador de componentes também é material de chave: uma
     * montagem interrompida deixaria partes de uma chave de trabalho
     * vivas na BRAM depois de um zeroize. */
    wipe_padrao(g_comp, sizeof g_comp);
    g_comp_n     = 0u;
    g_comp_total = 0u;
    wipe_padrao(g_rsa, sizeof g_rsa);
    g_rsa_ok = 0u;

    /* A chave expandida do coprocessador tambem e material de chave, e
     * fica fora da DMEM. Zeroizar so a DMEM deixaria a ultima chave usada
     * viva no aes_key_mem do fabric. */
    (void)hsm_cfs_wipe();
}

/* PROVA da zeroizacao: 1 se nao sobrou um byte diferente de zero em
 * nenhuma das regioes de chave.
 *
 * ⚠ `volatile` nao e enfeite. Sem ele o compilador pode PROVAR que acabou
 * de zerar esta memoria e dobrar a varredura inteira para `return 1` --
 * e a prova viraria uma constante que passa sempre, inclusive quando a
 * zeroizacao falhou. O `volatile` obriga a leitura a acontecer.
 *
 * Acumula com OR em vez de sair no primeiro byte nao-zero: tempo
 * constante, e aqui isso importa pouco, mas o habito de nao ramificar
 * sobre conteudo de memoria de chave e barato. */
int keystore_prova_zeroizacao(void)
{
    const volatile uint8_t *p;
    uint32_t                i;
    uint8_t                 acc = 0u;

    p = (const volatile uint8_t *)(const void *)g_slots;
    for (i = 0u; i < (uint32_t)sizeof g_slots; i++) {
        acc |= p[i];
    }
    p = (const volatile uint8_t *)(const void *)g_lmk;
    for (i = 0u; i < (uint32_t)sizeof g_lmk; i++) {
        acc |= p[i];
    }
    p = (const volatile uint8_t *)(const void *)g_lmk_kcv;
    for (i = 0u; i < (uint32_t)sizeof g_lmk_kcv; i++) {
        acc |= p[i];
    }
    /* O acumulador de componentes entra na prova pelo mesmo motivo que
     * entra na zeroização: é material de chave. Uma montagem interrompida
     * deixaria partes de uma chave viva, e a varredura não veria. */
    p = (const volatile uint8_t *)(const void *)g_comp;
    for (i = 0u; i < (uint32_t)sizeof g_comp; i++) {
        acc |= p[i];
    }
    p = (const volatile uint8_t *)(const void *)g_rsa;
    for (i = 0u; i < (uint32_t)sizeof g_rsa; i++) {
        acc |= p[i];
    }
    acc |= g_rsa_ok;
    acc |= g_lmk_comps;
    acc |= g_comp_n;
    acc |= g_comp_total;

    return (acc == 0u) ? 1 : 0;
}

int keystore_zeroiza_tudo(void)
{
    keystore_init();
    return keystore_prova_zeroizacao() ? 0 : -1;
}

/* Instala no indice `i` (0..15), que o chamador garante livre. E o miolo
 * de keystore_instala() e da restauracao do registro persistente -- a
 * restauracao precisa devolver cada chave ao MESMO slot, porque o host
 * guarda handles. */
static ks_handle_t instala_em(uint32_t i, const uint8_t uso[2],
                              uint8_t algoritmo, uint8_t modo,
                              uint8_t exportabilidade,
                              const uint8_t *chave, uint8_t key_len)
{
    uint8_t  kcv[KS_KCV_LEN];
    slot_t  *s;

    if ((i > EFEMERA) || g_slots[i].em_uso ||
        (chave == 0) || (key_len != KS_KEY_MAX)) {
        return KS_HANDLE_INVALIDO;
    }
    if (!header_valido(uso, algoritmo, modo, exportabilidade)) {
        return KS_HANDLE_INVALIDO;
    }
    if (keystore_kcv(chave, key_len, kcv) != 0) {
        wipe(kcv, sizeof kcv);
        return KS_HANDLE_INVALIDO;
    }

    s = &g_slots[i];
    for (uint8_t k = 0u; k < key_len; k++) {
        s->chave[k] = chave[k];
    }
    for (uint8_t k = 0u; k < KS_KCV_LEN; k++) {
        s->kcv[k] = kcv[k];
    }
    s->uso[0]          = uso[0];
    s->uso[1]          = uso[1];
    s->algoritmo       = algoritmo;
    s->modo            = modo;
    s->exportabilidade = exportabilidade;
    s->key_len         = key_len;
    s->contador_uso    = 0u;
    s->em_uso          = 1u;

    wipe(kcv, sizeof kcv);
    return (ks_handle_t)(i + 1u);
}

ks_handle_t keystore_instala(const uint8_t uso[2], uint8_t algoritmo,
                             uint8_t modo, uint8_t exportabilidade,
                             const uint8_t *chave, uint8_t key_len)
{
    uint32_t i;

    for (i = 0u; i < KS_N_SLOTS; i++) {
        if (!g_slots[i].em_uso) {
            break;
        }
    }
    if (i == KS_N_SLOTS) {
        return KS_HANDLE_INVALIDO;       /* cheio */
    }
    return instala_em(i, uso, algoritmo, modo, exportabilidade,
                      chave, key_len);
}

int keystore_apaga(ks_handle_t h)
{
    int i = indice(h);
    if (i < 0) {
        return -1;
    }
    /* Sobrescreve a chave com barreira. Marcar `em_uso = 0` e deixar os
     * bytes lá seria teatro: o slot seria reusado e o material anterior
     * estaria em BRAM até alguém escrever por cima. */
    wipe(g_slots[i].chave, KS_KEY_MAX);
    wipe(g_slots[i].kcv, KS_KCV_LEN);
    g_slots[i].em_uso          = 0u;
    g_slots[i].uso[0]          = 0u;
    g_slots[i].uso[1]          = 0u;
    g_slots[i].algoritmo       = 0u;
    g_slots[i].modo            = 0u;
    g_slots[i].exportabilidade = 0u;
    g_slots[i].key_len         = 0u;
    g_slots[i].contador_uso    = 0u;
    return 0;
}

/* Fase 5 -- a chave de UM comando da porta host. Ver keystore.h. */
ks_handle_t keystore_efemera(const uint8_t uso[2], uint8_t algoritmo,
                             uint8_t modo, uint8_t exportabilidade,
                             const uint8_t *chave, uint8_t key_len)
{
    keystore_efemera_apaga();
    return instala_em(EFEMERA, uso, algoritmo, modo, exportabilidade,
                      chave, key_len);
}

void keystore_efemera_apaga(void)
{
    (void)keystore_apaga(KS_HANDLE_EFEMERA);
    keystore_rsa_apaga();
    /* O coprocessador pode ter ficado com a chave expandida. */
    (void)hsm_cfs_wipe();
}

uint8_t keystore_livres(void)
{
    uint32_t i;
    uint8_t  n = 0u;

    for (i = 0u; i < KS_N_SLOTS; i++) {
        if (!g_slots[i].em_uso) {
            n++;
        }
    }
    return n;
}

int keystore_info(ks_handle_t h, ks_info_t *out)
{
    int i = indice(h);
    if ((i < 0) || (out == 0)) {
        return -1;
    }
    out->em_uso          = g_slots[i].em_uso;
    out->uso[0]          = g_slots[i].uso[0];
    out->uso[1]          = g_slots[i].uso[1];
    out->algoritmo       = g_slots[i].algoritmo;
    out->modo            = g_slots[i].modo;
    out->exportabilidade = g_slots[i].exportabilidade;
    out->key_len         = g_slots[i].key_len;
    out->kcv[0]          = g_slots[i].kcv[0];
    out->kcv[1]          = g_slots[i].kcv[1];
    out->kcv[2]          = g_slots[i].kcv[2];
    out->contador_uso    = g_slots[i].contador_uso;
    return 0;
}

/* 1 se o `uso` do slot é o de chave de dados.
 *
 * O `modo` diz o que a chave pode fazer; o `uso` diz o que ela É, e os dois
 * têm de concordar com o serviço pedido. Sem isto uma KEK, uma chave de PIN
 * ou uma BDK de modo 'B' decifrariam "dados" -- que é a confusão de tipo de
 * chave na forma clássica: quem decifra com a chave que protege chaves lê
 * as chaves. Ver doc/fase5-notas.md. */
static int uso_dados(int i)
{
    return (g_slots[i].uso[0] == (uint8_t)KS_USO_DADOS[0]) &&
           (g_slots[i].uso[1] == (uint8_t)KS_USO_DADOS[1]);
}

/* 1 se o `uso` do slot é da família M, chaves de MAC.
 *
 * A família inteira, e não o código exato: decisão do usuário. A norma
 * distingue os M* por algoritmo; aqui só existe CMAC. */
static int uso_mac(int i)
{
    return g_slots[i].uso[0] == (uint8_t)KS_USO_MAC[0];
}

int keystore_usa_aes(ks_handle_t h, uint8_t precisa_modo)
{
    int i = indice(h);
    if (i < 0) {
        return -1;
    }
    if (!uso_dados(i)) {
        return -1;
    }

    /* Separação de uso: uma chave de MAC não cifra, uma chave de cifra não
     * autentica. É a mesma disciplina que o CMAC aplica ao derivar KBEK e
     * KBAK por propósito -- e a falta dela é a origem da família de
     * ataques de confusão de tipo. */
    if (g_slots[i].modo != KS_MODO_AMBOS) {
        if (g_slots[i].modo != precisa_modo) {
            return -1;
        }
    }
    if (g_slots[i].modo == KS_MODO_NENHUM) {
        return -1;
    }

    if (hsm_cfs_aes_key(g_slots[i].chave) != 0) {
        return -1;
    }
    g_slots[i].contador_uso++;
    return 0;
}

/* 1 se o `modo` do slot permite a operacao de MAC pedida.
 *
 * `precisa` e KS_MODO_GERA ou KS_MODO_VERIFICA. 'C' permite as duas; uma
 * chave de cifra nao entra aqui de jeito nenhum, porque nenhum valor do
 * grupo de cifra casa com nenhum do grupo de MAC. */
static int modo_mac_ok(uint8_t modo, uint8_t precisa)
{
    if (modo == KS_MODO_MAC) {
        return 1;
    }
    return (modo == precisa) ? 1 : 0;
}

/* FRONTEIRA: dentro. A segunda cópia é dado em claro de quem decifra, e sai
 * apagada em todo caminho. Ver keystore.h. */
int keystore_cbc_confere(ks_handle_t h, uint8_t precisa_modo,
                         const uint8_t iv[AES_BLOCO], const uint8_t *entrada,
                         uint8_t *saida, uint32_t n, int cifrar)
{
    static uint8_t segunda[KS_CONFERE_MAX];
    int      i = indice(h);
    int      r = 0;
    uint32_t j;
    uint8_t  dif = 0u;

    if ((i < 0) || (n > KS_CONFERE_MAX)) {
        return -3;
    }

    /* A chave é carregada DE NOVO para a segunda execução. Com uma carga só,
     * uma falha na expansão da chave erra as duas do mesmo jeito, e elas
     * concordam: medido na placa. */
    if (keystore_usa_aes(h, precisa_modo) != 0) {
        return -1;
    }
    if (aes_cbc(iv, entrada, saida, n, cifrar) != 0) {
        r = -3;
    } else if (keystore_usa_aes(h, precisa_modo) != 0) {
        r = -3;
    } else if (aes_cbc(iv, entrada, segunda, n, cifrar) != 0) {
        r = -3;
    } else {
        g_slots[i].contador_uso--;    /* um pedido, um uso */
        for (j = 0u; j < n; j++) {
            dif |= (uint8_t)(saida[j] ^ segunda[j]);
        }
        if (dif != 0u) {
            erro_grave_marca();
            r = -2;
        }
    }

    wipe(segunda, sizeof segunda);
    if (r != 0) {
        wipe(saida, n);
    }
    (void)hsm_cfs_wipe();
    return r;
}

int keystore_cmac(ks_handle_t h, const uint8_t *msg, uint32_t msg_n,
                  uint8_t tag[CMAC_TAG_LEN])
{
    int      i = indice(h);
    uint8_t  segunda[CMAC_TAG_LEN];
    uint32_t j;
    uint8_t  dif = 0u;

    if ((i < 0) || (tag == 0)) {
        return -1;
    }
    if (!uso_mac(i) || !modo_mac_ok(g_slots[i].modo, KS_MODO_GERA)) {
        return -1;
    }
    if ((cmac_aes256(g_slots[i].chave, msg, msg_n, tag) != 0) ||
        (cmac_aes256(g_slots[i].chave, msg, msg_n, segunda) != 0)) {
        wipe(tag, CMAC_TAG_LEN);
        wipe(segunda, CMAC_TAG_LEN);
        return -1;
    }
    g_slots[i].contador_uso++;

    /* A chave expandida fica no coprocessador depois do CMAC. Limpar
     * agora, e nao "na proxima vez que alguem carregar chave". */
    (void)hsm_cfs_wipe();

    /* Dupla execucao, fase 6. */
    for (j = 0u; j < CMAC_TAG_LEN; j++) {
        dif |= (uint8_t)(tag[j] ^ segunda[j]);
    }
    wipe(segunda, CMAC_TAG_LEN);
    if (dif != 0u) {
        wipe(tag, CMAC_TAG_LEN);
        erro_grave_marca();
        return -2;
    }
    return 0;
}

int keystore_cmac_verifica(ks_handle_t h, const uint8_t *msg, uint32_t msg_n,
                           const uint8_t tag[CMAC_TAG_LEN])
{
    int i = indice(h);
    int r, r2;

    if ((i < 0) || (tag == 0)) {
        return -1;
    }
    if (!uso_mac(i) || !modo_mac_ok(g_slots[i].modo, KS_MODO_VERIFICA)) {
        return -1;
    }

    /* Tempo constante, e DENTRO da fronteira -- ver keystore.h. */
    r  = cmac_aes256_verifica(g_slots[i].chave, msg, msg_n, tag);
    r2 = cmac_aes256_verifica(g_slots[i].chave, msg, msg_n, tag);
    g_slots[i].contador_uso++;
    (void)hsm_cfs_wipe();

    /* Dupla execucao, fase 6: o veredito e o que uma falha quer inverter. */
    if (r != r2) {
        erro_grave_marca();
        return -2;
    }
    return r;
}

int comp_componente(uint8_t n, uint8_t total, const uint8_t comp[KS_KEY_MAX],
                    uint8_t kcv[KS_KCV_LEN])
{
    uint8_t i;

    if ((comp == 0) || (kcv == 0)) {
        return -1;
    }
    if ((total < KS_COMP_MIN) || (total > KS_COMP_MAX)) {
        return -1;
    }

    if (n == 0u) {
        /* Reinicia. E a unica forma de abandonar uma montagem comecada
         * errado sem precisar de um comando de cancelar -- que seria mais
         * um opcode para a mesma coisa. */
        wipe_padrao(g_comp, sizeof g_comp);
        g_comp_n     = 0u;
        g_comp_total = total;
    } else {
        /* Fora de ordem, ou anunciando um total diferente do que comecou:
         * recusa SEM tocar no acumulado. Um host que erre a sequencia nao
         * pode destruir a cerimonia de quem esta na frente da placa. */
        if ((n != g_comp_n) || (total != g_comp_total)) {
            return -1;
        }
    }

    /* O KCV do COMPONENTE, calculado antes de acumular -- e o que o
     * custodiante confere. */
    if (keystore_kcv(comp, KS_KEY_MAX, kcv) != 0) {
        return -1;
    }

    for (i = 0u; i < KS_KEY_MAX; i++) {
        g_comp[i] ^= comp[i];
    }
    g_comp_n++;
    return 0;
}

uint8_t comp_carregados(void)
{
    return g_comp_n;
}

uint8_t comp_total(void)
{
    return g_comp_total;
}

ks_handle_t comp_instala(const uint8_t uso[2], uint8_t algoritmo,
                         uint8_t modo, uint8_t exportabilidade)
{
    ks_handle_t h = KS_HANDLE_INVALIDO;

    if ((g_comp_total >= KS_COMP_MIN) && (g_comp_n == g_comp_total)) {
        h = keystore_instala(uso, algoritmo, modo, exportabilidade,
                             g_comp, KS_KEY_MAX);
    }

    /* Limpa em QUALQUER desfecho, inclusive na falha. Uma chave montada
     * pendurada seria material de chave esperando por um comando que
     * talvez nao venha -- e o operador que errou o cabecalho refaz a
     * cerimonia, que e o comportamento certo para uma chave que ele nao
     * conseguiu instalar. */
    wipe_padrao(g_comp, sizeof g_comp);
    g_comp_n     = 0u;
    g_comp_total = 0u;
    return h;
}

/* O ponto único onde `exportabilidade` decide. Os dois caminhos de
 * saída -- keystore_exporta() (bytes, para o key block do console) e
 * keystore_embrulha_kek() (já embrulhada, porta host) -- passam por aqui.
 * 'E' e 'S' saem; ver keystore.h sobre por que 'S' não é mais estrito. */
static int exportavel(int i)
{
    return g_slots[i].exportabilidade != KS_EXP_NAO;
}

/* Embrulha o slot `i` sob KBEK/KBAK, com o cabeçalho do próprio slot.
 *
 * FRONTEIRA: dentro. Os bytes da chave vão do slot direto para o
 * tr31_embrulha(); o enchimento é aleatório por norma e sai zerado. Quem
 * decide SE pode embrulhar é o chamador -- esta função só sabe COMO. */
static int embrulha_slot(int i, const uint8_t kbek[KS_KEY_MAX],
                         const uint8_t kbak[KS_KEY_MAX],
                         char *saida, uint32_t *saida_n)
{
    uint8_t    enchimento[TR31_BLOCO];
    tr31_cab_t cab;
    int        r = -1;

    if (drbg_dispositivo_bytes(enchimento, sizeof enchimento) != 0) {
        goto fim;
    }
    cab.uso[0]          = g_slots[i].uso[0];
    cab.uso[1]          = g_slots[i].uso[1];
    cab.algoritmo       = g_slots[i].algoritmo;
    cab.modo            = g_slots[i].modo;
    cab.versao_chave[0] = (uint8_t)'0';
    cab.versao_chave[1] = (uint8_t)'0';
    cab.exportabilidade = g_slots[i].exportabilidade;
    r = tr31_embrulha(kbek, kbak, &cab, g_slots[i].chave,
                      g_slots[i].key_len, enchimento,
                      (uint8_t)sizeof enchimento, saida, saida_n);
fim:
    wipe(enchimento, sizeof enchimento);
    return r;
}

uint8_t keystore_exporta(ks_handle_t h, uint8_t out[KS_KEY_MAX])
{
    int     i = indice(h);
    uint8_t k;

    /* O slot efêmero nunca exporta: a chave dele chegou num key block, e
     * quem o mandou já tem o bloco. */
    if ((i < 0) || (i == EFEMERA) || (out == 0)) {
        return 0u;
    }

    if (!exportavel(i)) {
        return 0u;
    }

    for (k = 0u; k < g_slots[i].key_len; k++) {
        out[k] = g_slots[i].chave[k];
    }
    return g_slots[i].key_len;
}

/* ------------------------------------------------------------------
 * LMK
 * ------------------------------------------------------------------ */

void lmk_zeroiza(void)
{
    /* Apagar a LMK apaga TUDO, e por isso esta funcao e um apelido de
     * `keystore_init()` e nao uma segunda implementacao.
     *
     * As chaves derivadas não sobrevivem à chave que as protege: zeroizar
     * a LMK e deixar os slots guardaria chave que ninguém mais consegue
     * exportar nem reimportar -- e que continua utilizável, que é pior.
     *
     * Duas implementações de zeroização divergiriam no dia em que alguém
     * acrescentasse um campo, e a que ficasse para trás deixaria material
     * vivo sem que nenhum teste notasse. */
    keystore_init();
}

int lmk_componente(uint8_t n, const uint8_t comp[KS_KEY_MAX])
{
    uint8_t i, acc;

    if ((comp == 0) || (n != g_lmk_comps) || (n >= LMK_N_COMPONENTES)) {
        return -1;                       /* fora de ordem, ou já completa */
    }

    /* XOR: nenhum componente isolado revela nada sobre a LMK, e a ordem não
     * importa para o resultado -- mas é exigida aqui para que o firmware
     * saiba quantos entraram sem depender do host dizer. */
    for (i = 0u; i < KS_KEY_MAX; i++) {
        g_lmk[i] ^= comp[i];
    }
    g_lmk_comps++;

    if (g_lmk_comps == LMK_N_COMPONENTES) {
        /* LMK zerada: recusada, e a cerimonia recomeca. Acontece quando o
         * ultimo componente e o XOR dos anteriores -- cada um parece
         * aleatorio, e a soma e zero. Nao ha como saber qual componente
         * estava errado, entao nao ha o que aproveitar do acumulado.
         *
         * Varredura sem saida antecipada: o tempo nao diz onde parou.
         * LMK "fraca" (de baixa entropia) NAO e checada -- decisao de
         * 2026-10-18: a qualidade do componente e responsabilidade do
         * custodiante, como num HSM comercial. */
        acc = 0u;
        for (i = 0u; i < KS_KEY_MAX; i++) {
            acc |= g_lmk[i];
        }
        if (acc == 0u) {
            lmk_zeroiza();
            return -2;
        }
        if (keystore_kcv(g_lmk, KS_KEY_MAX, g_lmk_kcv) != 0) {
            lmk_zeroiza();
            return -1;
        }
    }
    return 0;
}

uint8_t lmk_componentes_carregados(void)
{
    return g_lmk_comps;
}

int lmk_completa(void)
{
    return (g_lmk_comps == LMK_N_COMPONENTES) ? 1 : 0;
}

int lmk_kcv(uint8_t out[KS_KCV_LEN])
{
    uint8_t i;

    if (!lmk_completa()) {
        wipe(out, KS_KCV_LEN);
        return -1;
    }
    for (i = 0u; i < KS_KCV_LEN; i++) {
        out[i] = g_lmk_kcv[i];
    }
    return 0;
}

int lmk_usa_aes(void)
{
    if (!lmk_completa()) {
        return -1;
    }
    return hsm_cfs_aes_key(g_lmk);
}

/* Única função deste arquivo que passa `g_lmk` para fora do arquivo -- e
 * ela passa para uma derivação, não para um chamador. Ver keystore.h. */
int lmk_deriva_kb(uint8_t kbek[KS_KEY_MAX], uint8_t kbak[KS_KEY_MAX])
{
    if (!lmk_completa()) {
        return -1;
    }
    return tr31_deriva(g_lmk, kbek, kbak);
}

/* ------------------------------------------------------------------
 * Chave RSA do comando ASCII (fase 7)
 * ------------------------------------------------------------------ */

void keystore_rsa_apaga(void)
{
    wipe_padrao(g_rsa, sizeof g_rsa);
    g_rsa_ok = 0u;
}

/* Abre na area da chave assimetrica um key block do algoritmo `alg`. */
static int assim_abre(const char *bloco, uint32_t bloco_n, uint8_t alg)
{
    uint8_t    kbek[KS_KEY_MAX], kbak[KS_KEY_MAX];
    tr31_cab_t cab;
    uint16_t   n = 0u;
    int        r = -1;

    keystore_rsa_apaga();
    if (lmk_deriva_kb(kbek, kbak) != 0) {
        goto fim;
    }
    if (tr31_desembrulha_n(kbek, kbak, bloco, bloco_n, &cab,
                           g_rsa, (uint16_t)sizeof g_rsa, &n) != 0) {
        goto fim;
    }
    /* Bloco integro, mas de chave simetrica: e a confusao de tipo, e nao
     * bloco invalido. Vale tambem entre RSA e ECDSA. O tr31.c ja garante
     * que 'R' e 'E' vem com S0, modo 'S' e o tamanho certo. */
    if (cab.algoritmo != alg) {
        r = -3;
        goto fim;
    }
    g_rsa_ok = alg;
    r = 0;
fim:
    wipe(kbek, sizeof kbek);
    wipe(kbak, sizeof kbak);
    if (r != 0) {
        keystore_rsa_apaga();
    }
    return r;
}

int keystore_rsa_abre(const char *bloco, uint32_t bloco_n)
{
    return assim_abre(bloco, bloco_n, (uint8_t)KS_ALG_RSA);
}

int keystore_ec_abre(const char *bloco, uint32_t bloco_n)
{
    return assim_abre(bloco, bloco_n, (uint8_t)KS_ALG_EC);
}

int keystore_rsa_gera(uint8_t exportabilidade, char *saida, uint32_t max,
                      uint32_t *saida_n, uint8_t n[256], uint8_t rascunho[256])
{
    uint8_t    kbek[KS_KEY_MAX], kbak[KS_KEY_MAX];
    uint8_t    enchimento[TR31_BLOCO];
    tr31_cab_t cab;
    int        r = -1;

    keystore_rsa_apaga();
    if ((max < TR31_ASCII_GRANDE) ||
        ((exportabilidade != KS_EXP_SIM) && (exportabilidade != KS_EXP_NAO) &&
         (exportabilidade != KS_EXP_SENSIVEL))) {
        return -1;
    }
    if (rsa_gera(g_rsa, n) != 0) {
        goto fim;
    }
    /* Teste de consistencia do par (FIPS 140-3): assinar com a chave nova
     * -- e rsa_crt_assina() ja verifica com e antes de devolver. Um par que
     * nao assina nao sai do dispositivo. O digest e o que houver no
     * rascunho: qualquer valor serve. */
    r = rsa_crt_assina(g_rsa, rascunho, rascunho);
    if (r != 0) {
        if (r == -2) {
            erro_grave_marca();
        }
        goto fim;
    }
    r = -1;

    cab.uso[0]          = (uint8_t)'S';
    cab.uso[1]          = (uint8_t)'0';
    cab.algoritmo       = (uint8_t)KS_ALG_RSA;
    cab.modo            = (uint8_t)KS_MODO_ASSINA;
    cab.versao_chave[0] = (uint8_t)'0';
    cab.versao_chave[1] = (uint8_t)'0';
    cab.exportabilidade = exportabilidade;
    if ((lmk_deriva_kb(kbek, kbak) != 0) ||
        (drbg_dispositivo_bytes(enchimento, sizeof enchimento) != 0) ||
        (tr31_embrulha_n(kbek, kbak, &cab, g_rsa, (uint16_t)sizeof g_rsa,
                         enchimento, (uint8_t)sizeof enchimento,
                         saida, saida_n) != 0)) {
        goto fim;
    }
    r = 0;
fim:
    wipe(kbek, sizeof kbek);
    wipe(kbak, sizeof kbak);
    wipe(enchimento, sizeof enchimento);
    keystore_rsa_apaga();
    return r;
}

int keystore_rsa_assina(const uint8_t digest[32], uint8_t sig[256])
{
    int r;

    if (g_rsa_ok != (uint8_t)KS_ALG_RSA) {
        return -1;
    }
    /* -2: a assinatura nao passou na verificacao antes de sair. E a mesma
     * politica da dupla execucao da fase 6 -- nada sai, e o erro grave fica
     * marcado ate o proximo boot. A chave nao e apagada. */
    r = rsa_crt_assina(g_rsa, digest, sig);
    if (r == -2) {
        erro_grave_marca();
    }
    return r;
}

int keystore_ec_assina(const uint8_t digest[32], uint8_t sig[64])
{
    int r;

    if (g_rsa_ok != (uint8_t)KS_ALG_EC) {
        return -1;
    }
    /* -2: mesma politica da assinatura RSA. */
    r = ecdsa_assina(g_rsa, digest, sig);
    if (r == -2) {
        erro_grave_marca();
    }
    return r;
}

int keystore_ec_gera(uint8_t exportabilidade, char *saida, uint32_t max,
                     uint32_t *saida_n, uint8_t q[64])
{
    uint8_t    kbek[KS_KEY_MAX], kbak[KS_KEY_MAX];
    uint8_t    enchimento[TR31_BLOCO];
    uint8_t    sig[EC_SIG];
    tr31_cab_t cab;
    uint32_t   i;
    int        r = -1;

    keystore_rsa_apaga();
    if ((max < TR31_ASCII_EC) ||
        ((exportabilidade != KS_EXP_SIM) && (exportabilidade != KS_EXP_NAO) &&
         (exportabilidade != KS_EXP_SENSIVEL))) {
        return -1;
    }
    if (ecdsa_gera(g_rsa) != 0) {
        goto fim;
    }
    /* Teste de consistencia do par (FIPS 140-3): assinar com a chave nova
     * -- e ecdsa_assina() ja verifica com Q antes de devolver. O digest e
     * a propria chave publica: qualquer valor serve. */
    r = ecdsa_assina(g_rsa, &g_rsa[EC_BYTES], sig);
    if (r != 0) {
        if (r == -2) {
            erro_grave_marca();
        }
        goto fim;
    }
    r = -1;

    cab.uso[0]          = (uint8_t)'S';
    cab.uso[1]          = (uint8_t)'0';
    cab.algoritmo       = (uint8_t)KS_ALG_EC;
    cab.modo            = (uint8_t)KS_MODO_ASSINA;
    cab.versao_chave[0] = (uint8_t)'0';
    cab.versao_chave[1] = (uint8_t)'0';
    cab.exportabilidade = exportabilidade;
    if ((lmk_deriva_kb(kbek, kbak) != 0) ||
        (drbg_dispositivo_bytes(enchimento, sizeof enchimento) != 0) ||
        (tr31_embrulha_n(kbek, kbak, &cab, g_rsa, (uint16_t)TR31_EC_CHAVE,
                         enchimento, (uint8_t)sizeof enchimento,
                         saida, saida_n) != 0)) {
        goto fim;
    }
    for (i = 0u; i < EC_PUB; i++) {
        q[i] = g_rsa[EC_BYTES + i];
    }
    r = 0;
fim:
    wipe(kbek, sizeof kbek);
    wipe(kbak, sizeof kbak);
    wipe(enchimento, sizeof enchimento);
    wipe(sig, sizeof sig);
    keystore_rsa_apaga();
    return r;
}

/* ------------------------------------------------------------------
 * KEK -- troca de chaves com outra instituição (fase 5)
 * ------------------------------------------------------------------ */

int keystore_kek_deriva(ks_handle_t h, uint8_t precisa_modo,
                        uint8_t kbek[KS_KEY_MAX], uint8_t kbak[KS_KEY_MAX])
{
    int i = indice(h);

    if ((i < 0) || (kbek == 0) || (kbak == 0)) {
        return -1;
    }
    /* Só uma chave de USO 'K0' protege outra chave. Sem isso, qualquer
     * chave de dados com modo 'B' viraria KEK, e o que foi cifrado como
     * dado poderia ser apresentado como chave -- a confusão de tipo que o
     * key block existe para fechar. AES-256 porque a derivação X9.143
     * deste dispositivo é a da KBPK de 32 bytes, a mesma da LMK. */
    if ((g_slots[i].uso[0] != (uint8_t)'K') ||
        (g_slots[i].uso[1] != (uint8_t)'0') ||
        (g_slots[i].key_len != KS_KEY_MAX)) {
        return -2;
    }
    /* 'E' embrulha (exportar), 'D' desembrulha (importar), 'B' os dois.
     * É a leitura que a norma dá ao `modo` de uma KEK. */
    if ((g_slots[i].modo != KS_MODO_AMBOS) &&
        (g_slots[i].modo != precisa_modo)) {
        return -3;
    }
    g_slots[i].contador_uso++;
    return (tr31_deriva(g_slots[i].chave, kbek, kbak) == 0) ? 0 : -1;
}

int keystore_embrulha_kek(ks_handle_t h, const uint8_t kbek[KS_KEY_MAX],
                          const uint8_t kbak[KS_KEY_MAX],
                          char *saida, uint32_t *saida_n)
{
    int i = indice(h);

    if ((i < 0) || (kbek == 0) || (kbak == 0) || (saida == 0) ||
        (saida_n == 0)) {
        return -1;
    }
    if (!exportavel(i)) {
        return -2;
    }
    return (embrulha_slot(i, kbek, kbak, saida, saida_n) == 0) ? 0 : -1;
}

int keystore_embrulha_lmk(ks_handle_t h, char *saida, uint32_t *saida_n)
{
    uint8_t kbek[KS_KEY_MAX], kbak[KS_KEY_MAX];
    int     i = indice(h);
    int     r = -1;

    if ((i < 0) || (saida == 0) || (saida_n == 0)) {
        return -1;
    }
    /* Sem checar `exportabilidade`: um bloco sob a LMK só abre dentro
     * deste dispositivo, então guardá-lo no banco do host não é exportar
     * -- é o mesmo argumento do K0. Uma chave 'N' recebida de outra
     * instituição precisa poder ser guardada aqui. */
    if (lmk_deriva_kb(kbek, kbak) == 0) {
        r = (embrulha_slot(i, kbek, kbak, saida, saida_n) == 0) ? 0 : -1;
    }
    wipe(kbek, sizeof kbek);
    wipe(kbak, sizeof kbak);
    return r;
}

/* ------------------------------------------------------------------
 * Registro persistente -- fase 4
 *
 * O corpo do registro que fw/src/persist.c grava na flash:
 *
 *   lmk(32) || kcv_lmk(3) || n(1) || n x [ indice(1) || key block(144) ]
 *
 * A LMK vai EM CLARO: a regiao da flash e tratada como memoria segura
 * (decisao de 2026-10-15, CLAUDE.md regra 2). Os slots vao EMBRULHADOS
 * sob ela, como key blocks X9.143 -- e o modelo da categoria: a chave
 * mestra vive na memoria segura, e as chaves de trabalho so existem fora
 * do uso embrulhadas pela chave mestra.
 *
 * Vive aqui porque e o unico arquivo que tem os bytes. persist.c recebe
 * um buffer e o grava, sem saber o que tem dentro.
 *
 * ⚠ `exportabilidade = 'N'` NAO impede a chave de ir para o registro.
 * Ela nao sai da fronteira: a flash, nesta decisao, e dentro. Por isso
 * este caminho NAO passa por keystore_exporta().
 * ------------------------------------------------------------------ */

#define REG_ENTRADA  (1u + TR31_ASCII_MAX)

int keystore_registro_monta(uint8_t *buf, uint32_t max, uint32_t *n)
{
    uint8_t    kbek[KS_KEY_MAX], kbak[KS_KEY_MAX];
    uint32_t   i, pos, kb_n = 0u;
    uint8_t    cont = 0u;
    int        r = -1;

    if ((buf == 0) || (n == 0) || !lmk_completa() ||
        (max < KS_REGISTRO_MAX)) {
        return -1;
    }
    for (i = 0u; i < KS_KEY_MAX; i++) {
        buf[i] = g_lmk[i];
    }
    for (i = 0u; i < KS_KCV_LEN; i++) {
        buf[KS_KEY_MAX + i] = g_lmk_kcv[i];
    }
    pos = KS_KEY_MAX + KS_KCV_LEN + 1u;

    if (lmk_deriva_kb(kbek, kbak) != 0) {
        goto fim;
    }
    for (i = 0u; i < KS_N_SLOTS; i++) {
        if (!g_slots[i].em_uso) {
            continue;
        }
        buf[pos] = (uint8_t)i;
        if ((embrulha_slot((int)i, kbek, kbak, (char *)&buf[pos + 1u],
                           &kb_n) != 0) ||
            (kb_n != TR31_ASCII_MAX)) {
            goto fim;
        }
        pos += REG_ENTRADA;
        cont++;
    }
    buf[KS_KEY_MAX + KS_KCV_LEN] = cont;
    *n = pos;
    r = 0;

fim:
    wipe(kbek, sizeof kbek);
    wipe(kbak, sizeof kbak);
    if (r != 0) {
        wipe(buf, max);
    }
    return r;
}

int keystore_registro_carrega(const uint8_t *buf, uint32_t n)
{
    uint8_t    kbek[KS_KEY_MAX], kbak[KS_KEY_MAX];
    uint8_t    chave[TR31_CHAVE_MAX];
    uint8_t    kcv[KS_KCV_LEN];
    uint8_t    klen = 0u;
    tr31_cab_t cab;
    uint32_t   i, pos, cont;
    int        r = -1;

    keystore_init();

    if ((buf == 0) || (n < KS_KEY_MAX + KS_KCV_LEN + 1u)) {
        return -1;
    }
    cont = buf[KS_KEY_MAX + KS_KCV_LEN];
    if ((cont > KS_N_SLOTS) ||
        (n != KS_KEY_MAX + KS_KCV_LEN + 1u + cont * REG_ENTRADA)) {
        return -1;
    }

    /* A LMK so e aceita se o KCV recalculado bater com o gravado. Nao e
     * defesa contra ataque -- a flash e tratada como segura -- e
     * conferencia de integridade: um bit trocado na LMK mudaria TODAS as
     * chaves que ela protege, e o operador descobriria pelo pior caminho. */
    if (keystore_kcv(buf, KS_KEY_MAX, kcv) != 0) {
        goto fim;
    }
    if ((kcv[0] != buf[KS_KEY_MAX]) || (kcv[1] != buf[KS_KEY_MAX + 1u]) ||
        (kcv[2] != buf[KS_KEY_MAX + 2u])) {
        goto fim;
    }
    for (i = 0u; i < KS_KEY_MAX; i++) {
        g_lmk[i] = buf[i];
    }
    for (i = 0u; i < KS_KCV_LEN; i++) {
        g_lmk_kcv[i] = kcv[i];
    }
    g_lmk_comps = LMK_N_COMPONENTES;

    if (lmk_deriva_kb(kbek, kbak) != 0) {
        goto fim;
    }
    pos = KS_KEY_MAX + KS_KCV_LEN + 1u;
    for (i = 0u; i < cont; i++, pos += REG_ENTRADA) {
        if (buf[pos] >= KS_N_SLOTS) {
            goto fim;                   /* nunca restaurar no slot efemero */
        }
        if (tr31_desembrulha(kbek, kbak, (const char *)&buf[pos + 1u],
                             TR31_ASCII_MAX, &cab, chave, &klen) != 0) {
            goto fim;
        }
        if (instala_em(buf[pos], cab.uso, cab.algoritmo, cab.modo,
                       cab.exportabilidade, chave, klen)
            == KS_HANDLE_INVALIDO) {
            goto fim;
        }
        wipe(chave, sizeof chave);
    }
    r = 0;

fim:
    wipe(kbek, sizeof kbek);
    wipe(kbak, sizeof kbak);
    wipe(chave, sizeof chave);
    wipe(kcv, sizeof kcv);
    if (r != 0) {
        keystore_init();     /* tudo ou nada */
    }
    return r;
}
