flavioalsoares/hsm-a7/rtl/crypto/hsm_cfs.v

// =====================================================================
// hsm_cfs.v -- logica do Custom Functions Subsystem do HSM
//
// Este e o coprocessador criptografico do projeto: AES-256, SHA-256 e o
// DNA_PORT, ligados a CPU por um mapa de registradores.
//
// O CFS e o ponto de extensao PROJETADO do NEORV32 (doc/submodulos.md,
// grau 2 da escada): o upstream entrega um neorv32_cfs.vhd de exemplo
// feito para ser substituido. O build filtra o arquivo dele e compila o
// nosso no lugar, na mesma biblioteca VHDL. O submodulo continua byte a
// byte igual a tag v1.13.3 -- sem patch, sem fork.
//
// Divisao de arquivos:
//   neorv32_cfs.vhd  shim VHDL, so desempacota os records do barramento
//   hsm_cfs.v        este arquivo, onde esta a logica (Verilog-2001,
//                    convencao do projeto para codigo proprio)
//
// ---------------------------------------------------------------------
// FRONTEIRA CRIPTOGRAFICA
//
// Este modulo esta DENTRO da fronteira. Consequencias, e elas nao sao
// decorativas:
//
//   * cfs_out_o (unico fio do CFS que chega ao toplevel) fica em zero.
//     Regra 2 do CLAUDE.md: chave nunca vai para registrador exposto no
//     toplevel. O shim VHDL amarra; aqui nao existe sequer a porta.
//   * A leitura de AES_KEY e dos blocos devolve ZERO. Escrita-somente.
//     Nao e proteger contra a CPU (ela ja escreveu a chave); e nao criar
//     um caminho de leitura que um bug de firmware possa usar por
//     acidente ao varrer o espaco de IO.
//   * Existe CTRL.WIPE, e ele sobrescreve o estado interno dos cores --
//     nao so os registradores visiveis. Ver a secao do wipe.
//
// ---------------------------------------------------------------------
// MAPA DE REGISTRADORES  (base 0xFFEB0000, offsets em bytes)
//
//   0x000  ID        r   0x48534d31 = "HSM1"
//   0x004  STATUS    r   [0] AES_BUSY    [1] AES_VALID
//                        [2] SHA_BUSY    [3] SHA_VALID
//                        [4] DNA_VALID   [5] WIPE_BUSY
//   0x008  CTRL      w   [0] AES_INIT    expande a chave
//                        [1] AES_NEXT    processa um bloco
//                        [2] AES_ENCDEC  1 = cifra, 0 = decifra
//                        [3] SHA_INIT    primeiro bloco da mensagem
//                        [4] SHA_NEXT    bloco seguinte
//                        [5] WIPE        zeroiza (ignora os outros bits)
//
//   0x020..0x03C  AES_KEY[0..7]     w   256 bits, palavra 0 = bits 255:224
//   0x040..0x04C  AES_BLOCK[0..3]   w   128 bits
//   0x050..0x05C  AES_RESULT[0..3]  r   128 bits
//
//   0x080..0x0BC  SHA_BLOCK[0..15]  w   512 bits, ja preenchido
//   0x0C0..0x0DC  SHA_DIGEST[0..7]  r   256 bits
//
//   0x200  RSA_CTRL    w  [0] START  [6:4] DST  [10:8] A  [14:12] B
//                         [23:16] LEN em limbs de 16 bits
//   0x204  RSA_N0P     w  -N^-1 mod 2^16
//   0x208  RSA_STATUS  r  [0] BUSY
//   0x20C  RSA_ADDR    w  janela: [10] modulo, [9:7] registrador, [6:0] limb
//   0x210  RSA_DATA    rw limb na janela; o endereco anda sozinho
//
//   0x100  DNA_LO    r   DNA[31:0]
//   0x104  DNA_HI    r   {7'b0, DNA[56:32]}
//
//   0x110  TRNG_CTRL    w  [0] EN     liga a fonte de ruido
//                          [1] SNAP   congela 1024 amostras BRUTAS
//   0x114  TRNG_STATUS  r  [0] EN          [1] SRC_READY
//                          [2] BYTE_VALID  [3] SNAP_BUSY
//                          [4] SNAP_READY  [5] STARTUP_OK
//                          [6] RCT_FAIL    [7] APT_FAIL
//   0x118  TRNG_BYTE    r  [7:0] byte condicionado; a leitura CONSOME
//   0x11C  TRNG_DIAG    r  {APT_COUNT[15:0], RCT_COUNT[15:0]}
//   0x120  ENV_STATUS   r  [5:0] retido  [13:8] agora  [16] VALID
//   0x124  ENV_TEMP_INT r  {4'b0, TEMP[11:0], 4'b0, VCCINT[11:0]}
//   0x128  ENV_AUX_BRAM r  {4'b0, VCCAUX[11:0], 4'b0, VCCBRAM[11:0]}
//                          sensores de ambiente, ver hsm_xadc.v
//   0x180..0x1FC  TRNG_SNAP[0..31]  r  1024 amostras brutas consecutivas
//                          palavra 0 = as 32 amostras MAIS ANTIGAS
//

// Ordem das palavras: a mais significativa primeiro, como nos vetores do
// NIST. O firmware roda em RISC-V little-endian e portanto PRECISA montar
// cada palavra de 32 bits a partir do vetor de bytes -- ver fw/src/hsm_cfs.c.
// Trocar isso por um memcpy passaria no compilador e falharia em todos os
// KAT, que e o melhor desfecho possivel para esse tipo de erro.
//
// Enderecos nao mapeados: escrita ignorada, leitura devolve zero, ACK
// sempre. Nao dar ACK causaria excecao de bus timeout na CPU.
//
// ---------------------------------------------------------------------
// O QUE ESTE BLOCO NAO FAZ, DE PROPOSITO
//
//   * ECB apenas. O encadeamento de CBC e do firmware -- mesma divisao de
//     responsabilidade dos testbenches de KAT (doc/fase2-notas.md).
//   * Padding do SHA e do firmware. O core recebe blocos de 512 bits
//     prontos.
//   * keylen fixo em AES-256. Nao ha caminho para AES-128: a hierarquia
//     de chaves da fase 3 e toda de 256 bits e um modo mais fraco
//     alcancavel por escrita em registrador e um downgrade de graca.
//   * Sem interrupcao. irq_o fica em zero: o caminho de comando do
//     firmware e sincrono e de passo unico (fw/src/main.c), e um handler
//     de IRQ mexendo nos mesmos buffers de chave e mais dificil de
//     auditar do que uma espera ocupada.
//
// ---------------------------------------------------------------------
// O BIT DE BUSY, E POR QUE ELE NAO E O 'ready' DO CORE
//
// Os cores da secworks sinalizam conclusao com 'ready' alto. Esperar por
// isso logo depois do comando NAO FUNCIONA: o core ainda nao baixou
// 'ready', a espera termina de imediato e le-se o resultado da operacao
// ANTERIOR. Foi exatamente assim que o tb_sha256_kat reprovou -- digests
// corretos, deslocados de um (doc/fase2-notas.md).
//
// La o conserto foi no testbench: esperar COMECAR e depois TERMINAR. Aqui
// o conserto e em hardware, e vale para todo mundo: o CFS mantem um bit de
// BUSY que sobe junto com o comando e so cai depois que o core comecou e
// terminou. O firmware poll um bit e nao tem como errar o handshake.
//
// Corrigir uma armadilha de temporizacao no lugar onde ela some para todos
// os clientes futuros e mais barato do que documenta-la.
// =====================================================================

`timescale 1ns/1ps

module hsm_cfs (
    input  wire        clk_i,
    input  wire        rstn_i,      // reset sincrono, ativo baixo

    // barramento, ja desempacotado pelo shim VHDL
    input  wire [15:0] addr_i,      // endereco de byte dentro do CFS
    input  wire [31:0] wdata_i,
    input  wire        stb_i,       // strobe, um ciclo
    input  wire        rw_i,        // 1 = escrita
    output reg  [31:0] rdata_o,
    output reg         ack_o,

    // Fonte de ruido. Fica em hsm_entropy.vhd porque a celula osciladora
    // que ela reaproveita e uma entidade VHDL do upstream; o shim liga os
    // dois. Ver o cabecalho daquele arquivo.
    output wire        ent_en_o,
    input  wire        ent_raw_i,        // amostra BRUTA, sem condicionar
    input  wire        ent_raw_valid_i,
    input  wire [7:0]  ent_byte_i,       // apos von Neumann
    input  wire        ent_byte_valid_i,

    output wire        irq_o
);

    localparam [31:0] ID_MAGIC = 32'h48534d31;   // "HSM1"

    // Endereco de palavra. 7 bits = 128 palavras = 512 bytes; o resto dos
    // 64 KB do CFS nao tem registrador fisico.
    wire [6:0] waddr = addr_i[8:2];

    // Pagina do RSA, de 0x200 a 0x3FC. Sem separar, ela cairia em cima dos
    // registradores acima, porque waddr ignora o bit 9.
    wire       pg_rsa = addr_i[9];
    wire       stb_b  = stb_i & ~pg_rsa;

    localparam [6:0] A_ID     = 7'h00;   // 0x000
    localparam [6:0] A_STATUS = 7'h01;   // 0x004
    localparam [6:0] A_CTRL   = 7'h02;   // 0x008
    localparam [6:0] A_DNA_LO = 7'h40;   // 0x100
    localparam [6:0] A_DNA_HI = 7'h41;   // 0x104

    localparam [6:0] A_TRNG_CTRL   = 7'h44;   // 0x110
    localparam [6:0] A_TRNG_STATUS = 7'h45;   // 0x114
    localparam [6:0] A_TRNG_BYTE   = 7'h46;   // 0x118
    localparam [6:0] A_TRNG_DIAG   = 7'h47;   // 0x11C
    localparam [6:0] A_ENV_STATUS   = 7'h48;  // 0x120
    localparam [6:0] A_ENV_TEMP_INT = 7'h49;  // 0x124
    localparam [6:0] A_ENV_AUX_BRAM = 7'h4A;  // 0x128
    // TRNG_SNAP: 0x180..0x1FC -> waddr 7'h60..7'h7F, ou seja waddr[6:5]==11.
    // Faixa escolhida por ter prefixo limpo: decodificar por comparacao de
    // intervalo custa comparadores no caminho de leitura e e mais facil de
    // errar em uma palavra so.

    // ------------------------------------------------------------------
    // Registradores de dado
    // ------------------------------------------------------------------
    reg [255:0] aes_key;
    reg [127:0] aes_block;
    reg [511:0] sha_block;
    reg         aes_encdec;

    // pulsos de comando: uma fonte para o barramento, outra para o wipe
    reg  aes_init_bus,  aes_next_bus,  sha_init_bus,  sha_next_bus;
    reg  aes_init_wipe, aes_next_wipe, sha_init_wipe;

    wire aes_init = aes_init_bus | aes_init_wipe;
    wire aes_next = aes_next_bus | aes_next_wipe;
    wire sha_init = sha_init_bus | sha_init_wipe;
    wire sha_next = sha_next_bus;

    // ------------------------------------------------------------------
    // Cores (submodulos externos, fixados por SHA de commit)
    // ------------------------------------------------------------------
    wire         aes_ready;
    wire [127:0] aes_result;
    wire         aes_valid;

    aes_core u_aes (
        .clk          (clk_i),
        .reset_n      (rstn_i),
        .encdec       (aes_encdec),
        .init         (aes_init),
        .next         (aes_next),
        .ready        (aes_ready),
        .key          (aes_key),
        .keylen       (1'b1),          // AES-256, e so
        .block        (aes_block),
        .result       (aes_result),
        .result_valid (aes_valid)
    );

    wire         sha_ready;
    wire [255:0] sha_digest;
    wire         sha_valid;

    sha256_core u_sha (
        .clk          (clk_i),
        .reset_n      (rstn_i),
        .init         (sha_init),
        .next         (sha_next),
        .mode         (1'b1),          // 1 = SHA-256 (0 seria SHA-224)
        .block        (sha_block),
        .ready        (sha_ready),
        .digest       (sha_digest),
        .digest_valid (sha_valid)
    );

    // ------------------------------------------------------------------
    // Bit de BUSY -- ver o cabecalho
    //
    // Sobe com o comando e so cai depois que o core COMECOU (ready caiu) e
    // TERMINOU (ready voltou). O termo aes_init|aes_next no 'active' cobre
    // a janela de um ciclo entre o pulso e o busy registrado -- sem ele,
    // quem consultasse no ciclo seguinte veria "livre" antes da hora.
    // ------------------------------------------------------------------
    reg aes_busy, aes_started;
    reg sha_busy, sha_started;

    wire aes_active = aes_busy | aes_init | aes_next;
    wire sha_active = sha_busy | sha_init | sha_next;

    always @(posedge clk_i) begin
        if (!rstn_i) begin
            aes_busy <= 1'b0;  aes_started <= 1'b0;
            sha_busy <= 1'b0;  sha_started <= 1'b0;
        end else begin
            if (aes_init | aes_next) begin
                aes_busy    <= 1'b1;
                aes_started <= 1'b0;
            end else if (aes_busy) begin
                if (!aes_ready)              aes_started <= 1'b1;
                if (aes_started & aes_ready) aes_busy    <= 1'b0;
            end

            if (sha_init | sha_next) begin
                sha_busy    <= 1'b1;
                sha_started <= 1'b0;
            end else if (sha_busy) begin
                if (!sha_ready)              sha_started <= 1'b1;
                if (sha_started & sha_ready) sha_busy    <= 1'b0;
            end
        end
    end

    // ------------------------------------------------------------------
    // DNA_PORT -- identidade de fabrica, 57 bits
    //
    // O que e: um numero unico gravado em cada die na fabricacao. Serve
    // para o dispositivo dizer QUEM ele e, e e o que o comando GET_DNA
    // devolve.
    //
    // O que NAO e: segredo. O DNA e legivel por JTAG em qualquer placa e
    // nao tem protecao nenhuma. Usa-lo como chave, ou derivar chave dele,
    // e um erro classico -- ver a discussao de PUF no manual. Aqui ele e
    // identificador, nunca material criptografico.
    //
    // Protocolo do primitivo (modelo unisim DNA_PORT.v):
    //   posedge CLK com READ=1  -> carrega o valor, DOUT = bit 56
    //   posedge CLK com SHIFT=1 -> desloca, DOUT = proximo bit (MSB first)
    // Sao portanto 1 leitura + 56 deslocamentos = 57 bits.
    //
    // Roda no mesmo clock de 100 MHz do resto do SoC: um dominio so, sem
    // clock derivado e sem CDC. A leitura acontece uma vez, no reset.
    // ATENCAO REGISTRADA: o limite de frequencia do CLK do DNA_PORT (UG470)
    // nao foi conferido contra o documento oficial neste projeto. Se a
    // leitura vier inconsistente em hardware, o conserto e local -- dividir
    // o clock deste bloco -- e nao afeta mais nada.
    // ------------------------------------------------------------------
    reg [56:0] dna_sr    = 57'd0;
    reg [5:0]  dna_cnt   = 6'd0;
    reg [1:0]  dna_st    = 2'd0;
    reg        dna_read  = 1'b0;
    reg        dna_shift = 1'b0;
    reg        dna_valid = 1'b0;

    wire dna_dout;

    localparam [1:0] D_START = 2'd0, D_LOAD = 2'd1, D_SHIFT = 2'd2, D_DONE = 2'd3;

    DNA_PORT #(
        // Valor arbitrario e reconhecivel, usado APENAS em simulacao. O
        // testbench compara contra ele: se o bit order ou a contagem
        // estiverem errados, o teste reprova.
        .SIM_DNA_VALUE (57'h0123456789ABCDE)
    ) u_dna (
        .DOUT  (dna_dout),
        .CLK   (clk_i),
        .DIN   (1'b0),
        .READ  (dna_read),
        .SHIFT (dna_shift)
    );
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
