flavioalsoares/hsm-a7/(commit log)

2026-07-31 Base do projeto: plano, restricoes e referencias de hardware
    HSM educacional em FPGA Artix-7 XC7A35T (QMTECH). Projeto didatico: o
    objetivo e entender arquitetura de HSM construindo um de brinquedo.
    Nenhuma chave de producao entra aqui.
    Restricoes invioláveis (PLANO.md secao 0), que valem para tudo que vier
    depois:
    - Nada de eFUSE, em nenhuma circunstancia. E OTP: erro vira brick
    permanente. Chave de bitstream so em BBRAM.
    - Chaves em claro so em BRAM -- nunca DDR3, nunca flash sem wrap.
    - Nada atravessa a fronteira criptografica em claro.
    - Simulacao antes de hardware.
    - Nao enfraquecer teste para fazer algo passar.
    Pinagem resolvida com procedencia (doc/pinout.md): os dad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
2026-07-31 Fase 1: SoC NEORV32 com clock, reset, GPIO e debounce
    Infraestrutura confiavel antes de qualquer cripto. Nenhum conceito de HSM
    esta implementado ainda -- isto e o chao sobre o qual eles vao ficar de pe.
    clk_rst_gen.v: MMCM 50->100 MHz (VCO 1000 MHz, meio da faixa do -1).
    Perda de LOCKED reafirma o reset em vez de ser ignorada -- um SoC que
    guarda LMK em BRAM nao pode seguir executando com clock fora de
    especificacao. E a versao minima de um sensor antitamper: e exatamente a
    condicao que a fase 6 vai explorar como ataque de glitch.
    neorv32_wrapper.vhd: lugar unico onde a configuracao do processador esta
    escrita. Num projeto de seguranca a lista do que esta DESLIGADO importa
    mais que a do q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
    [clk_rst_gen.v, debounce.v, hsm_top.v, neorv32_wrapper.vhd, qmtech_a35t.xdc, ro_puf.v, tb_aes_kat.v, tb_clk_rst.v]
2026-07-31 Fase 1: firmware C com o protocolo de comandos
    O parser e a superficie de ataque mais exposta do dispositivo: e o unico
    codigo que processa entrada arbitraria antes de qualquer verificacao. Por
    isso e deliberadamente burro -- maquina de estados explicita, todos os
    limites checados, sem alocacao, sem recursao.
    Protocolo (PLANO.md secao 2):
    pedido LEN(2) | CMD(1) | PAYLOAD | CRC32(4)
    resposta LEN(2) | STATUS(1) | PAYLOAD | CRC32(4)
    Duas decisoes que o plano deixava em aberto e precisavam ser fixadas antes
    de o host existir: o CRC cobre LEN + corpo (incluir o LEN importa, e o
    campo que um atacante usaria para induzir leitura fora do buffer), e o
    polinomio e o IEEE 802.3 refletido,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
    [audit_log.c, audit_log.h, cmd.c, cmd.h, drbg.c, drbg.h, hsm_status.h, kat.c]
2026-07-31 Fase 1: hsmtool.py, e o criterio de aceitacao fechado em hardware
    CLI do host mais o codec do protocolo. O comentario no topo do arquivo e a
    regra que o mantem honesto: tudo aqui esta FORA da fronteira -- so key
    blocks wrapped, KCVs, criptogramas, handles e log. Se algum comando futuro
    fizer material de chave aparecer neste arquivo, o comando esta errado, nao
    o script.
    E aqui que se entende por que a API de um HSM e do jeito que e: e voce que
    precisa impedi-la de vazar. Quando se escreve os dois lados, a tentacao de
    adicionar um "so para depurar, me devolva a chave" fica concreta.
    build_request/parse_response sao funcoes puras, sem porta serial. Isso
    permite testar o protocolo sem hardware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
2026-07-31 Documentacao didatica: como um HSM funciona, e o que cada peca corresponde
    O projeto e didatico -- o objetivo e entender arquitetura de HSM
    construindo um de brinquedo. Faltava a documentacao que explica o assunto,
    nao so o que foi feito.
    doc/arquitetura.md -- os conceitos, de cima para baixo:
    O problema que um HSM resolve (interface de operacoes, nao de acesso, e
    a pergunta que decorre disso: o que a API permite deduzir se for chamada
    um milhao de vezes com entradas escolhidas). A fronteira criptografica e
    por que a UART antes de Ethernet a torna auditavel em vez de afirmada.
    Hierarquia de chaves e por que um HSM com 16 slots guarda uma so.
    Cerimonia de LMK, split knowledge e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
2026-07-31 Manual em PDF: como um HSM funciona, e o que este projeto e
    43 paginas reunindo e expandindo a documentacao. Substitui
    doc/arquitetura.md e doc/fase1-didatico.md, que passavam a ser copias das
    mesmas explicacoes -- tres versoes do mesmo texto divergem, e a fonte
    agora e uma so (doc/manual/, em Markdown).
    Estrutura:
    I O que e um HSM. O problema que resolve -- interface de operacoes,
    nao de acesso -- e a pergunta que decorre disso: o que a API permite
    deduzir se for chamada um milhao de vezes com entradas escolhidas.
    Modelo de ameaca em escada, das tres propriedades (confinamento,
    mediacao, evidencia), e as familias de HSM que existem.
    II Arquitetura int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
2026-07-31 mkpdf: registrar que o PDF nao e byte-reproduzivel
    O Chrome embute data de criacao e identificador, entao regerar sobre a
    mesma fonte produz um arquivo diferente com conteudo identico. Sem a nota,
    o 'git status' sujo depois de rodar o script parece bug.
    Contrasta de proposito com mirror-deps.sh, onde a reprodutibilidade importa
    porque o artefato e uma afirmacao de procedencia.
2026-08-01 Fase 2: cores de cripto verificados contra os vetores do NIST
    Primeiro passo da fase 2, e o que o CLAUDE.md marca como bloqueante: os
    vetores KAT. Nada aqui foi escrito de memoria.
    VETORES (vectors/, versionados)
    aes/ NIST CAVP AESAVS -- AES-256 ECB e CBC, os quatro tipos de vetor
    sha/ NIST CAVP SHAVS -- SHA-256, mensagens curtas e longas
    hmac/ IETF RFC 4231 -- HMAC-SHA-256
    drbg/ NIST CAVP -- CTR_DRBG AES-256 (filtrado do arquivo oficial)
    vectors/MANIFEST.txt registra URL e SHA-256 de cada arquivo baixado E de
    cada arquivo versionado. scripts/fetch-vectors.sh rebaixa, confere hash e
    reextrai -- rodar sobre um repo limpo termina sem nenhuma diferenca. Isso e
    o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
2026-08-01 Documentacao em dia: fase 2 em andamento, e como retomar
    Ponto de parada. Estado registrado nos lugares que a proxima sessao le.
    doc/fase2-notas.md (novo) -- o registro tecnico da fase: vetores e sua
    procedencia, cores fixados por SHA, os quatro tipos de vetor do AESAVS e por
    que nao sao redundantes, a divisao de responsabilidade entre core e chamador
    (ECB/CBC, padding), e o bug de handshake que o proprio teste encontrou.
    Traz tambem a receita pronta do CFS para o proximo passo -- filtrar o
    neorv32_cfs.vhd da lista do build e usar o nosso, sem patch e sem tocar no
    submodulo -- e a entidade a respeitar.
    E uma secao "Retomando o trabalho", porque a placa NAO GUARDA NADA: a
    gravacao foi em R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
2026-08-07 Fase 2: AES, SHA e DNA_PORT como coprocessadores no CFS
    Substitui o neorv32_cfs.vhd do upstream pelo nosso, pela lista de arquivos
    do build -- ponto de extensao projetado, sem patch e sem tocar no submodulo
    (grau 2 da escada do doc/submodulos.md).
    rtl/crypto/neorv32_cfs.vhd shim VHDL: desempacota bus_req_t/bus_rsp_t
    rtl/crypto/hsm_cfs.v mapa de registradores, AES-256, SHA-256,
    DNA_PORT e WIPE
    fw/src/hsm_cfs.c driver
    sim/tb/tb_cfs.v os vetores do NIST atraves do BARRAMENTO
    GET_DNA, ultima sobra da Fase 1, esta fechado. tb_uart_frame cobre a cadeia
    inteira: UART -> parser -> tabela de comandos -> driver -> registrador ->
    pr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
2026-08-07 program.sh: conferir DONE -- uma gravacao que falha nao pode dizer "Pronto"
    O openFPGALoader termina com status 0 mesmo quando a configuracao NAO
    completa. Aconteceu aqui: com o adaptador JTAG e a USB da placa no mesmo
    hub, o bitstream chegou corrompido e o comando disse "Pronto".
    CRC Error CRC error corrompido em transito, nao no arquivo
    Done 0x0 configuracao nao completou
    A sequencia JTAG apaga a memoria de configuracao antes de carregar, entao
    a falha no meio deixou o FPGA EM BRANCO -- menos do que havia antes.
    O sintoma engana: todos os LEDs apagados (sao ativos em nivel baixo, e pino
    sem projeto fica em pull-up) e dispositivo mudo na serial. Parec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
2026-08-07 Bring-up do CFS: gravacao confiavel, e a falha em hardware documentada
    --- program.sh: tres defeitos corrigidos
    1. grep sobre saida com bytes NUL. O openFPGALoader emite NUL na linha de
    frequencia; o grep desta maquina e o ugrep, que classifica entrada com
    NUL como binaria e faz '-q' devolver "nao encontrei" mesmo havendo
    casamento. Resultado: falsos "nenhum FPGA na cadeia JTAG" com o link
    perfeito. Agora tudo passa por 'tr -d "\0"'.
    2. Falso positivo no CRC. A linha e "CRC Error No CRC error" quando esta
    tudo bem, e 'grep -i "CRC error"' casa com o ROTULO -- disparava sempre,
    e chegou a abortar uma gravacao bem-sucedida. O padrao agora ancora no
    valor.
    3. 6 MHz cor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
2026-08-07 CFS validado em hardware: era oxidacao no cabo flat do JTAG
    ping PONG (4,25 ms)
    version v0.1.0, estado UNINITIALIZED
    dna 06CA58966E4285C (57 bits)
    GET_DNA, ultima sobra da Fase 1, fechado EM HARDWARE. E o firmware de
    producao se recusa a subir se o CFS nao devolver o ID certo -- ele subiu,
    entao o coprocessador esta integro ponta a ponta.
    Depois de limpar e lixar os contatos do cabo flat, o link passou a gravar
    a 6 MHz sem erro. Antes: leitura de IDCODE intermitente e CRC Error na
    transferencia de 1,25 MB.
    --- O que enganou, e vale guardar
    Numa tentativa o bitstream gravou com Done 0x1 e No CRC error, e o
    dispositivo ficou mudo. Done = 1 prova que a sequencia de config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
2026-08-07 Corrigir a atribuicao de causa: o hub USB nao era o problema
    O CLAUDE.md tinha virado uma regra ("o JTAG nao pode ficar em hub USB")
    a partir de uma hipotese que nunca foi confirmada e que o desfecho
    contradiz: tirar o JTAG do hub NAO resolveu -- continuou dando cadeia
    vazia. Resolveu limpar a oxidacao do cabo flat.
    A explicacao tambem e tecnicamente fraca. O USB tem CRC e retransmissao
    proprios: hub nao entrega bytes errados em silencio, erra ou fica lento.
    O CRC Error observado e do FPGA, sobre o bitstream recebido -- os bytes
    sairam bons do adaptador e chegaram ruins ao chip, entao a corrupcao e no
    cabo flat, o unico trecho do caminho sem protecao.
    Fica registrado o que continua valendo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
2026-08-08 TRNG com health tests, e um bitstream de diagnostico sem CPU
    Fase 2, item 1. Duas frentes que se cruzaram: a fonte de entropia com os
    health tests da SP 800-90B, e um instrumento de bancada que nasceu porque
    a placa ficou muda e nao havia como saber onde.
    TRNG -- e uma correcao do plano
    -------------------------------
    O PLANO.md dizia "RCT e APT em firmware, sobre a fonte bruta". Nao da. A
    norma exige que os testes CONTINUOS vejam TODA amostra, e a fonte produz
    uma por ciclo de 100 MHz -- a CPU veria uma em cada mil, e um teste que
    amostra esparso nao pega a fonte que travou entre duas leituras.
    Divisao adotada, que preserva a intencao:
    hardware testes continuos, toda amostra (hsm_healt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
2026-08-08 A configuracao por JTAG nao inicializa as Block RAMs -- gravar pela flash
    Causa raiz da placa muda, e ela nao estava em nenhuma das camadas onde eu
    procurei primeiro.
    O sintoma: FPGA configura com Done=1, No CRC error, EOS=1, MMCM travado, e
    a CPU nao executa uma instrucao -- GPIO mudo, UART muda, heartbeat
    piscando. Mesmo bitstream que funcionava no dia anterior.
    Medido com rtl/diag/, que agora testa Block RAM:
    carregado por JTAG ROM 512 de 512 erradas RAM 0 erros mudo
    carregado por flash ROM 0 erros RAM 0 erros responde
    Mesmo bitstream, mesmo dispositivo, mesma sessao. So muda o caminho de
    configuracao. A celula de BRAM esta sadia -- escrita e leitura em tempo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
    [hsm_diag_top.v, hsm_memtest.v, tb_diag.v]
2026-08-08 CTR_DRBG e POST: o dispositivo prova que calcula certo antes de operar
    Fecha o miolo da fase 2. Tudo verificado em hardware, com o bitstream na
    flash.
    CTR_DRBG AES-256 com derivation function -- SP 800-90A 10.2
    -----------------------------------------------------------
    Todas as cifragens passam pelo CFS. NAO ha AES em software neste firmware,
    e isso e deliberado: uma segunda implementacao seria uma segunda chance de
    errar, e ainda por cima uma que roda com a chave na RAM da CPU. O preco e
    que o CFS guarda uma chave expandida por vez, entao alternar entre a chave
    fixa do df e a chave do estado exige recarregar. Correcao antes de
    desempenho, que e o objetivo declarado da fase.
    'use df' e na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
    [cmd.c, cmd.h, drbg.c, drbg.h, hsmtool.py, kat.c, kat.h]
2026-08-09 Fase 3 comeca: CMAC-AES-256, e o que da para ensinar de cripto de pagamento
    CMAC e a peca central da fase 3 e faz duas coisas, com a mesma funcao:
    deriva KBEK e KBAK da LMK POR PROPOSITO, e autentica o key block -- CMAC
    sobre header MAIS corpo. E por isso que um byte trocado no header em ASCII
    invalida o bloco inteiro. Sem isso um atacante edita "exportabilidade: nao"
    para "sim" num blob que nem consegue decifrar.
    Nao e CBC-MAC puro, e a diferenca importa: CBC-MAC com IV zero so e seguro
    para mensagem de tamanho FIXO. Com tamanho variavel, dado MAC(m) da para
    construir uma mensagem de duas partes cujo MAC e previsivel, sem a chave.
    Os subkeys K1 e K2 existem para fechar isso. Um "MAC" casei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
    [cmac.c, cmac.h, hsmtool.py, kat.c, kat.h, kat_vectors.h]
2026-08-09 Manual: capitulo de criptografia de pagamento, sem citar fabricante
    Parte VII nova, 54 paginas no total. Cobre o dominio para o qual o projeto
    passou a apontar:
    34 PIN blocks ISO 9564 -- formatos 0, 1, 3 e 4, e onde cada um e fraco
    35 traducao de PIN -- o comando mais perigoso que existe, e por que
    36 verificacao de PIN -- PVV, IBM 3624, offset, e a decimalizacao
    37 DUKPT -- X9.24-1 (TDES) e X9.24-3 (AES), e as tres propriedades que
    uma chave por transacao compra
    38 o que este projeto pode e nao pode ensinar, com o criterio explicito
    O ataque de tabela de decimalizacao ja estava no capitulo de ataques
    (secao 15.2) e la ficou -- o novo capitulo aponta para ele em vez de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
2026-08-09 Apache-2.0, NOTICE e THIRD-PARTY: o repositorio publico nao tinha licenca
    Achado ao revisar a preocupacao com marcas: o repositorio e publico e nao
    tinha arquivo de licenca nenhum. Sem licenca, o padrao legal e "todos os
    direitos reservados" -- ou seja, ele legalmente NAO era open source e
    ninguem podia usar, copiar ou derivar dele. O oposto do que se pretendia, e
    por omissao.
    Apache-2.0, e o motivo da escolha
    ---------------------------------
    As tres candidatas permissivas (Apache-2.0, BSD-3, MIT) liberam a mesma
    coisa na pratica. A diferenca esta na secao 3 da Apache: CONCESSAO EXPRESSA
    DE PATENTE dos contribuidores, com termino automatico para quem processar o
    projeto por patente. MIT e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
2026-08-09 Notas da fase 3: como retomar, e o que vem primeiro
    O proximo passo e o key store em BRAM, e a estrutura do slot precisa nascer
    com os campos do header X9.143 ja modelados -- refatorar depois e caro, e o
    motivo nao e preguica: 'exportabilidade' so significa alguma coisa se
    NENHUM caminho de codigo puder ignora-la, e caminhos se multiplicam.
    Registrado tambem que cada comando da fase 3 APAGA um da fase 2: AES_ENC,
    AES_DEC e HMAC recebem chave no payload e param sozinhos quando houver LMK,
    pela mascara de estados. Sao substituidos, nao estendidos.
    E o aviso de retomada que mais importa: a placa guarda o bitstream na flash
    e sobe sozinha. Se nao responder, o problema e fisico -- nao regravar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
2026-08-21 Arquivar utilizacao e timing com o TRNG dentro
    Os relatorios em doc/ eram de 6 de agosto, anteriores ao TRNG. O CLAUDE.md
    manda arquivar apos qualquer mudanca de RTL, e o RTL mudou -- hsm_entropy,
    hsm_health e os registradores do TRNG no CFS.
    O custo do TRNG, agora visivel no historico:
    LUT 7035 -> 7392 (33,8% -> 35,5%)
    FF 6235 -> 7475 (15,0% -> 18,0%)
    BRAM 4 -> 5
    WNS +0,487 -> +0,359 ns
    A folga caiu 128 ps. Ainda fecha, mas e o tipo de numero que so serve se
    alguem puder compara-lo com o anterior -- que era exatamente o motivo da
    regra.
2026-08-21 Fechar os dois TBD de bancada: cores dos LEDs e polaridade do 7 segmentos
    Os dois arrastavam desde a fase 1 e viravam caminho critico agora: a fase 3
    mostra o estado no display, e o PLANO pedia LED vermelho para TAMPERED.
    LEDs: os cinco sao vermelhos
    ----------------------------
    O requisito "LED vermelho para TAMPERED" e atendido e ao mesmo tempo
    inutil -- D5 e vermelho, mas todos sao, entao COR NAO CARREGA INFORMACAO
    nesta placa.
    Consequencia de projeto, registrada em doc/pinout.md: um indicador de
    estado tem de se distinguir por POSICAO e por PADRAO. D5 aceso fixo e
    fraco, porque D2 aceso fixo (firmware vivo) e visualmente do mesmo tipo. O
    que distingue sem ambiguidade e piscar, e o cami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
    [hsm_diag_top.v, hsm_top.v, tb_diag.v, tb_hsm_top.v]
2026-08-21 Fechar o ultimo TBD de bancada: ordem fisica dos botoes no silk
    SW2 -> M6 -> btn_a e SW5 -> P6 -> btn_b, verificados em hardware. O mapa
    documentado estava certo; o que faltava era prova.
    Importava mais que os outros dois TBD: o dual control da cerimonia de LMK
    exige dois operadores em botoes distintos, e TROCAR SW2 COM SW5 NAO E
    DETECTAVEL POR SOFTWARE. O dispositivo aceitaria a cerimonia com uma pessoa
    so apertando os dois -- exatamente o que o dual control existe para impedir.
    Como foi medido
    ---------------
    O rtl/diag/ passou a reportar o estado dos dois botoes na mensagem
    periodica (campo Bab, 1 = pressionado), com sincronizador de dois estagios
    porque a entrada e assincrona e mecanic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
2026-08-21 Key store em BRAM: 16 slots, LMK separada, e uma API assimetrica de proposito
    Primeira peca estrutural da fase 3. A partir daqui o dispositivo guarda
    chave, e a decisao que carrega o resto da fase esta na forma da API.
    Onde as chaves ficam
    --------------------
    Slots estaticos vivem na DMEM do NEORV32, que e inferida em Block RAM. A
    regra 2 do CLAUDE.md ("chaves so em BRAM") fica satisfeita POR CONSTRUCAO,
    nao por promessa -- e o que ela proibe tambem esta ausente por construcao:
    nao ha DDR3 no design (XBUS desligado) e nao ha caminho do firmware para a
    SPI flash.
    Duas portas, uma trancada
    -------------------------
    keystore_usa_aes() carrega a chave no coprocessador e NAO a devolve.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
2026-08-21 doc/README: indice de leitura atualizado
    Ficou para tras: 46 paginas (sao 54), sem a Parte VII de criptografia de
    pagamento, e a secao de estado parada na fase 2 com so AES/SHA/DNA no
    coprocessador.
2026-08-21 Documentacao: fase 2 fechada, fase 3 com o key store dentro
    Estado nos quatro documentos que descrevem o projeto para quem chega:
    README.md fases 1 e 2 completas; POST com os sete testes
    CLAUDE.md data corrigida, key store descrito, e os dois avisos
    que um agente precisa ler antes de mexer nele
    PLANO.md key store marcado como implementado na secao 4
    doc/fase3-notas.md cerimonia de LMK como proximo passo, com o que ja
    existe (lmk_componente, lmk_kcv, lmk_zeroiza) separado
    do que falta (o comando e o dual control)
    Os dois avisos no CLAUDE.md existem porque sao as decisoes que um leitor
    apressad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
2026-08-21 Manual: corrigir o que envelheceu, e uma licao que faltava
    O PDF estava mecanicamente atualizado -- mais novo que todas as fontes --
    e mesmo assim afirmava coisas falsas. Ser gerado depois da ultima edicao
    nao e o mesmo que acompanhar o projeto.
    O que estava errado
    -------------------
    O apendice de pinagem listava como PENDENTES as tres coisas fechadas por
    medida nesta bancada: cores dos LEDs, polaridade do display e ordem fisica
    dos botoes. Corrigido, e as duas que mudaram o projeto ficaram escritas:
    - os cinco LEDs sao vermelhos, entao COR NAO DISTINGUE NADA nesta placa.
    O requisito "LED vermelho para TAMPERED" esta atendido e vazio; quem
    carrega informacao de estado e o displa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
2026-08-26 Cerimonia de LMK: tres componentes, dual control, e a regra do aperto novo
    A chave mestra entra em tres componentes que se acumulam por XOR, com KCV
    conferido a cada passo e os dois botoes fisicos autorizando. Fecha os dois
    primeiros criterios de aceitacao da fase 3.
    0x20 LMK_LOAD_COMPONENT so ST_UNINIT dual control
    0x21 LMK_STATUS ST_NORMAL --
    0x26 SET_STATE so ST_AUTH dual control
    A regra do aperto novo
    ----------------------
    Nao basta que os dois botoes estejam pressionados. Entre duas autorizacoes,
    os dois tem de ser vistos SOLTOS.
    Sem isso, fita adesiva sobre os dois -- ou um jumper, ou um contato que
    colou -- carregaria a LMK inteira sozinha,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
2026-08-26 Botoes de dual control: identificar por posicao, e um "quase verdadeiro" a menos
    O hsmtool mandava "SEGURE SW2 e SW5". O operador nao tem como saber quais
    sao: silkscreen minusculo, no meio de uma cerimonia, e um rotulo que o
    proprio projeto marcava como nao conferido.
    A afirmacao que estava errada
    -----------------------------
    O manual e o doc/pinout.md diziam que SW2 e SW5 sao "os extremos da
    fileira". Nao sao. Os extremos sao SW1 e SW5, e SW1 E O RESET.
    Sao o par mais afastado DISPONIVEL -- tres posicoes de distancia numa
    fileira de cinco. O criterio (dificultar apertar os dois com uma mao so)
    continua valendo; a justificativa e que era falsa.
    Era plausivel, era quase verdadeira, e nin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
    [hsmtool.py]
2026-08-26 Display de estado: a placa passa a dizer onde esta, e quais botoes sao
    Tres digitos multiplexados soletram Uni / Aut / OPE / tPr, e o ponto decimal
    acende enquanto o dual control esta satisfeito.
    Nasceu de uma pergunta de bancada, nao de um item de plano
    --------------------------------------------------------
    "...que botoes? Nao tem identificacao de botoes para o operador."
    O hsmtool mandava segurar SW2 e SW5 e o operador nao tinha como identifica-los.
    Descrever por posicao (commit anterior) resolveu metade. A outra metade e o
    dispositivo responder por si -- e o display estava ocioso desde a fase 1, com
    a pinagem verificada e nada para exibir.
    Agora: aperta os dois botoes, o ponto decima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
    [dualctl.c, dualctl.h, hsm_top.v, main.c, seg_display.v, tb_hsm_top.v, tb_seg.v]
2026-08-26 Display validado em hardware: a unica corrente que a simulacao nao fecha
    Mostra Uni na ordem certa e o ponto decimal responde aos botoes.
    Confirma o DIGITO0_A_ESQUERDA no bitstream de PRODUCAO, e nao so no de
    diagnostico onde a ordem foi medida com o "123". Os dois caminhos concordam.
    O que a confirmacao fecha nao e o display
    -----------------------------------------
    E a unica corrente do projeto que nenhum testbench percorre inteira:
    dualctl_pronto() -> gpio_out[6] -> dual_ok_i -> segmento dp
    ^ |
    | v
    os dois botoes fisicos <---- o dedo <---- o o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
2026-08-29 Botoes de reserva: nomear a reserva, e apagar duas afirmacoes velhas
    Sobram dois botoes na placa filha, SW3=N6 e SW4=R5. Ja estavam no XDC
    como "livres" -- agora estao nomeados como RESERVA, com o uso candidato
    (um ZEROIZE de painel na fase 3, o unico comando cujo sentido e nao
    depender do host) e com a ressalva que faltava: os pinos deles vem do
    ESQUEMATICO e nunca foram medidos.
    O [HW] de 2026-08-21 cobre SW2 e SW5, e so. Assumir a ordem do silk foi
    exatamente o erro que custou uma sessao de bancada naquele par, e o
    XDC nao dizia isso em lugar nenhum.
    Duas afirmacoes envelhecidas no XDC, corrigidas ha dias em doc/pinout.md
    e no manual mas nunca aqui:
    - "SW2 e SW5 sao os extremos da fi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
    [qmtech_a35t.xdc]
2026-08-29 Key block X9.143: o formato escrito duas vezes, para as duas discordarem
    O coracao da fase 3. A partir daqui o dispositivo sabe deixar chave SAIR
    sem que ela vaze, que e um problema diferente de guarda-la e mais dificil.
    fw/src/tr31.c em C, dentro da fronteira, sobre o coprocessador
    host/tr31.py em Python, sobre `cryptography`
    A biblioteca diferente e o ponto, nao um detalhe: se as duas
    compartilhassem o AES, concordariam sobre um erro no AES sem nunca
    discordar. Escritas para DISCORDAR, e a menor divergencia de leitura da
    norma aparece como MAC invalido -- barulhento e imediato.
    TRES DECISOES DO FORMATO, que valem mais que o codigo
    1. duas subchaves, nao uma. KBEK cifra, KBAK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
    [hsmtool.py, kat.c, kat.h, kat_vectors.h, tb_tr31_block.v, test_tr31.py]
2026-08-30 ZEROIZE: apagar e o facil; provar que apagou e o trabalho
    Comando 0x2F, mais dois defeitos encontrados no caminho -- um no
    firmware e outro na ferramenta de teste, e o da ferramenta e o pior.
    O COMANDO
    estados TODOS, TAMPERED inclusive. E o unico com essa mascara.
    Um dispositivo que nao se deixa apagar nao garante nada
    alem de que a chave continua la, e em TAMPERED e
    exatamente quando se quer apagar. De la nao se SAI:
    apaga e continua comprometido, e isso sai de graca
    porque state_set() ja e absorvente.
    dual control SIM -- e a assimetria com o gatilho automatico e o
    ponto. O autotest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
2026-08-31 Comandos de chave 0x22-0x25, e a fase 3 validada em bancada
    GEN_KEY, EXPORT_KEY, IMPORT_KEY, KEY_INFO. Os quatro em ST_OPER, e
    NENHUM com dual control -- dual control e para CERIMONIA, nao para
    operacao. Carregar a chave mestra e apagar tudo sao eventos raros, com
    gente na frente da placa; gerar e exportar chave e o que um HSM faz o
    dia inteiro. Exigir dois dedos ali nao aumentaria seguranca nenhuma, so
    garantiria que ninguem usa o equipamento -- e um controle que impede o
    uso legitimo e desligado no primeiro dia ruim.
    O que protege esses quatro e estrutural: a chave nunca sai em claro, o
    key block e autenticado sobre cabecalho MAIS corpo, e `exportabilidade`
    decide quem pode sair -- por UM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
2026-08-31 Rumo: aderencia ao padrao comercial antes de qualquer variacao propria
    Decisao do Flavio em 2026-08-31: o objetivo e APRENDER A USAR um HSM
    comercial. Entao, em comandos e em experiencia de uso, este dispositivo
    segue o padrao da categoria; ideias proprias vem depois, e so depois de o
    padrao estar implementado e entendido.
    A regra pratica: diante de uma escolha, a pergunta nao e "o que seria
    melhor" -- e "o que um HSM comercial faz". Divergencia vira ideia
    registrada, nao implementacao.
    Por que a regra vale mais que o julgamento caso a caso: um projeto
    didatico que "melhora" o modelo enquanto o ensina produz alguem que
    aprendeu o projeto, nao o assunto. As decisoes de um HSM comercial que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
2026-08-31 Lacuna de aderencia: formar chave de trabalho a partir de componentes
    Hoje uma chave de trabalho so nasce de dois jeitos: gerada internamente
    pelo DRBG (GEN_KEY) ou vinda de um key block que alguem ja tinha
    (IMPORT_KEY).
    Falta o terceiro, e e o que mais aparece na pratica: MONTADA POR
    CUSTODIANTES, cada um entrando com a sua parte. E assim que uma chave
    combinada entre duas instituicoes entra no equipamento sem que nenhuma
    das duas veja a chave inteira -- o mesmo split knowledge da cerimonia de
    LMK, aplicado um nivel abaixo.
    A diferenca de destino e toda:
    componentes -> XOR -> chave mestra fica DENTRO, sem handle
    componentes -> XOR -> chave de trabalho sai EMBRULHADA, key block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
2026-09-01 Usar a chave guardada: 0x27 ENCRYPT e 0x28 DECRYPT
    Ate aqui o dispositivo sabia GUARDAR, EXPORTAR e IMPORTAR chave, e nao
    sabia USA-LA. Um cofre que nao deixa trabalhar com o que guarda e um
    deposito.
    0x27 ENCRYPT handle(1) || iv(16) || dados -> dados cifrados
    0x28 DECRYPT handle(1) || iv(16) || dados -> dados em claro
    A FUNCAO DE MODO NAO TEM PARAMETRO DE CHAVE
    E a decisao que carrega o resto. O CBC saiu do tr31.c para um
    fw/src/aes_modos.c novo, e `aes_cbc()` opera sobre a chave que JA ESTA
    carregada no coprocessador. Sem parametro de chave, nao ha como a funcao
    de modo ver material de chave nem deixa-lo num buffer esquecido.
    Quem carrega e quem tem direito:
    keystore_usa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
2026-09-01 Remover AES_ENC e AES_DEC; o HMAC fica ate haver MAC por handle
    0x10 e 0x11 recebiam a CHAVE NO PAYLOAD. O argumento que estava no
    codigo -- "chave em claro nao pode coexistir com chave de verdade" --
    era o fraco: fazia o problema parecer de ESTADO, resolvivel com
    mascara.
    O forte, que so apareceu quando o Flavio perguntou por que o `aes`
    respondia com o dispositivo vazio: um comando assim faz material de
    chave ATRAVESSAR A FRONTEIRA na direcao de ENTRADA, e isso e errado em
    UNINITIALIZED tanto quanto em OPERATIONAL. Defeito que nao e de estado
    nao se conserta com mascara de estado -- so com remocao.
    E o mensuravel, que estava no plano desde o inicio e eu nao tinha
    ligado aos comandos: o c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
    [cmd.c, cmd.h, hsmtool.py, tb_uart_frame.v]
2026-09-26 ENCRYPT/DECRYPT validados em hardware, e o criterio da fase fecha
    A simulacao ja provava; faltava o silicio. Sessao completa de bancada,
    com os botoes apertados por gente.
    KCVs previstos componentes 749629 / 85053C / 6285D1, LMK 1DED8C
    todos calculados no host ANTES de perguntar a placa
    gen-key handle 1, KCV C031D1
    export/import handle 2, KCV C031D1
    encrypt 1 D9F91B5399080DEC363CED65B628C6F9
    encrypt 2 D9F91B5399080DEC363CED65B628C6F9
    decrypt 2 00112233445566778899AABBCCDDEEFF
    modo 'E' cifra ok decifra -> BAD_KEY_USE
    exp 'N' exporta -> NOT_EXPORTABLE cifra ok
    keycycle -n 100 C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
2026-09-26 MAC por handle, e o fim da chave em claro neste dispositivo
    0x29 MAC_GENERATE e 0x2A MAC_VERIFY. Com eles o HMAC (0x13) -- o ultimo
    comando que aceitava CHAVE NO PAYLOAD -- pode sair, e saiu.
    ⚠ HOJE NENHUM COMANDO DESTE DISPOSITIVO ACEITA CHAVE EM CLARO. E a frase
    que o cmd.h passou a poder dizer. Cada remocao so aconteceu depois de o
    substituto existir:
    0x10 / 0x11 -> 0x27 ENCRYPT / 0x28 DECRYPT
    0x13 -> 0x29 MAC_GENERATE / 0x2A MAC_VERIFY
    CMAC E NAO HMAC: os slots guardam chaves AES, e usa-las para HMAC seria a
    confusao de tipo que o resto do projeto passa o tempo todo evitando. CMAC
    e o que a categoria usa para MAC de dados com chave AES, e ja estava
    validado contra o C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
2026-09-26 Correcao: o defeito nao e a chave em claro no fio, e a porta compartilhada
    Observacao do Flavio, e ela desfaz uma leitura errada que eu tinha
    acabado de registrar em 0ffe931.
    O QUE EU ESCREVI, E POR QUE ESTAVA INCOMPLETO
    Registrei que o criterio da captura da UART nao fecha porque "os
    componentes da LMK atravessam a UART EM CLARO". Isso trata material de
    chave num fio como defeito em si, e nao e.
    A porta de console de um HSM de pagamento comercial e uma serial comum,
    e os componentes digitados ali atravessam o cabo em claro exatamente do
    mesmo jeito. O controle nunca foi criptografico: e AMBIENTAL e
    PROCEDIMENTAL -- sala controlada, acesso registrado, dois custodiantes,
    dual control. Chav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
2026-09-27 DELETE_KEY e chave por componentes: os dois que faltavam na fase 3
    Nenhum dos dois estava no plano. Os dois apareceram USANDO o
    dispositivo, nao planejando-o -- e isso vale como metodo: a lista de
    comandos de um plano e uma hipotese, e usar o equipamento em laco e o
    que a corrige.
    0x2B DELETE_KEY -- devolve um slot ao pool
    Sem dual control, ao contrario do ZEROIZE, e a assimetria e o argumento:
    apagar UM slot e reversivel (o key block daquela chave continua
    existindo fora, e reimportar devolve tudo), apagar TUDO nao e.
    ⚠ DESVIO DO CHECKLIST QUE EU MESMO TINHA REGISTRADO. Ele dizia que slot
    vazio e handle invalido deviam devolver o MESMO codigo, "senao e um mapa
    do key store". Esse mapa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
    [cmd.c, cmd.h, hsmtool.py, keystore.c, keystore.h, tb_keystore.v]
2026-09-27 Bancada: componentes, DELETE_KEY, MAC por handle e keycycle 100/100 em hardware
    Sessao de 2026-09-27, com os valores esperados calculados no host antes
    de a placa responder:
    - KEY_FROM_COMPONENTS (0x2C): duas partes montam a chave do
    ECBKeySbox256, KCV 46F2FB, e ela cifra identico a um AES independente.
    A resposta "2 de 2, handle 1" valida no silicio a correcao da ordem
    de leitura do acumulador.
    - DELETE_KEY (0x2B): devolve o slot; apagar de novo da BAD_PARAM.
    - keycycle -n 100: 100 de 100 nas duas direcoes, pela primeira vez.
    A direcao Python -> C parava em ~12 por falta de slot.
    - MAC_GENERATE/MAC_VERIFY (0x29/0x2A): tag igual a um CMAC calculado no
    Python a partir do key block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
2026-10-16 Fase 4: LMK, estado e chaves persistem na flash; log de auditoria
    A flash SPI (MT25QL128, a mesma do bitstream) passa a guardar, a partir de
    4 MB, o registro persistente e o log de auditoria. Por decisao do usuario
    em 2026-10-15, essa regiao e TRATADA como memoria segura -- o papel da
    memoria com bateria de um HSM comercial -- e a LMK fica nela em claro. A
    placa nao tem lugar seguro para ela (eFUSE proibido, BBRAM sem bateria,
    sem involucro com deteccao de violacao); a justificativa abre
    doc/fase4-notas.md, e a regra 2 do CLAUDE.md foi reescrita. Limitacoes
    documentadas, nao mitigadas.
    Hardware: SPI do NEORV32, CCLK pela STARTUPE2, IMEM 32 KB, DMEM 16 KB.
    Timing +0,258 ns, 0 critical warnin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
2026-10-18 Bancada da fase 4: LMK e chaves sobrevivem ao desligamento
    Validado com os botoes em 2026-10-18: ceremonia (KCV 374575, previsto
    pelo host), activate, duas chaves, desligar e religar -> OPERATIONAL sem
    ceremonia, mesmos KCVs, mesma cifragem e mesmo MAC. post restaura da
    flash; zeroize + religar volta em UNINITIALIZED com o log intacto.
    Observacao em aberto, registrada sem conserto: um de tres religamentos
    completos nao deixou registro de boot; nao reproduzido.
    Claude-Session: https://claude.ai/code/session_0182YKqCUMFbV9SkZyTpjfPL
2026-10-18 PLANO: ideia registrada -- quantidade de componentes da LMK configuravel
    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
2026-10-18 LMK zerada e recusada no terceiro componente
    Se o ultimo componente for o XOR dos anteriores, a LMK resultante e 32
    bytes de zeros. O firmware recusa com BAD_PARAM e a cerimonia recomeca em
    0 de 3 -- nao ha como saber qual componente estava errado. LMK fraca nao
    e checada, por decisao do usuario: a qualidade do componente e do
    custodiante.
    Checklist (comando existente, 0x20):
    - estados: inalterado, so UNINITIALIZED
    - dual control: inalterado; a recusa acontece depois da autorizacao,
    porque o zero so existe com o terceiro componente
    - vazamento: um bit -- "a soma dos tres seria zero" --, que quem escolheu
    os tres componentes ja sabe
    - exportabilidade: nao se aplica
    - log: registrado ante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
2026-10-18 Exportabilidade 'S': a lacuna era leitura invertida da norma
    A documentacao dizia que 'S' ("sensivel") seria mais estrito que 'E' e
    que o dispositivo prometia uma regra que nao cumpria. Na X9.143 e o
    contrario: 'S' e o valor mais permissivo -- libera, alem de key block,
    formatos legados (criptograma simetrico, embrulho RSA). Como este
    dispositivo so exporta em key block, 'S' se comportar como 'E' esta
    certo. Nenhum codigo muda; corrigidos o comentario em keystore.h,
    doc/fase3-notas.md 6a, CLAUDE.md e o manual (PDF regerado).
    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
2026-10-18 tb_hmac_kat: comentario apontava para o hsmtool hmac, removido com o 0x13
    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
2026-11-03 Fase 5: porta host com command set ASCII
    O firmware interpreta o ASCII; no PC fica so a ponte TCP<->UART
    (host/hsm_ponte.py), que repassa LEN + mensagem sem entender. Console
    (binario, hsmtool) e host (ASCII, hsmhost) separados por protocolo na
    mesma UART: o primeiro byte do corpo em 0x30..0x7E e ASCII. A chave de
    trabalho chega como key block sob a LMK em cada comando e vive so no
    slot efemero (handle 17), apagado ao fim de todo comando.
    Comandos: D0 diagnostico, K0 gerar, K2 conferir bloco, C0/C2 AES-CBC,
    M0/M2 CMAC. Codigos de comando e de erro sao deste projeto.
    Checklist:
    - Estados: D0 em todos; K0/K2/C?/M? so em OPERATIONAL (erro 20).
    - Dual control: nenhum -- a porta host nao tem co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
2026-11-03 Bancada da fase 5: porta host validada em hardware
    Cerimonia com tres componentes --random; KCV da LMK 6935C4 igual no
    console, no D0 da porta host e no Python. hsmhost.py confere: 10 de 10
    pela serial direta e 100 de 100 pela ponte TCP, cada volta com
    K0/K2/C0/C2/M0/M2 conferidos contra AES e CMAC independentes e uma tag
    adulterada recusada com 01. O audit mostra os comandos como HOST xy.
2026-11-03 hsmtool kcv: KCV de componentes e do XOR deles, sem placa
    A conta do custodiante: confere o que lmk-load/comp-load e lmk-status
    mostram, e com --mostra da a chave montada que o hsmhost confere --lmk
    pede. Conferido com a cerimonia de 2026-11-03 (6F34C1, 8AD3EA, 3057EF ->
    6935C4).
2026-11-03 K4/K6: exportar e importar sob KEK, na porta host
    Fecha a lacuna 6b da fase 3: a exportacao deixa de ser "sempre sob a
    LMK" e passa a ser para quem. Uma KEK (uso K0), formada por componentes
    no console (comp-load --uso K0) e guardada pelo host sob a LMK, protege
    a chave em transito para outra instituicao.
    K4 bloco da KEK + bloco da chave (sob a LMK) -> chave sob a KEK
    K6 bloco da KEK (sob a LMK) + chave sob a KEK -> chave sob a LMK
    No key store: keystore_kek_deriva() (subchaves da KEK, so uso K0 e o
    modo certo), keystore_embrulha_kek() (recusa 'N' pela mesma exportavel()
    estatica de keystore_exporta()) e keystore_embrulha_lmk(). O registro
    persistente passou a usar o mesmo embrulha_s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
2026-11-04 Doc: passo a passo de uso da KEK (K4/K6)
    fase5-notas ganha o roteiro com os comandos: KEK formada com os mesmos
    componentes nos dois dispositivos, conferencia pelo KCV (hsmtool kcv
    preve sem placa), KEK guardada no host como bloco sob a LMK, K4 de um
    lado e K6 do outro, e a KEK de mao unica com modo E/D. O manual (sec. 30)
    recebe os cinco passos em prosa. PDF regenerado.
2026-11-04 Doc: checagem do uso decidida, para a proxima sessao
    D0 para cifrar/decifrar, familia M para MAC, nas duas portas, em
    keystore.c ao lado da checagem de modo, recusa 11/BAD_KEY_USE. Plano,
    testes afetados e ordem de trabalho no fim de doc/fase5-notas.md;
    ponteiro no CLAUDE.md. Nada de codigo ainda.
2026-11-05 Checagem do uso: cifrar exige D0, MAC exige a familia M
    O uso do key block passa a restringir as operacoes junto com o modo, nas
    duas portas, em keystore.c. Recusa: 11 no host, BAD_KEY_USE no console.
    KEK, chave de PIN e BDK nao cifram dados, qualquer que seja o modo. Gerar
    continua livre. Chave de MAC agora e M0; uma D0 de modo C deixa de autenticar.
    A propriedade entra no POST. O limite do tb_keystore sobe de 300 para
    600 ms: o passo novo termina em 321 ms, era orcamento e nao travamento.
    Validado em hardware: confere com 100 de 100 voltas pela ponte, e
    BAD_KEY_USE no console. Timing +0,258 ns, 0 critical warnings.
    Claude-Session: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
2026-11-05 Fase 6: sensores do XADC, perda de lock e resposta a violacao
    Temperatura e tensao fora da faixa do DS181, sensor parado ou perda de
    lock do MMCM apagam as chaves sem comando e levam a TAMPERED. O hardware
    detecta e retem sem reset; fw/src/ambiente.c responde. A resposta apaga a
    BRAM antes de gravar o log, excecao decidida pelo usuario.
    clk_rst_gen.v pulsa o RST do MMCM depois de perder lock: sem isso a CPU
    ficava presa em reset e a LMK continuava na flash (achado pelo tb_tamper).
    SELFTEST nao restaura em TAMPERED, e AUDIT_READ responde nesse estado.
    Comando novo 0x2E ENV_READ (hsmtool env):
    - Estados: todos, TAMPERED inclusive.
    - Dual control: nao.
    - Em laco: entrega temperatura, tensoes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
2026-11-06 Fase 6: glitch de clock e dupla execucao com erro grave
    Injetor de falha por BUFGMUX, so no bitstream de ataque (HSM_ATAQUE): escuta a
    linha RX e nao fala com a CPU, para o firmware atacado ser o de producao. O DRP
    do MMCM foi descartado: a XAPP888 exige reset, e reset nao e pulso.
    Contramedida: o que sai ao host e calculado duas vezes, com a chave carregada
    antes de cada execucao. Carregar uma vez so era falha de modo comum, e a placa
    mostrou resultados errados com CRC valido. Discordou: CRYPTO_FAIL (0x32, 91 no
    ASCII), nada sai, as chaves ficam, e o erro grave vale ate o proximo boot.
    Status novo, sem comando novo. ENV_READ ganha o bit 0x80 no retido.
    - Estados: os mesmos de ENCRYPT, DEC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
2026-11-06 Fase 6: experimento de RO-PUF, medido na placa
    64 aneis com uma rota so, bitstream proprio sem CPU, carga termica e
    limites de temperatura e VCCINT no hardware. tb_puf cobra o protocolo e
    as guardas. host/puf.py le, analisa e dimensiona o corretor.
    Resultado em doc/puf_resultados.md: BER 2,3% e 3,8%, sem tendencia ate
    48 C, e a resposta depende do bitstream, o que a recarga confirma.
    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
2026-11-08 Fase 7: verificacao RSA-2048 -- Montgomery no CFS, KAT no POST e comando R4
    - rtl/crypto/rsa_mont.v: produto de Montgomery FIOS, limbs de 16 bits, 4 DSP,
    tempo constante (subtracao final sempre), modulo so de escrita, wipe.
    Pagina 0x200 do CFS.
    - fw/src/rsa.c: exponenciacao publica e verificacao PKCS#1 v1.5 SHA-256,
    montando o EM esperado e comparando inteiro.
    - POST com KAT do CAVP (SigGen15): aceita a valida, recusa a adulterada.
    SELFTEST devolve a mascara em dois bytes (RSA = 0x100). POST: 28,27 ms.
    - Limite de mensagem: 2048 bytes.
    - hsmhost.py: rsa-verify e rsa-cavp.
    - Testbenches: tb_rsa_mont, tb_rsa, t_rsa no tb_cfs. Botoes por 1 ms;
    janelas do tb_soc_silent (32 ms) e tb_pos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
2026-11-09 Fase 7: metade privada do RSA-2048 -- key block, CRT, geracao e comandos R0/R2
    Chave privada em key block X9.143 (uso S0, algoritmo R, modo S), com layout
    proprio decidido pelo usuario: e(4) p q dp dq qinv, 644 bytes. Os dois parsers
    (tr31.c e tr31.py) mudam juntos.
    Assinatura PKCS#1 v1.5 por CRT, com escada de Montgomery em tempo constante e
    toda multiplicacao no coprocessador. A assinatura e verificada com e antes de
    sair (Bellcore): reprovou, 91 e erro grave marcado.
    Geracao de chave pela FIPS 186-5, A.1.3: divisao por primos pequenos,
    Miller-Rabin com 5 rodadas, |p - q| > 2^924, e = 65537 e PCT.
    Comandos ASCII novos:
    R0 gerar par RSA (exportabilidade -> key block . n . e)
    R2 assin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
2026-11-10 Fase 7: R4 verifica duas vezes, WIPE da interface RSA e suite paralela
    - R4: a verificacao roda duas vezes; discordancia -> 91 e erro grave
    marcado (regra da fase 6: o que vai ao host e calculado duas vezes).
    Checklist: estados e dual control inalterados (OPERATIONAL, sem dual
    control); em laco vaza so o bit de aceite, inerente ao servico; sem
    chave, exportabilidade nao se aplica; log antes da execucao, como antes.
    - hsm_cfs.v / rsa_mont.v: o WIPE zera wdata, n0p, len, addr, dst, a, b.
    tb_cfs e tb_rsa_mont conferem.
    - sim.sh: criterio de FAIL, timeout por testbench, tempos.csv, e a suite
    roda 3 testbenches por vez (SIM_JOBS), cada um no proprio diretorio.
    - Timing +0,337 ns, 0 cr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
2026-11-10 Manual: so conceitos e uso; historico de construcao fica nas notas de fase
    - Parte V vira "O equipamento hsm-a7": sai a 25 (resultados medidos) e a
    26 (licoes); a 24 descreve a plataforma sem historico.
    - Parte VI vira "As funcoes, fase a fase": saem narrativas de construcao,
    datas, criterios de aceitacao e series de medidas; afirmacoes
    desatualizadas corrigidas.
    - Secoes 27-39 renumeradas para 25-37, com as referencias cruzadas;
    corrigidas cinco referencias do glossario que ja estavam erradas.
    - Capa e doc/README.md atualizados; aviso sem "sensores fisicos" (o XADC
    existe desde a fase 6).
    - fase4-notas recebe o custo da fase, que so estava no manual.
    - PDF regenerado: 81 paginas.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
2026-11-14 Fase 7: ECDSA P-256 -- mesmo coprocessador, key block e comandos E0/E2/E4
    ECDSA sobre a P-256 no firmware (fw/src/ecc.c), com os produtos modulares
    no core de Montgomery do RSA (len = 16). Nao ha RTL novo. Escada de
    Montgomery co-Z com 14 produtos por bit, escalar regularizado, k e d por
    rejeicao a partir do DRBG (FIPS 186-5), chave publica validada, e a
    assinatura verificada antes de sair. ECDH ficou fora, por decisao do
    usuario.
    - mont.c e bn.c: extraidos de rsa.c, comuns ao RSA e ao ECDSA
    - key block S0/E/S, layout proprio d||Qx||Qy (96 bytes), em tr31.c e
    tr31.py
    - IMEM de 32 para 64 KB (firmware: 37 668 bytes)
    - autotestes de primeiro uso (FIPS 140-3): assinatura RSA e ECDSA rodam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
